qyq11/opto-chess-robot-2027/01_docs/02_design/05_底盘串口接线与测试.md

---
slug: /design/motor-uart
sidebar_position: 5
---

# 底盘串口接线与首轮测试

更新：2026-11-05。适用方案：泰山派3M RK3576通过40针排针的硬件串口，直接控制亚博四路编码器电机驱动，不加STM32。网页已接前后左右四向试转；历史“只查询”阶段及电脑USB台架流程保留，分别登记验证范围。

本文是本车直连驱动的接线、厂家命令用法与验收边界的统一入口。驱动线上使用厂家原协议，项目不另外增加帧头、序号或校验字段。任务勾选只在[开发计划](../01_plans/01_开发计划.md)维护，实际结果统一见[底盘串口记录](../03_records/04_20261030_底盘串口调试.md)。2026-11-05已在无电脑USB供电下取得真实查询和网页架空慢速前后、停车的阶段结果；用户随后确认四向实际移动均可以，按用户现场报告登记基础移动已打通。地面距离与跑偏、准确轮速、带载供电及异常停车仍未验收。

## 相机网页前后与左右平移 {#web-motion}

电脑连接固定热点 `opto-robot-b`，打开[小车工作台](http://192.168.137.16:8080/)。页面左侧看相机画面，右侧选择速度、时间和运动方向；窄屏先显示画面，再显示控制区。更新后按Ctrl+F5刷新，点“读取驱动”，取得类型2、13线、减速比20、轮径65mm的完整真实配置，再架空并勾选现场确认。

目标轮速使用滑杆或数字框，范围2～30厘米/秒、每档1厘米/秒，默认6；运行时间1～10秒、每档1秒，默认3。按钮旁显示本次选值，前进、后退、左移、右移共用这组参数。左右以车头方向为准，表示保持车头朝向的横向平移。较高档位会提示先架空核对，可选择不代表各档都已实车验收。时间包含起步，短时间、高目标时可能尚未升到目标就结束。

### 四轮方向组合

采用[厂家麦轮原理说明](https://www.yahboom.net/study/RASPBOT-V2/12113/)中的X形安装：俯视四轮小滚子的轴线呈X形。本车通道顺序为左前M1、左后M2、右前M3、右后M4。下表正号表示该轮让车前进时的转向；发送时再乘该轮的接线方向校正值。

| 动作 | 左前M1 | 左后M2 | 右前M3 | 右后M4 |
| --- | --- | --- | --- | --- |
| 前进forward | + | + | + | + |
| 后退backward | − | − | − | − |
| 左移left | − | + | + | − |
| 右移right | + | − | − | + |

例如左移目标6厘米/秒，未反接时缓升到 `$spd:-60,60,60,-60#`；右移为 `$spd:60,-60,-60,60#`。方向校正应先用前进确认每个车轮，不能通过只改某一轮来把左右互换。架空时只能检查轮组、方向和停车；车身是否平移、是否跑偏必须在实际地面另测。轮序或麦轮左右旋安装不符时，先修正安装和通道对应。

### 起步、调速与停车

点击任一方向后，RK先以20毫米/秒起步，每约200毫秒向本次目标增减最多20毫米/秒，最后一步停在所选目标，不越过目标。四轮分别按上表取正负号；各轮接线方向可在停止后校对。网页显示本次方向、剩余时间、当前目标和驱动实际回报的轮速，按左前M1、右前M3、左后M2、右后M4排列。

运行时修改参数输入，默认作为下一次设置。若要改变正在运行的速度，点“应用当前速度”；只改变目标并缓慢变速，保留原停止时刻。时间输入的变化只对下一次启动生效，本轮没有“给当前动作续时”的按钮。运行中拒绝再次启动和直接反向，先停稳再换方向。“停止输出”始终可点，运行时也可按Esc。

RK独立线程计时，到时依次发送零速度 `$spd:0,0,0,0#` 和零输出 `$pwm:0,0,0,0#`。停止后作废旧请求的状态序号，防止延迟点击重启动作；串口发送错误后拒绝继续启动。开始时临时发送 `$upload:1,0,1#` 开启编码器计数和轮速回报，本次原定停止时间结束约0.7秒后关闭。启动后250毫秒没有有效轮速反馈，会尝试归零、撤销可启动状态，提示排查供电与串口后重新读取驱动。

软件停车依赖RK及串口仍工作，不能保证整板死机、断线或动力异常时停车。驱动按编码器计算的轮速须与实物对照，不能直接当作准确车身速度、位移或外部测速结果。地面与独立失联保护仍按第6节验收。

### 网页与RK接口

由原服务参数 `--motor-port /dev/ttyS4` 启用。`GET /api/motion`只读状态，包含允许范围 `limits`、本次目标和时间、`remaining_ms`剩余毫秒、`active_speed_mm_s`当前发出的目标档位、`actual_mm_s`四轮实际回报及原始收发。无有效采样时实际速度为null，不补造零速。

`POST /api/motion`使用表单编码及 `X-Motion-Control: 1` 请求头；写入操作只允许来自本页。参数由RK独立检查，不能依靠滑杆限制；不接受任意串口文本或直接输出测试请求。

| action操作 | 使用参数 | 行为 |
| --- | --- | --- |
| query读取驱动 | 无需运动参数 | 归零后只查询当前配置，不写保存参数 |
| forward前进、backward后退、left左移、right右移 | generation状态序号，speed_mm_s目标轮速，duration_ms运行时间，可附m1～m4接线方向校正 | 只在就绪且已停止时启动，运行中拒绝再次启动或换方向 |
| speed应用当前速度 | 仅action、generation、speed_mm_s三项 | 仅正在运行时接受；不改变方向、原截止时间或反馈窗口 |
| stop停止输出 | 不需要状态序号 | 随时尝试归零；停止后旧序号作废 |

网页速度乘10传为毫米/秒，RK允许20～300、步长10；秒数乘1000传为毫秒，允许1000～10000、步长1000。四向请求省略速度或时间时，兼容使用默认60毫米/秒、3000毫秒；页面正常操作会明确提交。空值、负数、小数、超限或错误步长均拒绝。speed请求必须明确提交速度，并拒绝附带时间或方向。临近截止时到达的调速请求也不能重启动作。

正式程序：[C运动控制](../../02_programs/01_host/03_camera/motor_control.c)、[网页脚本](../../02_programs/01_host/03_camera/web/motion.js)、[控制区样式](../../02_programs/01_host/03_camera/web/motion.css)。方向设置不写驱动、不保存，刷新恢复初始值。运行期间页面隐藏或关闭会尽力补发停止，原截止时间仍由板端执行。

2026-11-05已完成板B原生编译、虚拟串口的范围/缓升/调速不续时/停车检查及部署。用户确认新版布局正常、变速后按原定时间停止，随后确认左右架空轮组相反、都能自动停止，进一步确认前后左右实际移动均可以。参数检查见[参数改版记录](../03_records/04_20261030_底盘串口调试.md#web-motion-controls-20261105)，左右实际收发见[同一底盘记录的左右试转](../03_records/04_20261030_底盘串口调试.md#web-motion-lateral-20261105)，新增报告见[四向移动用户确认](../03_records/04_20261030_底盘串口调试.md#ground-motion-confirmation-20261105)。其余档位、地面距离与跑偏仍按[开发计划](../01_plans/01_开发计划.md#motion-controls-plan)推进。

## 网页按距离前进 {#web-distance}

首版已完成源码准备，待板B上电后检查和部署。新版页面仍从原小车工作台打开。点击“读取驱动”，按第6节确认现场可停机，再在“按距离前进”勾选现场确认，输入5～50厘米的整数，默认20厘米，点击“前进指定距离”。可以随时点“停止输出”或按 Esc。

RK等到第一帧四轮累计计数才发出起步速度，然后比较后续计数与起点的差值。按65毫米轮径、13线、减速比20，首版暂用双相四倍计数，即每轮转一圈约1040计数。四轮按各自方向校正后求平均，得到网页上的轮子估计距离。旧日志中轮速最小变化约19.63毫米/秒，与这一换算下每10毫秒增加1计数相符。轮子有效周长、计数与车身位移仍以架空和地面实测为准。[厂家串口示例](https://www.yahboom.net/study/Quad-MD-Module/13998/)

板端从2厘米/秒起步，最高目标轮速为6厘米/秒，估计剩余4厘米内逐步降到2厘米/秒。达到目标时依次发 `$spd:0,0,0,0#` 和 `$pwm:0,0,0,0#`，短时继续采集计数以记录停车后的少量转动。未收到计数基准、反馈中断、计数突变、明显反向、持续无进展或运行满15秒时尝试停车，并在页面显示原因。估算和软件停车依赖驱动反馈、RK及串口。现场停机与失联保护仍按[第6节](#6-异常测试与落地条件)核对。

沿用 `POST /api/motion`。定距离使用 `action=distance`、`generation` 和 `distance_mm`，可附各轮方向 `m1`～`m4`。距离使用50～500毫米、每档10毫米，页面换算成厘米。定距离运行期间由RK管理轮速。状态接口提供四轮累计计数 `encoder_counts`、估计距离 `estimated_mm`、剩余距离 `remaining_mm` 和停车原因 `stop_reason`。

### 上板和尺测

在项目根目录打开 PowerShell。板B接入热点后，下面命令核对板B专用SSH指纹和序列号，上传源码、在板端编译并通过虚拟串口检查两种控制方式。无线地址变更时用热点显示的实际地址。

```powershell
& .\02_programs\01_host\03_camera\prepare_distance.ps1 -BoardHost 192.168.137.16
```

通过后，用下面命令复跑检查、备份现有工作台并部署。部署后检查网页按钮、运动接口和相机新画面。整个脚本通过读取接口核验服务，真实电机动作由现场用户点击启动。[部署脚本](../../02_programs/01_host/03_camera/prepare_distance.ps1)

```powershell
& .\02_programs\01_host\03_camera\prepare_distance.ps1 -BoardHost 192.168.137.16 -Install
```

首轮先架空检查计数变化、各轮方向和停车。落地条件就绪后，在平整地面贴起点，用车身同一位置作参考点。点击“前进指定距离”走20厘米，停稳后记下网页估计值和停车原因，用尺子量沿预期方向的实际位移，同时记侧向偏移和车头朝向。将目标、估计、尺测、轮速及串口收发记到同一份底盘调试记录。[原底盘调试记录](../03_records/04_20261030_底盘串口调试.md)

## 本轮只查询（2026-11-04）

本轮只完成“RK发送一条不改变配置的查询 → 驱动真实回复 → RK接收并显示”。用户确认UART4三根线按下述关系接好。外部供电时两次查询均无回复，用户报告3V3仅约2V；电脑USB接驱动Type-C后恢复约3.3V，16:49的RK配置查询收到150字节有效回复，阶段链路已打通。当前供电排查见[同一记录](../03_records/04_20261030_底盘串口调试.md#usb辅助供电后配置查询通过)，不将USB条件下的结果套用为电池独立供电。相机换过接口，本次未操作相机服务。下文转轮、参数写入、零PWM和反馈开关流程保留供以后选用，本轮均不执行。

先看[整机接线总图](../../05_data/03_results/01_design/04_稳压板接线示意.png)：电源、串口和输入输出已放在同一张图，虚线为拟接且尚未验证。图示不能替代实物针位、电平与极性核对。

2026-11-05补充：更换Wi-Fi后，已改经电脑USB网口的本地IPv6连接板B，再次完成一次配置查询和150字节真实回复，见[有线复测](../03_records/04_20261030_底盘串口调试.md#uart-recheck-20261105)。电脑网口编号从此前7变为6；使用前按实际网卡状态重新核对。本次未重新核供电接法、电压或电机动作。

已协调同板窗口后，对序列号 `8314b1e8ffd0321f` 的板B完成只读检查：`/dev/ttyS4` 指向设备树 `serial@2ad70000`，GPIO2_D0/D1当前复用为UART4；未见程序打开该口，系统登录使用 `ttyFIQ0`。因此**优先UART4**，对应规格书物理8脚TX、10脚RX、6脚GND。节点与复用已实查，实物硬件版本、排针方向和双方电平仍待确认，不能直接把“节点存在”当成可以接通。证据见[同一底盘记录](../03_records/04_20261030_底盘串口调试.md#rk串口选择与接线准备2026-11-04)。

三根信号线的功能关系仍为RK TX→驱动RX2、RK RX←驱动TX2、GND互连；驱动插头5V不连接RK。必须先对应实际丝印，电平兼容后在双方断电时接拆；同板现有程序需保留，涉及断电先与移植窗口协调，不直接拔电。

接好后使用[C/GCC查询程序](../../02_programs/01_host/04_motor_uart/motor_query.c)，显式指定已核实节点，115200波特、8数据位、无校验、1停止位、无流控；一次只发送 `$read_flash#`，或按实际排查选择 `$read_vol#`，不加额外换行、不自动重发。**配置查询的真实回复是以 `read_flash:OK!` 开头的多行文本，不含 `#` 结束符；电压回复才是 `$Battery:…V#` 帧。** 程序分别识别，保存原始字节后再解析；配置必须包含完整字段和末行换行，截断或仅回显命令不能通过。程序已完成ARM64 GCC交叉编译、静态检查及板B原生GCC编译运行，USB辅助供电后的150字节配置已正确解析；连接、操作命令和原始结果见[同一调试记录](../03_records/04_20261030_底盘串口调试.md#usb辅助供电后配置查询通过)。

## 电脑先调试

2026-10-30用户首次查询显示固件1.7.3及520默认配置；12:17:34的后续日志已确认本车310类型2、13线、减速比20、65mm轮径读回正确，详见[同一份记录](../03_records/04_20261030_底盘串口调试.md#参数修改后的读回确认)。随后用户确认电机接线正确，但12:20仍只接USB、没有动力电池，尝试转轮无动作且没有新回包；重新拔插USB后，12:23:06配置查询恢复，四项参数仍正确。最新用户报告驱动板、稳压板已接通电源，串口已连接；尚未提供本次电压、配置回包或电机动作结果。当前先保持零输出，查询电压和配置；转轮、停车和先前无回包的根因仍待验证。以下配置命令保留供复现，读回正确时不重复写入。电脑上的串口助手只负责发送厂家命令，不需要另加STM32或重烧驱动固件。

**最终电池为用户已有普瑞莱11.1V／2200mAh电池，充电截止12.6V、最大持续4A。现用旧小车电源模块的型号与输出能力待核。本轮供电优先采用[11.1V电池经旧模块输出5V的轻载接法](./03_系统规划.md#现有111v电池的5v轻载试验接法2026-10-30)。** 下文2S电池直接供动力的内容保留作该方案说明，不用于当前11.1V电池。当前驱动输入应为稳压后的约5V，用万用表实测驱动动力端子，并与查询值比较；仍回复先前的3.9V、无有效回复或读数明显不符时先排查，不发送非零速度。不能把11.1V电池直接接入当前310动力支路。本轮只安排单轮架空短测，四轮及RK同时带载供电尚未验收。

### 软件与串口设置

当前实际测试电机按此前确认接驱动板M3（第3路），最新用户已报告驱动板与稳压板通电。先前仅USB供电时电压回复3.9V，不作为本次动力供电结果。下列电脑单轮流程已按M3调整；后面的RK四轮流程仍按M1–M4逐路验收。

厂家[UartAssist 5.0.3原件](../../03_hardware/01_机械/01_厂家资料/03_四路电机驱动/13_UartAssist_5.0.3.exe)及[电脑调试教程](../../03_hardware/01_机械/01_厂家资料/03_四路电机驱动/14_PC串口调试.pdf)已提取到正式资料目录。为把运行设置留在临时目录，调试时使用项目`temp/motor-uart/`里的软件副本。电脑通过USB数据线直接接驱动板Type-C口，不需要另外接USB转TTL小板；此阶段不接RK的TX/RX。

先在Windows设备管理器查看“端口（COM和LPT）”，比较插入/拔出这块板时新增/消失的串口。蓝牙串口不能作为电机驱动串口；若没有新增设备，先换确认能传数据的线、直连电脑USB口。若新增的是未知设备，按其硬件标识确认芯片和匹配驱动，不凭猜测安装。

串口助手左上角选择已确认的COM口，设置115200波特、数据位8、校验位NONE、停止位1、流控NONE。接收和发送均选ASCII（文本），不要选HEX（十六进制）；取消“自动发送附加位”“循环周期”，保留命令中的英文符号。点击“打开”后按钮应变成“关闭”，这只证明端口已打开，还要核对真实回包。不要用软件窗口关闭来代替电机停车。

### 断电后连接单台电机，当前用M3

先拔掉USB，保持电池未接。电机固定牢、轮子悬空，驱动板垫绝缘材料；碳纤维板导电，不能让焊点直接贴底板。先接一台310，其余三路空着。

若使用厂家原配PH2.0六针双头线，按厂家说明黑色端接310电机，白色端接驱动板编码器电机接口，并核实际插壳、锁扣和丝印；不强插反向插头。若电机端是六针插头、驱动端是六个分散杜邦头，按下表接驱动第3组IO插座，不凭线颜色或照片左右猜针序。

| 电机丝印 | 驱动板第3组信号 | 用途 |
| --- | --- | --- |
| M1 | 第3路动力M+ | 电机动力正端 |
| M2 | 第3路动力M− | 电机动力负端 |
| V | 3V3 | 编码器供电 |
| G | GND | 编码器地 |
| A | H3A | 编码器A信号 |
| B | H3B | 编码器B信号 |

电机本体的M1/M2是两根动力线，驱动板的M1–M4是四个电机通道，含义不同。M+/M−必须属于同一第3组，H3A/H3B也属于这一组。若实物丝印、线束或接口与资料不同，先拍清板上接口和六根线再核对，不能按此表猜物理位置。依据[厂家电脑教程](https://www.yahboom.net/study/MD310/14019/)及[310接法](https://www.yahboom.net/study/MD310/14018/)；厂家表中以第1组为例，此处按同样功能对应到第3组。

动力电源用本车7.4V/2S电池，满充8.4V。电池正极经已核实的保险/开关接驱动动力输入正极，负极接动力输入负极；按板上实际电源丝印核极性，不能接到辅助5V/3V3口。USB不作为电机动力电源。接电池前检查无裸铜相碰、轮子已架空、随手能切断动力。电源和线束未核实时先停在USB识别步骤。

### 动力是否需要经过稳压板

本车2S电池接电机驱动的动力支路，不经过5V稳压板；稳压板只在计算支路把电池电压降成5V给RK，接法见[系统规划第6.1节](./03_系统规划.md#61-电池降压板驱动到底怎么接)。当前只测电脑与电机，先核清动力支路，RK和稳压板暂不接入本次单轮测试。

| 部位标识 | 输入或输出 | 本车用途 |
| --- | --- | --- |
| 电池XT60主放电口 | 电池输出 | 经匹配取电线、保险/开关和分电接动力支路；不按插壳公母简称猜配对 |
| 驱动DC5V～12V的+／−端 | 驱动动力输入 | 接电池动力支路正负端，不接到电机M+/M−或辅助低压接口 |
| 稳压板IN+／IN−、DC6～24V-IN | 稳压板输入 | 接电池计算支路正负端 |
| 稳压板DC5V-OUT、Type-C输出 | 稳压板输出 | 给RK的Power Type-C供电 |

采购登记的电池是XT60，驱动附带线是T插到红黑裸线，两者不能直接对插。现有正式方案使用XT60取电及绝缘分电，不默认新增XT60转T插。实际是否缺线要按现物核对，不把裸线临时塞进电池插头，也不用小平衡插头承载电机电流。接电前先把软件发送框中的非零速度改成零PWM并发送，再关串口、拔USB；没有电源端子和线束实物依据时，先核照片而不按商品图位置猜正负。

2026-10-30已按用户指定京东链接核对[对应规格电池图](../../05_data/01_raw/04_hardware/20261030_battery_reference_01.jpg)：黄色XT60插孔端是主放电口，应使用配对的金属插针端成品取电线；白色小插头用于平衡检测和充电辅助，不接驱动动力。图和SKU核对过程见[同一调试记录](../03_records/04_20261030_底盘串口调试.md#按用户指定商品页核对电池插头)。在电池和USB断开时，动力支路红线经保险/开关接驱动DC5V～12V输入“+”，黑线接输入“−”，按实际丝印核极性。压好端头后插入夹线孔、拧紧并轻拉检查，最后才对插电池；现有取电线、保护件未确认配齐时不安排上电。

原配T插电源线并非不能使用：剥开的红黑线可接驱动动力端子，只是红色T插不能直接插黄色XT60。电脑单轮台架若保留原配线，可配XT60金属插针端至T插金属插孔端成品转接头，常见名称“XT60公转T插母”；按两端触点和极性核对，不能买反向版本。[厂家同方向产品](https://genstattu.com/xt60-male-to-deans-t-female-adapter/)仅作类型参考，未在本车实测。保险/开关仍需落实；正式整车分电主线保持原定义，不因临时台架配接增加一套重复采购。

### 先查询，再配置，最后短时转轮

以下每个代码块是要填入串口助手“数据发送”框的一条文本，只点击一次“发送”，不加引号。先按上述方式确认端口、接线和供电，保持零输出：

```text
$pwm:0,0,0,0#
```

查询配置，应收到包含电机类型、线数、减速比、轮径等字段的实际返回；只看到发送栏回显不算通信通过。

```text
$read_flash#
```

查询电压，应收到`$Battery:实际电压V#`形式的帧，并与电源测量核对。只接USB时查询是否回复取决于实际板卡供电设计；没有回复时不能立即判断为软件故障，也不要发送转动命令。

```text
$read_vol#
```

收到有效回包后，逐条配置，每条等待实际确认再继续。按本车310编码器A→A、B→B、13线、1:20、65mm轮设置；不能照抄厂家48mm轮径，也不改PID或恢复出厂。

```text
$mtype:2#
```

```text
$mline:13#
```

```text
$mphase:20#
```

```text
$wdiameter:65#
```

```text
$read_flash#
```

确认返回类型2、13线、减速比20、轮径65。保持零PWM，开启编码器总计数及轮速反馈，再手动慢转轮子，核对只有第3通道变化。

```text
$upload:1,0,1#
```

回包应含`$MAll:…#`和`$MSPD:…#`。手动转轮后放开，确定动力停机手段可用，再用下列命令测试第3路低速。提前把下面的停止命令加入软件“快捷指令”，确认如何单击发送；低速运行约0.5秒后立即发送零速度。若不能可靠完成短时动作和停止，先不要发送启动命令。这里的持续时间由操作者控制，速度命令本身没有持续时间字段。

速度单位为mm/s（毫米每秒），依据[厂家串口示例](https://www.yahboom.net/study/MD310/14033/)及归档STM32示例`USER/main.c`第3～4行。第三项50表示M3目标轮缘线速度50mm/s，即5cm/s；按65mm轮径计算约14.7转/分钟、4.08秒一圈，所以本轮目标本身很低。`$MSPD`第三项是驱动计算的M3实际轮速，应结合编码器配置与实物转动核对；计算值不作为实测结果，也不能直接当作麦轮整车行驶速度。

```text
$spd:0,0,50,0#
```

```text
$spd:0,0,0,0#
```

核实际转轮、原始反馈和停车；速度指令不返回OK，不能因没OK重复加速。反转同样短时执行，随后再次发送上面的零速度。

```text
$spd:0,0,-50,0#
```

结束前使用零PWM关闭主动输出，再按实际板卡供电说明关电；接拆电机线必须使USB与电池都断开。

```text
$pwm:0,0,0,0#
```

零速度仍有主动调速，不能在此模式用手强拧。断USB或关闭软件可能保留最后速度，失联停车需要另测。电脑测试只确认所测电机、驱动和USB通信，不代表RK40针串口、四轮整车或异常停车已通过。实测开始后，真实收发、接线照片和动作证据统一追加到底盘串口记录；没有真实结果前不创建完成记录。

## 1. 首轮要证明什么

先不接摄像头：RK能查询驱动配置和电压、收到四轮编码器/轮速；逐轮短时低速正转、反转并停车，驱动口、实物轮子和反馈通道一一对应。首轮先用下面的Bash手动联调，正式运动服务后续用C实现。轮速闭环由驱动板负责，RK负责整车速度换算、限速、动作有效期和反馈管理。

正常停车与失联停车分开验收。RK程序仍能发出停止命令，不证明RK卡死、串口断线或驱动失电时也能停车。

## 2. 上电前的接线核对

### 2.1 先确认RK针脚，再接信号线

归档[泰山派规格书](../../04_references/04_datasheets/01_泰山派3M_RK3576_规格书.pdf)第8页给出以下**资料候选**。第1页图示板丝印V1.3，但尚未确认与本车实物相同。2026-10-30访问[官方40针说明](https://wiki.lckfb.com/zh-hans/tspi-3-rk3576/hardware-gpio/taishanpi-3m/v1-0.html)时，正文没有可读针表，不能用该网页补齐实物确认。

| 信号 | 规格书候选物理针号 | 规格书功能名 | 本车状态 |
| --- | --- | --- | --- |
| RK发送TX | 8 | UART4_TX_M0 / GPIO2_D0 | 候选，待实物版本、原理图与镜像核对 |
| RK接收RX | 10 | UART4_RX_M0 / GPIO2_D1 | 候选，须与TX属于同一路硬件UART |
| 信号地 | 6 | GND | 待按实物针1方向核对；其他GND脚也须有明确依据 |

**此表不能直接当作已批准上电的针位。** 物理针号是排针位置，GPIO名称是芯片信号，两者不能混用；UART4也不自动等于Linux的某个固定设备名。按本车版本原理图、排针方向和镜像配置填齐以下信息，再接TX/RX：

| 必须确认的事项 | 需保存的依据 | 当前状态 |
| --- | --- | --- |
| RK板版本、针1位置、TX/RX/GND物理位置 | 实物正反面照片、对应原理图版本 | 待核 |
| RK与驱动串口的逻辑电压及允许输入范围 | 双方规格；必要时测空闲电平/波形，测量不能替代耐压规格 | 待核；不假定40针全部为3.3V |
| UART复用、驱动和实际设备节点 | 镜像/内核版本、已启用配置、实际节点与引脚映射 | 2026-11-04板B已实查UART4为`/dev/ttyS4`、GPIO2_D0/D1复用；实际排针仍待核 |
| 该口不用于系统登录/启动日志 | 内核命令行、登录服务和串口占用检查 | 同次快照登录为`ttyFIQ0`，未见程序打开`ttyS4`；真正收发前再核占用 |
| 一侧掉电时不会经TX/RX反向供电 | 器件断电容忍规格或支持断电隔离的转换器件及验证 | 待核；仅拔掉5V线不能证明无反灌 |

两端电平不兼容时，增加匹配UART方向及速率的电平转换；不向未知RK信号脚送5V。驱动失电条件未落实前，先用确认支持断电隔离的接口；没有该条件时，在双方都断电时接拆信号，并采用双方一起上下电的台架步骤，暂不进行带信号的独立动力掉电试验。

### 2.2 信号与电源怎么接

| 连接 | 接法 | 核对重点 |
| --- | --- | --- |
| RK40针硬件UART → 驱动 | RK TX→驱动RX2，RK RX←驱动TX2，GND↔GND | 三芯短线，按功能交叉；针位/电平核实后才接 |
| 驱动串口插头5V线 | 悬空、单独绝缘 | RK与驱动各自供电，不把两板5V相连 |
| 动力 | 已购2S电池经保险/开关、分电、F1/S1接驱动输入正负端 | 满充8.4V；核实际极性、端子及保护，电机电流不经过RK排针 |
| RK | 计算支路稳压5V，经合适Type-C线接Power口 | 不用驱动辅助5V给RK供电；Type-C与排针不同时供电 |
| 共地 | 两支路在分电处共享负参考，UART再接短信号GND | 电机大电流负线直接回分电，不沿细串口GND回流 |
| 固定 | RK和驱动用绝缘支柱，线束固定 | 碳纤维导电；四轮架空固定，不手持运行 |

完整供电与线束见[系统规划第6节](./03_系统规划.md#6-整车供电图与电源安排)。先确认随手可切断动力；测试中的“发送停止”不能替代实际观察轮子停止。

### 2.3 电机、编码器与轮序

以确定的车头为前，从车自身看左右。四路驱动M1=左前、M2=左后、M3=右前、M4=右后；先贴标签，再按实物逐轮确认。电机本体的M1/M2是两根动力线，与驱动组号M1–M4含义不同。

| 310电机端 | 驱动第n组端 | 说明 |
| --- | --- | --- |
| M1 / M2 | Mn+ / Mn− | 该轮动力线 |
| V / G | 3V3 / GND | 编码器电源与地，按实际丝印及厂家配线核对 |
| A / B | HnA / HnB | 本方案采用310的A→A、B→B接法 |

每台使用原配六芯线；不能凭颜色或照片左右顺序判断插壳。四组编码器只接驱动板。接法依据[厂家310说明](https://www.yahboom.net/study/MD310/14018/)，实际正方向通过下面的单轮测试登记，不假定四路正数都让整车前进。

## 3. 在RK上准备硬件串口

以下是可复用的RK只读检查方法。2026-11-04已协调后执行本轮需要的身份、命令行、设备节点、插件状态与占用检查，结果见本轮记录，不需要从头重复；尚未打开串口、收发或更改配置。不在Windows本机模拟电机验证。核查时记录系统型号、镜像发行版本与内核。

```bash
tr '\0' '\n' < /proc/device-tree/model
```

```bash
cat /etc/os-release
```

```bash
uname -a
```

```bash
cat /proc/cmdline
```

如果当前镜像提供立创`ovtree`，先只读查看可用及已启用配置；没有该工具时，按当前镜像说明核对设备树，不盲目安装或套用其他板卡配置。

```bash
sudo ovtree list
```

```bash
sudo ovtree status
```

确认具体UART插件及复用冲突后，才按[官方工具说明](https://wiki.lckfb.com/zh-hans/tspi-3-rk3576/sys-tool/ovtree.html)启用所选配置并按镜像要求重新加载或重启。保存实际改动和原配置，以便恢复；本文不指定尚未核实的插件文件名。

```bash
ls -l /dev/ttyS*
```

节点存在只证明系统创建了设备，不能证明它对应所选排针。还要检查对应登录服务和占用；确认端口后的占用核对命令见下一节。专用调试口不用于本轮驱动控制。

## 4. 建立可核对的发送与接收窗口

以下适用于具备Bash、GNU串口工具与串口访问权限的RK Linux。权限不足时按镜像说明配置串口用户组或在获授权的管理员终端执行，不把设备权限改成所有人可写。Buildroot若缺少工具，应先核工具选项或改用后续C测试程序，不能把下面命令成功退出视为通信通过。

在RK项目目录打开两个终端A、B；两个终端都先设置同一个已核对端口。**必须先将占位内容替换为实际节点**，不以规格书的UART编号猜节点。

```bash
export MOTOR_PORT='/dev/已核对的实际串口节点'
```

```bash
test -c "$MOTOR_PORT"
```

```bash
fuser -v "$MOTOR_PORT"
```

```bash
systemctl status "serial-getty@${MOTOR_PORT##*/}.service" --no-pager
```

没有systemd的镜像用对应登录管理方式核对；发现该口用于登录/其他程序时，先处理占用并保存改动，不与其同时打开。接收端只保留一个读者，防止两个程序分走回包。

两个终端都设置本轮日志目录；不同轮测试改目录名，不覆盖旧日志。

```bash
export MOTOR_LOG_DIR='temp/motor_uart/first_run'
```

```bash
mkdir -p "$MOTOR_LOG_DIR"
```

在终端A配置串口。`115200/8N1`表示115200波特、8数据位、无校验、1停止位；同时关闭硬件/软件流控及本地回显。

```bash
stty -F "$MOTOR_PORT" 115200 raw -echo -ixon -ixoff -crtscts cs8 -parenb -cstopb min 1 time 0
```

在终端A持续显示并保存驱动→RK的原始字节。电压、轮速与编码器等回包可能连续排列，以`#`分帧；配置查询则返回多行普通文本，见本轮说明。日志保留原样，不补写成看起来成功的回复。Ctrl+C只停止接收窗口，不代表电机停止。

```bash
stdbuf -o0 cat "$MOTOR_PORT" | tee -a "$MOTOR_LOG_DIR/rx_raw.log"
```

在终端B整体复制以下**Bash函数定义**，用于显示本地时间、串口、方向、编号和实际发送字符串。编号只写在日志，不发送给驱动；函数内部命令共同完成一次发送。

```bash
motor_send() {
  test -c "$MOTOR_PORT" || { printf '串口节点未核实或不存在\n' >&2; return 1; }
  MOTOR_SEQ=$(( ${MOTOR_SEQ:-0} + 1 ))
  printf '[%s] RK(%s) -> 驱动 [%s-%s] %s\n' "$(date '+%Y-%m-%dT%H:%M:%S%z')" "$MOTOR_PORT" "$BASHPID" "$MOTOR_SEQ" "$1" | tee -a "$MOTOR_LOG_DIR/tx.log"
  printf '%s' "$1" > "$MOTOR_PORT"
}
```

命令字符串必须用单引号包住，避免Bash把`$`开头内容当变量。只发送厂家帧本身，不附加本地序号；函数打印的TX是发送尝试，配置回包、编码器变化和实物动作才是执行依据。

## 5. 按顺序做首轮测试

### 5.1 保持零输出，先查参数

双方正确上电、车轮架空、停止操作已准备好后，先发送零PWM输出。

```bash
motor_send '$pwm:0,0,0,0#'
```

```bash
motor_send '$read_flash#'
```

```bash
motor_send '$read_vol#'
```

应看到驱动的实际配置查询回复和电压帧；手册电压格式示例为`$Battery:7.40V#`，这里的7.40只是格式示例，不是本车实测值。用万用表核对实际电源电压；没有有效回包时停留在供电/串口排查，不进入转轮测试。

### 5.2 设置310与65mm轮参数，再读回

每条单独发送，等待实际回复或驱动重启后稳定再执行下一条；不循环写入持久参数。

```bash
motor_send '$mtype:2#'
```

```bash
motor_send '$mline:13#'
```

```bash
motor_send '$mphase:20#'
```

```bash
motor_send '$wdiameter:65#'
```

```bash
motor_send '$read_flash#'
```

保存每条实际回复与最终配置全文，核对类型2、13线、1:20、轮径65mm。初轮沿用厂家PID，不发送PID修改、恢复出厂或固件烧写命令；改PID会引起重启，不能在运动时试改。

### 5.3 手动转轮核编码器

```bash
motor_send '$pwm:0,0,0,0#'
```

```bash
motor_send '$upload:1,0,1#'
```

应收到`$MAll:…#`总计数和`$MSPD:…#`轮速原始帧。逐个慢慢转动一个轮子，核对只有对应通道随之变化；记录正反方向。对轮胎作记号，转一整圈，比较起止总计数差；13×20×4=1040是四倍频口径下的名义计数/输出轴转，须核对当前固件实际口径。若幅值、符号或通道不符，先排查六芯线、编码器相位与配置。

只有零输出状态才做手动转轮；零速度模式仍在主动控制，不用手强拧运行中的轮子。上传开关通常不掉电保存，重上电后重新核对。

### 5.4 单轮短时正转、反转、停车

在终端B整体复制以下函数定义。一次调用发送速度、等待约0.5秒并尝试归零；Ctrl+C/TERM退出也尝试发送零速度。该机制依赖RK和串口仍工作，断电、SIGKILL、进程冻结或串口故障不能由它保证停车。

```bash
motor_pulse() (
  MOTOR_STOP_FRAME='$spd:0,0,0,0#'
  trap 'motor_send "$MOTOR_STOP_FRAME"' EXIT
  trap 'exit 130' INT
  trap 'exit 143' TERM
  motor_send "$1" || exit 1
  sleep 0.5
)
```

先测左前M1。50是低速起点，厂家Linux例程将速度解释为轮周线速度mm/s；具体固件单位应与回传及一圈计数核对。低速不转或抖动时先检查原因，不直接大幅提高命令。

```bash
motor_pulse '$spd:50,0,0,0#'
```

```bash
motor_pulse '$spd:-50,0,0,0#'
```

随后逐轮执行，每次确认前一轮已停；四个值按M1、M2、M3、M4排列。

```bash
motor_pulse '$spd:0,50,0,0#'
```

```bash
motor_pulse '$spd:0,-50,0,0#'
```

```bash
motor_pulse '$spd:0,0,50,0#'
```

```bash
motor_pulse '$spd:0,0,-50,0#'
```

```bash
motor_pulse '$spd:0,0,0,50#'
```

```bash
motor_pulse '$spd:0,0,0,-50#'
```

每次保存发送与归零帧、对应原始反馈及轮子视频，登记实际位置、方向和停止表现；其他三轮应保持停止。速度命令按手册**不返回确认帧**，不能因没有OK而重复加大发送；也不能只凭写串口成功判定运动成功。

### 5.5 区分三种停止状态

零速度：驱动仍执行PID，主动维持零转速。

```bash
motor_send '$spd:0,0,0,0#'
```

零PWM：关闭主动输出；实际滑行/制动与阻力按板卡实测，不能把它称为机械刹车或保证立即停止。

```bash
motor_send '$pwm:0,0,0,0#'
```

第三种是通过已核实的动力停机开关切断驱动电源，验证前必须满足第2节的掉电接口条件。记录各状态停止耗时、反馈与实物现象；结束前先零输出，按已核实顺序关电。

## 6. 异常测试与落地条件

正常动作通过后，仍先架空。分别核对“应用不再产生新目标”“发送进程退出/冻结”“串口通信中断”“RK重新启动”“驱动重新上电”；记录最后有效命令、故障时刻、反馈是否中断、轮子多久停、是否重连后自行恢复。串口断线优先用可控的断线接口模拟，不在未知电平/掉电条件下带电拔接杜邦线。

手册没有明确承诺失联自动停车，不能假设重复发送速度就具备心跳。若驱动保持最后速度，应记录为未通过失联停车；在落地连续运行前落实经验证的驱动侧超时、硬件使能/停机回路或独立切断动力措施。人工S1可作为架空实验的停机手段，不能替代自主失联保护。同一RK上的独立进程、退出回调和看门狗也不能保证RK整机卡死时停车。

| 阶段 | 可以报告的完成范围 | 仍不能据此声称 |
| --- | --- | --- |
| 资料/流程整理 | 针位候选、供电关系、厂家命令与测试顺序已整理 | 本车针脚已确认、硬件已接通 |
| 查询与回包 | 保存真实配置/电压/编码器帧，方向和通道可核对 | 电机闭环或整车移动通过 |
| 四轮架空 | 四路低速正反转、零速度/零PWM有真实反馈与视频 | 地面距离准确、带载可靠或失联停车通过 |
| 异常保护 | 各故障下的实测停车与重连禁用有证据 | 尚未覆盖的故障也安全 |
| 落地与视觉 | 保护、供电和固定就绪后，再测前后/横移/旋转及视觉并行 | 仅轮速稳定就能准确定位或自主推棋 |

实测开始后再在记录目录维护同一份底盘串口记录，追加准备、排查、复测和验收；原始接线照片、未改写的收发日志和视频分别保留，按项目目录归档。反馈目前是接收时刻，不等同驱动的实际采样时刻；没有厂家时间戳时，不把它当精确同步数据。

## 7. 资料依据

- [厂家控制协议](https://www.yahboom.net/study/MD310/14039/)及[本地控制指令原件](../../03_hardware/01_机械/01_厂家资料/03_四路电机驱动/04_控制指令.pdf)：查询、参数、速度、PWM、反馈帧；本次已逐项核对，驱动实物固件待确认。
- [310电机接法](https://www.yahboom.net/study/MD310/14018/)：MD310Z20_7.4V、13线、1:20与六芯线定义。
- [厂家Linux主板串口示例](https://www.yahboom.net/study/MD310/14033/)：支持Linux主机直接控制、速度按mm/s解释；其USB连接仅作能力依据，本轮实际使用40针UART，不照抄示例48mm轮径。
- [泰山派开源硬件](https://wiki.lckfb.com/zh-hans/tspi-3-rk3576/open-source-hardware/)与[设备树管理工具](https://wiki.lckfb.com/zh-hans/tspi-3-rk3576/sys-tool/ovtree.html)：核对本车版本和镜像；命令示例不是已完成的配置。

所有速度、持续时间和测试顺序为本项目初轮建议；具体针位、电平、允许速率、停车能力和性能结论须由本车实测闭合。
