qyq11/opto-chess-robot-2027/01_docs/03_records/05_20261103_相机采集与电脑预览.md

# 相机采集与电脑预览

更新日期：2026-11-05。

**最新状态：2026-11-05无线调试基础链路已打通。** 固定电脑热点与板B自动连接已配置；相机换到第三组通道后补充地址插件，重启和再次上电自动回连均通过。仅无线下网页HTTP200，并收到连续三帧完整JPEG，当前720p／预览目标10帧/秒。浏览器自动目视核对受工具限制，移动范围与长时间图传另验，详见[本次无线与换口记录](#wireless-camera-20261105)。

**历史停止状态：2026-11-04按用户“先停掉相机工作台”的要求停止 `opto-camera.service`。** 核对板B序列号后执行停止，原进程PID 2787627结束；查询为 `MainPID=0`、`inactive/dead`，8080端口无监听。此次为人工停止，不计作停帧自动重启。图像处理服务当时仍为运行状态，原主控PID 5008仍存在；只停止工作台当前运行，保留开机启动设置。已把当时停止状态同步给移植总控。

**阶段安排：用户2026-11-04确认按“先逐项打通，再逐项深入”推进。** 相机此前已做到拍照并在电脑看到照片。2026-11-05本次仅为无线移动调试恢复原网页、处理相机换接口；本文保留的长时间运行、参数扩展、识别、透视和测量仍为后续深化内容，不作为本轮前置。

停止动作的[原工具回执导出](../../05_data/01_raw/04_hardware/20261104_camera_stop_receipt_01.json)包含用户原指令、完整命令、未截断输出和真实返回码0。动作所在聊天轮次为北京时间11-04 11:25:12～11:26:21，命令执行约1.233秒；回执没有给出这条命令的独立精确时刻，不把轮次起点当作停止时刻。该文件是事后从现有聊天记录导出的证据，不是重新运行命令或当时单独保存的SSH日志。整理时另在电脑读取现存SSH主机指纹，来源在回执中分开注明，未再次连接板卡。

**当前已完成：地址修正、C采集与网页服务部署、实时看图和拍照、自动/手动曝光与增益、白平衡控制，以及指定照片的亮度和相对清晰度检查。** 按用户要求降为720p（1280×720）、预览目标10帧/秒、JPEG压缩质量85，并保存此配置；4K暂不提供，1080p保留可选但尚未通过持续稳定性验证。浏览器拍照、检查画面及应用手动曝光已实测；720p通过5分钟连续状态监测。目标帧率不是已测显示帧率。棋子识别、透视校正、位置测量和更长时间联调仍待完成，任务勾选统一见[开发计划](../01_plans/01_开发计划.md#1-摄像头出图与原始画面)。

2026-11-04新增问题：常驻服务因“10秒没有发布有效新图像”自动重启，来源为移植总控的板端日志核查；不能再把短时出图作为长时稳定的依据。当前仅完成本地源码复核，深层原因未定，详见[停帧与自动恢复](#camera-stall-20261104)。

## 实际环境

| 项目 | 本次环境 |
| --- | --- |
| 主板 | 立创泰山派3M RK3576，板B，序列号 `8314b1e8ffd0321f` |
| 系统 | Ubuntu 24.04.5 LTS，ARM64，内核 `6.1.99-rt36-tspi` |
| 相机 | 用户已到货的IMX415模组，通过原厂排线连接 |
| 有线连接 | RK `192.168.100.123/24`，电脑 `192.168.100.200` |
| Wi-Fi连接 | RK `192.168.3.59/24`，电脑 `192.168.3.37`；双方远程登录已通过 |
| 驱动与工具 | `CONFIG_VIDEO_IMX415=y`，即驱动已编入内核；已有GStreamer 1.24.2、V4L2工具及 `rkaiq_3A_server` 图像处理服务 |

电脑用 `rk3576-board-b` 身份别名及专用指纹文件核对板B，SSH指纹为 `SHA256:S4ihaw0V/Z8w7v3VlJOQEFLEH3Hp6nr3KjiUTxanwPg`。电脑原有通用SSH记录中，同一有线IP曾对应另一块板，不能只按IP确认板卡身份。

## 地址问题与修正

原配置让驱动在 `0x37` 查找相机，启动时未读到有效识别值。16:15在供电、复位和输入时钟有效的条件下，实际查到相机位于I²C4总线的7位地址 `0x1a`，读取检查寄存器 `0x311a` 得到 `0xe0`，符合当前驱动判据。诊断结束后已恢复相关资源并卸载临时模块。

用户授权后，采用官方支持的[启动配置插件方式](https://wiki.lckfb.com/zh-hans/tspi-3-rk3576/sys-tool/ovtree.html)修正地址：

- 新增 `lckfb-imx415-i2c4-1a.dtbo`，把I²C4下IMX415的 `reg` 地址从 `0x37` 改为 `0x1a`，并禁用同一接口上备用的GC05A2节点。
- 原IMX415节点名 `imx415@37` 保留，以保持原有连接关系；实际通信地址由 `reg` 属性决定。
- 原已启用的CAN、串口插件保留。未替换内核或系统镜像；重启后配置生效。

16:27重启后的正式驱动日志：

```text
imx415 4-001a: Detected imx415 id 0000e0
```

同时确认 `/sys/bus/i2c/drivers/imx415/4-001a` 已绑定，采集入口为 `/dev/video-camera0`，指向 `/dev/video33`。其余未接相机的接口仍有探测失败日志，与本次已连接相机的识别结果分别判断。

原始终端返回分别保留：[14:53修正前的失败结果](../../05_data/01_raw/04_hardware/20261103_camera_before_fix_01.txt)、[插件部署结果](../../05_data/01_raw/04_hardware/20261103_camera_overlay_deploy_01.txt)、[16:27重启后正式驱动识别结果](../../05_data/01_raw/04_hardware/20261103_camera_driver_check_01.txt)。三份文件均按原字节归档；修正前失败结果不记作修正后复测，也不把这些日志作为两轮采图的证明。

配置源码：[相机地址插件](../../02_programs/01_host/03_camera/config/lckfb-imx415-i2c4-1a.dts)。修改前后的启动配置、部署文件及SHA-256指纹见[配置备份清单](../../07_backups/01_相机地址/sources.json)。需要回退时，将清单中两份 `before` 文件恢复到各自的板端路径，再重启，恢复原插件列表。

诊断源码与原始返回分别保留在[地址检测程序](../../02_programs/01_host/03_camera/diagnostics/camera_addr_probe.c)和[地址检测输出](../../05_data/01_raw/04_hardware/20261103_camera_address_probe_01.txt)。

## 拍照与电脑取图结果

| 核对项 | 实际结果 |
| --- | --- |
| 采集方式 | 板端已有GStreamer工具，从 `/dev/video-camera0` 取帧并编码为JPEG |
| 图像参数 | NV12，1280×720，协商帧率30帧/秒，JPEG质量95 |
| 第一轮，16:28 | 连续取得60帧，约2.25秒结束；电脑打开后画面明显模糊 |
| 第二轮，16:30 | 用户重新朝向远处物体后，再次取得60帧，约2.27秒结束；电脑可见桌面、显示器和线材等现场内容，画面与第一轮不同 |
| 停止再开 | 第一轮结束后可再次启动采集，两次均正常结束 |
| 传回电脑 | 经有线SSH执行采集，SCP取回照片；文件指纹一致，电脑实际打开检查 |

本次使用的第一轮采集命令如下；其中输出目录是已清理的临时测试目录：

```bash
timeout --signal=INT --kill-after=5s 20s gst-launch-1.0 -e v4l2src device=/dev/video-camera0 io-mode=mmap num-buffers=60 ! video/x-raw,format=NV12,width=1280,height=720,framerate=30/1 ! jpegenc quality=95 ! multifilesink location=/tmp/codex-camera-capture-20261103/frame-%03d.jpg max-files=3
```

**本次测试照片和采集临时文件按用户要求不保留，已从电脑和板端清理。** 保留当前进度、采集参数、地址修正源码和回退配置；用户提供的接线照片、商家截图及手册原件保留。本次没有新增正式识别样本集。

## 上电配置核对

已对照[IMX415芯片手册](../../04_references/04_datasheets/03_IMX415-AAQR-C_Datasheet.pdf)第14、84～86页核查：配置供电为2.8V、1.8V、1.2V，处于手册规定范围；输入时钟为37.125MHz，复位为低电平有效，供电常开且共用使能脚。配置值核对不等于芯片端电压和时序波形实测，本次未进行示波器测量。

商家发来的图是第86页的**下电时序**，规定三路电源和控制信号关断的先后关系；上电时序在第84～85页。用户原始资料及来源见[接线照片](../../05_data/01_raw/04_hardware/20261103_camera_connection_01.jpg)、[商家时序截图](../../05_data/01_raw/04_hardware/20261103_camera_poweroff_sequence_01.png)和[来源清单](../../05_data/01_raw/04_hardware/sources.json)。

## 正式网页服务与参数验证

2026-11-03在板B原生GCC编译正式C服务，使用GStreamer 1.24.2与libmicrohttpd 1.0开发库，无编译警告。程序和网页部署在 `/opt/opto-camera`，系统服务 `opto-camera.service` 已启用开机启动，使用8080端口。本次部署未改内核或相机地址插件，也未停止使用5000端口的SN450业务。

随后修正停止采集时晚到帧的处理，并延长参数请求的服务端连接超时；在板B再次编译成功，只重启本轮 `opto-camera.service`，保存的4K／10帧/秒／JPEG质量90配置自动恢复。此次没有重启板卡或图像自动调节服务，不能代替RK重启后的恢复验收。

正式文件：[C采集与HTTP服务](../../02_programs/01_host/03_camera/camera_web.c)、[Makefile编译配置](../../02_programs/01_host/03_camera/Makefile)、[系统服务配置](../../02_programs/01_host/03_camera/config/opto-camera.service)、[网页](../../02_programs/01_host/03_camera/web/index.html)、[样式](../../02_programs/01_host/03_camera/web/app.css)、[网页操作脚本](../../02_programs/01_host/03_camera/web/app.js)。

电脑浏览器入口：有线访问[192.168.100.123:8080](http://192.168.100.123:8080)；连接同一局域网时可用Wi-Fi地址[192.168.3.59:8080](http://192.168.3.59:8080)。有线和Wi-Fi均已取得短时连续新帧、完成拍照下载及删除核对；长时间Wi-Fi图传待验，地址随实际网络核对。

| 验证范围 | 实际结果 |
| --- | --- |
| 1280×720图流与拍照接口 | 连续图流帧号417→418；第一次拍照返回419，请求时为418；第二次返回420，请求时为419，均为接单后收到的新帧 |
| 照片下载与删除接口 | 图像字节数、SHA-256文件指纹一致，下载响应包含附件标记；删除后再次读取返回404 |
| 浏览器实际操作 | 已看到现场画面，点击拍照得到 `50034731-000003`，打开大图成功，图像宽1280像素；该照片随后随服务重启清除，未长期保存到电脑 |
| 更高分辨率工具测试 | 1920×1080和3840×2160各采集30帧通过；不是长期稳定性验收 |
| 正式参数接口 | 依次应用1080p／预览目标15帧/秒／JPEG质量90，4K／10帧/秒／92，4K／10帧/秒／90，均成功；读取JPEG内部图像尺寸，分别为1920×1080和3840×2160 |
| 切换与错误处理 | 参数切换期间原有照片仍可读取；非法分辨率返回400。接口测试照片已删除 |
| 前次部署的配置与网页范围 | 当时为4K／预览目标10帧/秒／JPEG压缩质量90，浏览器读取到3840×2160图像并应用过5帧/秒；该结果仅为当时短时测试。后续按用户要求降为720p，并完成下文的曝光、白平衡和画面质量检查 |

当前分辨率可选720p、1080p，默认720p；预览目标帧率可选5、10、15、30帧/秒，JPEG压缩质量范围50～98。前次提供的4K选项已撤下。选项由板端参数接口返回，不把JPEG压缩质量当成镜头对焦或光学清晰度。网页显示的采集帧号来自状态查询，不代表浏览器当前正在显示的那一帧。

照片只暂存在RK内存，最多12张、合计32MiB，30分钟到期或服务重启后清空；图像参数切换仅重建采集链，保留本服务会话内已有照片。新旧照片分别使用各自记录的尺寸与参数版本。用户主动下载才长期保存到电脑，本轮未新增正式识别样本集；到期清理边界和长时内存表现仍需验证。

以下命令在板B终端执行。启动：

```bash
sudo systemctl start opto-camera.service
```

停止：

```bash
sudo systemctl stop opto-camera.service
```

查询服务状态：

```bash
systemctl status opto-camera.service --no-pager
```

查询最近日志：

```bash
journalctl -u opto-camera.service -n 50 --no-pager
```

需要重启服务时执行下列命令，注意会清空当前临时照片：

```bash
sudo systemctl restart opto-camera.service
```

## 验证范围与下一步

### 网页参数接口核查（只读）

2026-11-03前期为确定曝光等参数的控制入口，按板B序列号核对身份后，只读取下列控制项，未在这次只读查询中修改参数或启停图像处理服务。该查询与上面的分辨率参数接口实测分别记录。

| 实际读取对象 | 返回结果及含义 |
| --- | --- |
| `/dev/video-camera0` | 仅列出只读的 `pixel_rate`，即像素处理速率；不是曝光或清晰度调节入口 |
| `/dev/v4l-subdev5`，名称 `m00_b_imx415 4-001a` | 列出 `exposure` 范围4～2242、`analogue_gain` 范围0～240，以及水平和垂直翻转；范围随当前传感器模式记录，曝光原始单位未核实，未换算成毫秒 |
| 对焦 | 本次传感器控制列表没有对焦控制项；镜头机构尚未核实，不能据此承诺网页自动对焦 |
| 图像处理组件 | 已有 `rkaiq_3A_server`、`librkaiq.so` 和 `/usr/include/rkaiq` 头文件；白平衡、锐化、降噪和自动/手动曝光的实际控制通道仍待适配 |

本次使用的控制项查询命令：

```bash
v4l2-ctl -d /dev/video-camera0 --list-ctrls-menus
```

```bash
v4l2-ctl -d /dev/v4l-subdev5 --list-ctrls-menus
```

这些结果只证明当前驱动暴露了相关控制项，未验证写入后的实际画面效果。自动曝光运行时可能覆盖手动设置，需通过同一图像调节引擎协调模式及参数，不能直接并行启动第二套引擎。网页方案与接口统一见[系统规划](../02_design/03_系统规划.md#camera-capture)。

前次核查发现，图像自动调节服务的本地通信入口不存在，旧进程PID 456虽仍保有监听，客户端无法通过原路径连接。当时拟重启该服务的操作被自动审批以 `blocked by policy` 拒绝，该次操作未执行。用户随后恢复本任务后，已重新启动既有图像处理服务并恢复通信入口；下节记录继续适配及实际验证结果，前次拒绝不是当前阻塞状态。

### 恢复开发：降低分辨率、接通调参和画面检查

2026-11-03用户要求继续，并明确不需要过高分辨率。恢复既有图像处理服务后，4K未持续出帧；1080p虽能拍照和执行画面检查，随后出现超过10秒没有新帧、相机网页服务自动重启的情况，因此不能延用前次短测结果声称高分辨率稳定。当前降为**720p／预览目标10帧/秒／JPEG质量85**，已写入 `/var/lib/opto-camera/camera.ini`；程序在保存配置无效时也默认使用这一组参数。

本次仅操作相机网页与既有图像处理服务，没有重启RK整板，没有停止SN100界面或TCP 5000端口的原控制程序。图像处理服务恢复后的进程为PID 139148，正式网页服务本次启动为PID 171958；进程号只用于对应本轮证据，下次按实际状态查询。

#### 调参通信方式与超时修正

使用已有 `rkaiq_3A_server` 的本地通信入口 `/tmp/UNIX.domain0`，不创建第二个图像处理引擎。板端软件包为 `camera-engine-rkaiq 6.9.0`，实际读取线性曝光、增益和白平衡的JSON字段后适配；曝光时间从该接口的秒换算为毫秒，不把前面传感器原始控制值直接当成毫秒。

最初查询期限为1～2秒、每次查询重新连接，连续操作曾超时。核对与板端实际回复一致的[C通信接收实现](https://github.com/JeffyCN/mirrors/blob/rkaiq-2025_08_11/rkaiq/ipc/message_receiver.c)及[C连接处理实现](https://github.com/JeffyCN/mirrors/blob/rkaiq-2025_08_11/rkaiq/ipc/socket_client.c)后，确认该实现写入也返回确认包，接收新连接前可能盲等3秒；旧C++实现的“写入不回复”推断不适用于本板。独立进程5秒期限的两次真实只读查询分别约1.26秒和3.00秒成功，支持这一排查方向。

正式C客户端改为串行复用同一连接，读取完整确认包；默认每次通信期限5秒，错误后关闭连接，不自动重发写入。成功提交后再读回配置与实际曝光，核对通过才返回成功。同进程连续读取四组参数，首轮约930毫秒、第二轮约3.95毫秒；把自动模式下的手动曝光预设10毫秒改为11毫秒后读回一致，再恢复10毫秒，也已实测通过。

源码：[本地通信客户端](../../02_programs/01_host/03_camera/rkaiq_client.c)、[曝光与白平衡适配](../../02_programs/01_host/03_camera/image_controls.c)、[只读诊断程序](../../02_programs/01_host/03_camera/diagnostics/image_controls_probe.c)。网页服务需访问同一 `/tmp` 通信入口，系统服务配置改为 `PrivateTmp=false`，并按顺序在既有图像处理服务之后启动。修改前后服务配置、当前720p设置及文件指纹见[参数与服务备份](../../07_backups/02_相机参数/sources.json)。未修改图像处理服务本身的启动脚本。

#### 真实板端与浏览器结果

| 验证项 | 实际结果 |
| --- | --- |
| 手动曝光与增益第一组 | 设置5毫秒、16倍，实际读回5.00741毫秒、15.8489倍；对应720p照片平均亮度7.7242 |
| 手动曝光与增益第二组 | 设置20毫秒、64倍，实际读回20毫秒、63.0957倍；对应720p照片平均亮度26.5198。两张照片亮度随设置改变，不能据此推断全部光照条件均已标定 |
| 白平衡 | 设置手动红/绿1/绿2/蓝增益1.5/1/1/2，模式与四路增益读回一致；随后恢复自动白平衡 |
| 网页调参 | 浏览器实际选择手动曝光、点击“应用曝光”，显示20毫秒和63.0957倍及读回成功提示；也实际选择手动白平衡并点击“应用白平衡”，收到读回成功提示。期间预览仍运行，测试结束恢复自动曝光与自动白平衡；色彩观感按现场照明继续调整 |
| 输入校验 | 非数字曝光、超范围曝光、非法白平衡增益、未知字段共4类请求均返回400，不当作成功 |
| 网页拍照与画面检查 | 浏览器取得 `dbfd5d76-000004`（帧1894），点击“检查画面”后显示该照片的平均亮度62.83、标准差50.66、过暗7.53%、过亮2.91%、相对清晰度395.35，耗时约34毫秒；预览帧继续增加 |
| 720p连续状态监测 | 约300.697秒、每5秒检查一次，共61次均有新帧；帧号1545→4551，服务运行时间155→456秒，无回落，期间穿插网页拍照、画面检查、手动曝光及恢复。这是5分钟有线状态监测，不是显示帧率、端到端延迟或10/30分钟图传验收 |
| 编译及依赖 | 正式C程序在板B用GCC及 `-Wall -Wextra -Wpedantic` 编译，无编译警告；新增 `libjson-glib-dev 1.8.0` 及配套包，未升级系统包。系统服务核对时提示原系统其他服务的权限/生命周期设置，未改那些服务 |

曝光与白平衡暂不保存为开机预设，仅在既有图像处理服务本次运行期间有效；网页已说明设备重启后重新设置。分辨率、预览目标帧率和JPEG压缩质量会保存。实际值可能因传感器步进与请求值略有差异；页面同时展示请求预设和实际读数。自动模式刚恢复时读数可能仍在收敛，不能把一次即时读数当成已经稳定。

#### 照片画面检查的范围

[C画面统计程序](../../02_programs/01_host/03_camera/image_quality.c)对指定照片独立解码为灰度，统计平均亮度、亮度标准差、256档亮度直方图、灰度≤16和≥245的像素比例，以拉普拉斯方差给出相对清晰度。结果带同一照片号、帧号和尺寸；换照片或删除后清除旧结果，不覆盖原图。一次仅执行一个检查，最多等待5秒，计算与通信均不占用采集图像锁。

实际板端已对1080p和720p照片运行，逐像素直方图总数与尺寸一致；720p两组曝光的检查约31.37和45.21毫秒。另用C在内存生成全黑、全白、灰色和棋盘格JPEG进行18项已知输入核对，并验证拒绝非法JPEG；这些是算法检查，不是实际镜头、标定或棋子识别精度验收。相对清晰度仅用于同场景、同分辨率比较，不提供自动对焦；镜头是否需要手动调整仍按实物判断。

2026-11-06整理时，将此前暂存的[720p五分钟监测原始数据](../../05_data/01_raw/04_hardware/20261103_camera_720p_monitor_01.json)和[18项已知输入检查原始日志](../../05_data/01_raw/04_hardware/20261103_camera_quality_check_01.log)原样归档；来源清单保留文件指纹。此次只整理已有输出，没有重新采图或运行算法，也没有扩大上表的验证范围。

网页新增 `GET/POST /api/image-controls` 和 `POST /api/captures/<照片号>/quality`。只读参数接口会在控制通道不可用时明确返回原因；参数切换中不允许同时修改曝光。照片检查失败、参数写入失败或读回不符均返回错误，不显示为已生效。全部普通测试照片按用户要求清理，不建立正式样本集；原接线照片、商家图片和手册仍保留。

### 常驻停帧与自动恢复（2026-11-04） {#camera-stall-20261104}

**本节的板端事实来自既有“接管RK3576并推进SN100移植”总控窗口（聊天ID `01a1a05a-73c4-7380-b761-c35a7fdbf76e`）的只读采集，本相机窗口没有在该时段另发SSH、HTTP、参数设置或资源测试。** 已从总控提供的电脑既存文件归档[原始查询与日志](../../05_data/01_raw/04_hardware/20261104_camera_service_restart_01.log)，2173字节，与源文件的完整文件指纹一致；来源、原路径、指纹和适用边界见[来源清单](../../05_data/01_raw/04_hardware/sources.json)。该日志采集时间为11-04 10:34:03（北京时间），没有改写原文或将其当成本窗口重新采板的结果。

| 总控已核查的项目 | 回报结果 |
| --- | --- |
| 退出原因 | 11-04 10:30:52出现“相机超过10秒没有新帧，服务将重新启动”，随后以错误码退出 |
| 自动恢复 | 日志直接列出 `Restart=on-failure`；新进程PID 2510511的启动时间为10:30:56，`/proc`进程启动时刻标识为6498209。3秒重启等待值来自总控说明和此前部署的服务配置，此份查询未直接列出 `RestartSec` 或完整服务配置正文 |
| 文件与累计次数 | 日志中的执行文件完整指纹与11-03部署清单一致；当时 `NRestarts=31` 为服务累计重启计数，不能将31次全部归为本次同一原因 |
| 新进程启动配置 | 10:30:58启动公告为1280×720、采集配置30帧/秒、预览目标10帧/秒、JPEG质量85；这是启动配置，不是持续帧率测量 |
| 其他程序（总控交接说明） | 总控另行确认原控制程序、SN100界面、图像处理进程139148及其配置仍保持，换版在发送关闭请求前停止。此份相机日志没有独立列出那些进程，不能把交接说明混作该日志已直接证明的内容 |

10:30:45的连接关闭早于停帧退出，但没有证据确定二者因果。新进程启动时的VP8插件提示发生在旧进程退出之后，也不能拿来解释旧进程停帧。查询中的 `Result=success`、`active/running` 是新进程状态，不能覆盖旧进程在10:30:53明确记录的 `exit-code` 结果。

本地对照 [C采集程序](../../02_programs/01_host/03_camera/camera_web.c)确认，10秒检查使用单调时钟，比较的是**最后成功发布的自有JPEG图像时间**。它不能区分“相机没有交付原始图像”“帧率调整或编码没有输出”“已经取到样本但映射/校验/内存分配失败”“发布时等待共享锁”。因此退出机制已经确认，传感器、驱动、图像处理及程序内部等待的具体原因均未确定；不能只凭这条日志断定相机断连。

源码复核还确认：采集线程取得JPEG后复制到自有内存并释放原始样本，慢网页保留的是该副本，网络发送不持有采集共享锁，不能用“网页慢读直接扣住相机缓冲”解释此次事件。正常参数切换在主线程同步执行，这段期间不运行10秒检查，成功重建又必须收到新一代图像；正常重建空档本身也不能直接解释这条退出日志。

程序存在一处具体等待风险：拍照函数在持有采集共享锁时计算文件指纹、生成回复并写出日志。如果日志输出阻塞，图像发布可能一起等待；但目前没有当时拍照请求、日志背压或锁等待时长证据，**这是一条待核查路径，不是已确定的根因**。另有样本映射失败后静默跳过的路径，当前日志不足以统计其发生频率。

已准备独立候选，将拍照日志移到共享锁外，并把超时文字改为“超过10秒未发布有效图像，服务将重新启动”；这两项分别减少一个明确的锁内等待点、准确说明检查含义，不能单独宣称解决本次停帧。候选仅在电脑 `temp/camera-stall-20261104/` 中生成源码副本、`candidate.patch` 和文件指纹清单 `candidate.json`，正式源文件和板端不变。电脑执行 `git apply --check` 返回0，只说明补丁可以应用；没有进行C编译、部署或实际运行验收。

服务查询与日志原件已经归档。后续用户选择恢复相机深化并完成同板协调后，再补同一时间段内核日志，核对届时实际相机参数、进程启动标识和累计重启次数，再判断是否需要部署诊断版本。如果需要，诊断只保留各阶段的帧计数、最后到达时间、图像时间戳，以及拉取为空、映射失败、JPEG拒绝、内存失败和发布锁等待统计；异常时汇总，不逐帧打印，不保存测试照片。取帧阶段信息应独立于发布共享锁，以免诊断日志也被同一把锁挡住。

[GStreamer帧率处理说明](https://gstreamer.freedesktop.org/documentation/videorate/index.html)提供输入、输出及丢帧计数，可以辅助区分帧率处理前后是否仍在前进；[取样组件说明](https://gstreamer.freedesktop.org/documentation/app/appsink.html)用于核对样本交付及缓存行为。源码判断与这些文档只用于设计取证点，不替代真实板端阶段数据。

用户以后选择恢复相机深化时，可使用的续做提示词（当前暂不执行）：

> 继续板B相机常驻停帧排查。先读开发计划和本记录“常驻停帧与自动恢复”，确认移植总控已释放本轮板端窗口。用序列号和专用SSH指纹核对板B，取得实际进程、启动标识、执行文件与配置指纹，再读取当次相机服务和内核日志；保留其原字节与来源。先定位10秒没有发布有效JPEG发生在哪个阶段，再决定是否应用本地候选或补充诊断。保持现用720p方案，曝光等参数以现场读回为准；不为匹配旧进程号而重启，也不关闭原控制程序、SN100界面或另开图像处理引擎。需要更换相机版本时先与总控协调，只替换相机自身并记录新身份。验证范围按本地检查、板端编译、真实运行逐项说明，普通照片仍不保留。

### 当前验证结论

当前已证明正式驱动、C采集、HTTP图流和拍照接口可运行；720p浏览器预览、拍照、画面检查、曝光应用，以及板端白平衡接口均已通过上述实测。锐化、降噪、翻转、参数预设、棋子识别、透视校正和位置测量尚未完成，不能据此认定整套相机工作台已经验收。

两次启动采集时仍出现以下日志，后续连续采集时继续检查其是否影响图像和稳定性：

```text
MIPI_CSI2 ERR2:0xf0000
Warning: vblank need >= 1000us if isp work in online, cur 859 us
```

后续选择恢复相机深化时，再在720p设置下补10分钟及30分钟联调、Wi-Fi持续图传和断网恢复，再接入真实棋子的检测识别、透视校正和位置测量。端到端延迟和RK重启后的实际恢复也尚待验收；开机启动已配置不等于已完成重启恢复测试。支架打印、正式装车视野与振动另行验证。

## 前次收尾与交接（保留历史）

2026-11-03用户要求本窗口收尾并记录，下次继续。已把同板状态交给既有“接管RK3576并推进SN100移植”窗口（聊天ID `01a1a05a-73c4-7380-b761-c35a7fdbf76e`），程序移植及板端验证由该窗口按其用户最新要求统筹；本交接不覆盖其暂停或收尾指令。

当时本窗口停止继续变更板端环境，保留相机网页服务运行。地址为有线 `http://192.168.100.123:8080/`、同局域网Wi-Fi `http://192.168.3.59:8080/`。当时保存的是4K／预览目标10帧/秒／JPEG压缩质量90，服务重启后验证恢复，未重启整板。用户后来恢复本任务，当前已改720p，具体结果以上文“恢复开发”为准。

最后一轮4K核对：有线图流帧2412→2413，照片2414和2415均为接单后收到的新帧；Wi-Fi图流2417→2419，照片2424和2431均为新帧。原图、下载及元数据的文件指纹一致，删除后原图和下载均返回404，测试照片未保存在电脑或正式样本目录。浏览器已实际读取4K图像并应用过5帧/秒设置，结束前恢复10帧/秒。

前次告知移植窗口：相机网页是8080端口的普通优先级背景服务，需计入同板资源条件；该次未停止SN450业务、未改实时内核、未重启3A服务。当时图像自动调节服务的通信路径缺失，修复重启动作被自动审批拒绝。后续恢复任务已解决这一入口问题，不再以此作为待解决事项。

后续选择相机深化时的入口：先读取本记录和开发计划，核对720p网页、曝光与白平衡读回及照片画面检查；随后做更长时间联调和实际棋子分析。持续显示帧率、显示延迟、10／30分钟稳定性、断网恢复和装车验收仍保留未完成，不因本轮结束而勾选通过。

## 固定热点与相机换接口（2026-11-05） {#wireless-camera-20261105}

用户要求小车移动时不拖网线，电脑仍能打开原网站查看实时摄像头画面，并比较蓝牙连接。本次沿用板B，先严格核SSH指纹与序列号 `8314b1e8ffd0321f`，再配置无线连接、扫描相机所在接口并恢复既有服务。

### 电脑如何开启固定热点

本次已配置的名称为 `opto-robot-b`，密码沿用电脑原有热点密码，没有输出或归档密码；使用2.4GHz，关闭无客户端时自动关闭热点。以后在Windows中按以下顺序操作：

1. 打开“设置 → 网络和Internet → 移动热点”。
2. “共享我的Internet连接来源”选择电脑当前已联网的Wi-Fi；“共享方式”选择Wi-Fi。
3. 在“属性 → 编辑”里查看或修改网络名称、密码、频段，保存后打开移动热点。名称和密码会保留，不需要每次重建。修改密码后须同步更新板B的连接配置。
4. 调试期间保持电脑开机、唤醒；热点打开后，板B使用已保存的 `board_b_hotspot` 自动连接。在已连接设备列表里查看它本次取得的地址。

这是Windows自带的移动热点功能，设置入口与可保存字段见[微软说明](https://support.microsoft.com/en-us/windows/experience/connectivity-networking/use-your-windows-device-as-a-mobile-hotspot)。本次用Windows公开接口完成配置；原名称、频段和自动关闭状态见[原设置](../../07_backups/03_无线调试/01_电脑热点原设置.json)，本次配置、回退方式和地址限制见[配置与恢复](../../07_backups/03_无线调试/02_配置与恢复.json)。

板B新增连接 `board_b_hotspot`，自动连接开启、优先级20，原有无线配置保留。本次地址为 `192.168.137.16/24`；通过该地址的SSH再次核对身份成功，随后重启也自动回连。本次地址由热点分配，未设置固定IP，后续以已连接设备列表为准。

### 三个相机接口的实际扫描

用户确认排线接着，但换过主板接口，并要求把三个接口都扫描一次。复用[原C诊断源码](../../02_programs/01_host/03_camera/diagnostics/camera_addr_probe.c)，在板B用GCC和匹配的 `6.1.99-rt36-tspi` 头文件原生编译。逐一在I²C4、5、6加载诊断模块，使用当前设备树已有的复位和37.125MHz时钟，只读检查寄存器 `0x311a`；每组结束恢复原复位电平、关闭临时时钟并卸载模块。

| 相机通道 | 实际结果 |
| --- | --- |
| I²C4，原先出图的通道 | 0x10、0x1a、0x36、0x37均未响应，匹配数0 |
| I²C5 | 同四个候选地址均未响应，匹配数0 |
| I²C6，当前第三组通道 | 0x1a返回0xe0，符合既有驱动判据，匹配数1；其余候选未响应 |

诊断结束时三组均报告资源恢复成功，临时模块已卸载。完整[编译输出](../../05_data/01_raw/04_hardware/20261105_camera_port_scan_build_01.log)与[逐地址读取、恢复和卸载结果](../../05_data/01_raw/04_hardware/20261105_camera_port_scan_01.log)分别保存；编译通过和真实识别分开判断。

原相机地址修正只覆盖I²C4，本次新增[I²C6插件源码](../../02_programs/01_host/03_camera/config/lckfb-imx415-i2c6-1a.dts)。实际合并设备树仅改变两项：I²C6的IMX415地址0x37→0x1a，以及同口备用GC05A2状态okay→disabled；原I²C4、CAN和UART插件保留。板端现有dtc是x86-64程序，不能在ARM64运行；本次从已有源码用GCC生成临时ARM64工具，再编译、反编译核对并合并检查，见[构建输出](../../05_data/01_raw/04_hardware/20261105_camera_i2c6_overlay_build_01.log)和[合并差异、启用结果](../../05_data/01_raw/04_hardware/20261105_camera_i2c6_overlay_deploy_01.log)。

实际启用命令为：

```bash
ovtree enable lckfb-imx415-i2c6-1a.dtbo
```

仅备份受影响的 `overlays.ini`、`.ubootenv` 和新增插件；修改前后原件、文件指纹与恢复范围追加在[原相机配置备份](../../07_backups/01_相机地址/sources.json)的2026-11-05条目，没有备份整个系统。随后重启板B，启动号变为 `3390445d-ac19-46d6-b23e-be67535cfc4d`，自动连回热点；正式驱动显示 `imx415 6-001a: Detected imx415 id 0000e0`，`/dev/video-camera0`实际指向 `/dev/video51`。相机服务PID1835、active/running，见[重启后原始结果](../../05_data/01_raw/04_hardware/20261105_camera_i2c6_after_reboot_01.log)。

### 仅无线访问及后段掉线

在板B有线网口已经DOWN、没有有线地址的条件下，电脑通过热点地址取得：

- 网页 `http://192.168.137.16:8080/` 返回HTTP200，HTML为14434字节。
- 两次状态读取均为ready、fresh=true，1280×720，预览目标10帧/秒，JPEG质量85。
- 间隔约2秒，帧号962→982，图像年龄29→99毫秒；服务运行约97→99秒，NRestarts=0。

这证明当时仅靠Wi-Fi已能访问原网页，且相机采集在更新；预览目标帧率和状态帧号不等于浏览器已显示的画面。证据见[仅无线网络状态](../../05_data/01_raw/04_hardware/20261105_camera_wifi_only_network_01.log)、[第一次状态](../../05_data/01_raw/04_hardware/20261105_camera_wifi_status_01.json)、[第二次状态](../../05_data/01_raw/04_hardware/20261105_camera_wifi_status_02.json)。

浏览器自动核对被电脑操作工具停止，原因为工具无法可靠确认当前浏览器网址，未取得新的浏览器目视证据。随后直接采样图流时，虽然收到multipart图流响应头，但实际图像字节为0；后续SSH与ping超时，电脑热点仍On、客户端数为0。此[未完成的图流采样](../../05_data/01_raw/04_hardware/20261105_camera_wifi_stream_incomplete_01.json)保留真实零字节结果，不写成视频预览通过。经询问，用户确认“刚拔过电源或已经关机”，后段按断电离线记录，不新增无线故障结论；下次上电再核实际图流与浏览器画面。本次没有保存新的相机照片。

### Wi-Fi与蓝牙的取舍

本次选择Wi-Fi热点承载现有SSH、上传程序、网页和图流，主要因为可直接沿用这些现成接口。Windows也支持蓝牙个人局域网，但须双方支持并配置这一网络功能；仅蓝牙配对或建立蓝牙串口，并不会自动得到可打开原网页的网络。微软说明Wi-Fi通常比蓝牙共享更快，相关依据见[移动热点](https://support.microsoft.com/en-us/windows/experience/connectivity-networking/use-your-windows-device-as-a-mobile-hotspot)、[蓝牙个人局域网](https://support.microsoft.com/en-us/windows/hardware/bluetooth/connect-to-a-bluetooth-network-in-windows)和[Linux网络管理器蓝牙配置](https://networkmanager.pages.freedesktop.org/NetworkManager/NetworkManager/nmcli-examples.html)。

板B已能列出蓝牙控制器，但本次没有配对、配置蓝牙组网或测吞吐，不能声称蓝牙图传通过。当前先恢复并复测Wi-Fi实时画面，运动前另落实通信超时停车和现场停机方式；更长时间图传与移动范围验证仍保留未完成。

### 再次上电后的完整图流核对

用户随后报告“现在已经上电了”。电脑热点客户端恢复为1，板B再次自动取得 `192.168.137.16`；严格核身份后，启动号为 `67474b47-3dc4-44dd-aa75-87f4d327b570`，有线网口DOWN、只有Wi-Fi在线，相机服务PID1936、active/running、NRestarts=0，采集入口仍为 `/dev/video51`，见[重新上电结果](../../05_data/01_raw/04_hardware/20261105_camera_wifi_power_on_01.log)。

最初电脑图流接收较慢：板内4秒取得1914960字节，电脑5秒取得179518字节；当时板B报告热点信号-86dBm。用户确认同一桌面、天线已接好，后续读取信号变为-44dBm；不推定期间调整了哪一项硬件，也不凭一次读数判断天线损坏。

北京时间19:08直接读取原 `/stream.mjpg`，收到160430字节，包含三帧完整JPEG的起止标记，HTTP分段头内帧号依次为2589、2590、2591。图像只在内存核对，没有另存照片；这是实际图流到达电脑的证据，见[连续三帧核对结果](../../05_data/01_raw/04_hardware/20261105_camera_wifi_stream_success_01.json)。结束后状态为ready、fresh=true，帧号2595，图像年龄72毫秒，服务运行260秒，1280×720、预览目标10帧/秒、JPEG质量85，见[最终状态](../../05_data/01_raw/04_hardware/20261105_camera_wifi_status_final_01.json)。

当前无线网页入口为 [相机工作台](http://192.168.137.16:8080/)。本次已核对只有Wi-Fi连接时的自动回连、原网页响应与实际连续图流；浏览器内的现场画面仍由用户打开链接目视确认，长时间稳定性、显示延迟和移动范围按后续任务验证。中途断电时的零字节结果继续保留，和本次成功分开登记。
