qyq11/opto-chess-robot-2027/01_docs/02_design/01_整机方案.md

---
slug: /design/system
sidebar_position: 1
---

# 整机方案

更新日期：2026-10-30。本文是当前整机方案的唯一入口；任务状态见[开发计划](../01_plans/01_开发计划.md)，本轮买什么见[购买清单](../../03_hardware/01_硬件清单.md)。用户已确定本车采用**立创泰山派3M RK3576，4GB RAM＋64GB eMMC**，准确型号为 **LCKFB-TSPI3M-RK3576-4G-64G（C54110287）**。主控及原配散热套件已购买、已付款，到货待确认。已完成电脑算法示例与静态机械设计；2026-10-30用户报告四轮与电机已装好、驱动尚未接线。该报告不代表供电、运动或整车验收通过。

后续搭建见[整套系统规划](./03_系统规划.md)，包含信号/供电图、RK直连驱动、传感器分工和接口核对；首次操作见[底盘串口接线与首轮测试](./05_底盘串口接线与测试.md)。主控工作负载、4GB资源预算和验证条件见[RK3576主控方案](./02_RK主控评估.md)。

## 1. 已确定的主线

**碳纤维底板 + 四轮麦克纳姆底盘 + 泰山派3M RK3576 4+64 + 相机直连RK + RK经40针硬件串口直连亚博四路驱动。** 2026-10-30按用户决定，本轮不加STM32。 本轮只实施这一套系统；完整购买清单统一维护，选型确定与已下单、实测通过分别登记。

| 层次 | 当前确定内容 | 仍需核对的参数 |
| --- | --- | --- |
| 底盘 | 已购T5X四驱碳板先以1片作主底板试装，单车4个65mm尼龙麦轮、2左＋2右、四轮独立驱动 | 主选亚博3mm六角联轴器＋MD310Z20_7.4V＋原配支架；T5X实物孔位及承力待核，允许必要补孔/转接；当前65mm模型已重建，实物安装、净重和2S电源待验收 |
| 计算 | 泰山派3M RK3576，4GB RAM/64GB eMMC完整成品板；官方外形85×57mm | 到货硬件版本、5V/4A起的供电及外设余量、散热、排针焊接；安装孔、厚度与净重未知 |
| 视觉 | 已购IMX415 800万像素、30针MIPI、100度M12镜头，计划直接接RK | 已付款、待发货；固定孔、支架、排线、接口针脚、供电与镜像驱动适配待核，尚未板端出图 |
| 控制 | RK经40针硬件串口直接发四轮速度；驱动板采编码器并执行轮速PID | RK负责四轮速度换算、限速和反馈管理；针号、电平、Linux节点、失联停车待实测 |
| 车体运动感知 | 用户已定新增1个JY901S九轴IMU，优先I²C接RK，串口备用 | 未购未接；电平、已有上拉、固定、时间对应和磁干扰待核 |
| 安装 | 板卡固定后通过配套线束连接；前端带可拆卸推板 | 绝缘支柱、转接安装片、长槽手动调高、接头和走线 |
| 渠道 | 零部件只选淘宝或京东，优先淘宝；主控使用立创官方入口 | 商品具体分类、报价、交期与售后；未知选项不编造 |

当前清单按一辆车列4个轮子，备件另列，不把早期约16个轮子的设想自动加入本次订单。

## 2. 系统如何连接

当前整机框架

[可编辑框架图](../../05_data/03_results/01_design/02_系统信号连接.drawio) · [整车供电图](../../05_data/03_results/01_design/03_系统供电.png) · [逐线接线表](./03_系统规划.md#61-电池降压板驱动到底怎么接)

2026-10-30更新连接图：相机→RK↔四路驱动↔四台310，编码器直接接驱动。撤下额外STM32及其专用控制稳压支路；动力与计算支路并联，动力直接供驱动，RK经独立5V稳压和5A短C-C线供电。电源板选基础款，不加T插线；线材、正负极及含件见接线表。

相机不影响首轮底盘测试。2026-10-30已购IMX415 30针MIPI模组，选项原文「30P-IMX415配无畸变100度镜头M12」，[订单与图纸差异](../../03_hardware/01_硬件清单.md#已购相机与商家图纸)集中维护。MIPI是相机排线接口，针数相同不代表兼容；逐针核对模组和泰山派3M的信号、供电、排线触点方向，以及当前镜像中的驱动支持后，再连接通电。2026-11-03已完成[相机打印支架](./08_相机支架与打印.md)电脑设计：上层四原孔固定、双侧俯仰与沉头锁紧，当前20°为示例。真实孔位、线缆、清晰度、视场、振动和机位仍待核。此前USB UVC方案与官方USB采集教程只保留为开发参考，不作为已购模组的接法或适配结果；商家文件名标120度的图纸也不能直接当100度版本规格。

若后续评估双目，选择有同步、Linux支持和标定资料的成套模组。两只普通相机不自动具备同步双目能力；双目也不等于必须采用SLAM。相机能力以板卡实际接口、所用Linux镜像和实拍结果为准。

RK使用40针排针上的硬件串口，按厂家115200、8N1、无硬件流控直接控制驱动；接线为TX→RX2、RX←TX2、GND相连。具体物理针位、电平与Linux设备节点确认后再接信号线。线上沿用厂家协议，不再设计RK与STM32之间的协议；序号、目标有效期和反馈接收时间由RK本地管理，不能假定驱动支持自定义校验或心跳超时。正式接线、命令及验收边界以[底盘串口接线与首轮测试](./05_底盘串口接线与测试.md)为准。

电池经配电分别供给电机驱动与计算/相机稳压支路；泰山派3M[规格书](../../04_references/04_datasheets/01_泰山派3M_RK3576_规格书.pdf)第3页标注Power Type-C为5V-4A输入，[快速指南](https://wiki.lckfb.com/zh-hans/tspi-3-rk3576/system-usage/)另写适配器峰值≥3A。采购按5V/4A起，并结合相机与5V风扇另核余量，不能将3A当作满载额定；车载稳压方案需覆盖电池满充至截止范围。RK与驱动板使用绝缘支柱固定，不能让板底焊点接触导电碳纤维。优先购买已焊排针的完整开发板、驱动模块和配套线束，以实现固定后接线的装配方式。

2026-11-02按用户要求把车头改为**可3D打印的V形推铲＋左右调高支架**，靠整车运动推棋子，不接电控信号。V角90°、入口净宽56mm，斜面导中，短挡边限制横移，前方敞开供退车释放；前铲130×44×30mm、名义离地2mm，支架有加强筋和双长孔。官方棋子规格尚未公布，30/40/50mm圆片只用于电脑几何检查，当前为PETG试制设计。完整尺寸、三个STL、紧固与打印方法见[前推铲与打印](./07_前推铲与打印.md)。当前整车模型247×195.8×161.6mm，未打印、未验受力和真实推送；未来需要电动夹持时再评估执行器。

## 3. 算法与任务分工

本赛题是小车自主识别、争夺并推送棋子入门，当前没有象棋走棋引擎的需求。RK负责图像、定位、目标选择、任务状态机、整车到四轮的速度换算、限速和反馈管理；四轮编码器计数与轮速PID由驱动板完成。运动通信与视觉独立运行，避免识别阻塞停车；RK卡死或串口断线后的独立停车能力须另行验证，不能由同机软件看门狗代替。

建议先形成“观察 → 确认识别 → 接近/对准 → 推送 → 越线复核 → 失败退出”的闭环。目标选择可结合分值、成功概率和完整任务耗时；视觉不确定时允许重新观察或换目标。路径需考虑整车、被推棋子、围挡与对手的占据区域，最终计分以裁判判定为准。

2026-10-30用户确定后续做二维场地地图：持续估计车的位置和方向，发现棋子后编号标记，规划接近/推送路线，观察确认进入目标区后再处理下一枚。先评估相机、编码器与新增IMU的组合，实施排在底盘与相机基础验证之后；三维重建和额外测距设备暂不实施。已知尺寸场地可以先建立静态平面地图并做定位，是否引入边走边建图的SLAM由实测收益决定；照片数量增加不能代替标定、固定参照和误差验证。详细缺口、传感器取舍与验收见[二维定位与场地地图评估](./03_系统规划.md#二维定位与场地地图评估)，任务统一见[总计划](../01_plans/01_开发计划.md#二维定位场地地图与连续推棋)。

透视变换只适用于选定平面。地面和棋子顶面有高度差，不能直接共用同一地面映射；相机需标定、去畸变，并用独立检查点验证实际误差。低机位看不清或遮挡时，可调整机位或主动改变观察姿态，不能指望单应矩阵补全不可见内容。

已有 [Python 透视变换](../03_records/01_20261023_透视变换.md)和[象棋识别](../03_records/02_20261023_象棋识别.md)保留为电脑研究基线。正式板端按 C/C++ 与 GCC 推进；神经网络转换为 RKNN 后逐项验证，几何处理、跟踪和决策仍需独立测量 CPU 开销。当前模型的 7/12 人工 ROI 正确结果不足以作为比赛部署依据。

推送几何概念示意

## 4. 培训材料如何使用，后续如何发散

[三份培训材料](../05_resources/01_资料清单.md#外部培训参考)由他人制作，保留原件供参考。可借鉴任务拆分、接口核对、分阶段演示和失败分析；其中的硬件候选、教学周期、算法顺序与指标不自动成为本项目决定，也不能当作官方规则或本车实测。

**固定系统主线，开放局部设计。** 棋子检测可比较传统几何与轻量检测网络，身份识别可比较专用分类器与 OCR；机位可比较单目、多视角和同步双目；推送导向结构、接近轨迹、观察动作和目标排序也可以提出新想法。每次围绕一个明确问题做小实验，用识别表现、完整推送成功率、耗时、质量及功耗评价，再决定是否合入。

这些是同一架构内可研究的问题，不同时建立多套整机计划。新增九轴IMU及二维定位/地图已纳入后续安排，当前不为接触力控制、滚轮成组推送或完整SLAM提前扩展采购；按前述评估先验证相机方案，再依据实际缺口更新本方案和计划。

## 5. 比赛边界与变更规则

依据[已归档赛题原件](../../04_references/01_official/01_第十五届赛题要求.pdf)：场地标示 3m×2m，每队 1 车，发车尺寸不超过 250×200×180mm、质量不超过 1.5kg，车载电池，全自主运行。整车外廓必须包含轮子、推板、相机、接头和线缆；不能只按底板尺寸选购。

原件还涉及 32 枚棋子、差异化分值及功率不超过 1mW 的 II 类激光系统。门宽、棋具规格与分值、正式时长、激光用途及后续修订须向官方核实，采购与机构设计保留相应空间，不把培训材料或设计推断补成官方结论。

后续更改时按“提出原因 → 核对受影响的采购/接口/算法 → 小实验或规格复核 → 更新方案与采购清单 → 同步计划”的顺序处理。2026-10-30用户确认RK经40针串口直连驱动，构成当前控制基线；历史会议仍保留原始决定，并标明后续变更。
