qyq11/opto-chess-robot-2027/01_docs/02_design/06_透视变换动画脚本.md

---
slug: /design/perspective-animation
sidebar_position: 6
---

# 透视变换动画脚本

> 2026-10-30归属更新：用户已将本内容确定为个人知识分享，后续制作需求、逐秒分镜、网页主版和检查记录统一维护在“自身发展”的 `05_自媒体与抖音/02_脚本与素材/05_计算机视觉知识分享/`。本页与本工程的26秒网页保留为初版研究预演，不再作为分享主计划维护。新目录的 `01_透视变换_制作需求.md` 是制作入口，`04_web/index.html` 是分享主版；机器人算法、原始输入和研究记录仍保留在本工程。

日期：2026-10-30。先核对项目源码与官方资料，再按本脚本制作画面。任务状态统一保留在[开发计划](../01_plans/01_开发计划.md)，验证结果追加到[原透视变换记录](../03_records/01_20261023_透视变换.md)。

## 要讲清什么

项目做的是“斜视平面校正为俯视平面”，用户提到的“仰视”与现有代码不符。用途是把被透视压扁的棋面拉正，方便后续识别或坐标计算；相机不需要真的移到上方。

核心算法在 `02_programs/01_host/01_perspective/perspective_demo.py` 的 `rectify` 中；棋面识别程序 `02_programs/01_host/02_xiangqi/perspective_recognition.py` 使用同一原理。`getPerspectiveTransform` 用四组对应点求一个3×3的单应矩阵H，即一张坐标换算表；`warpPerspective` 按这张表重采样原图。

四个点必须属于同一目标平面，顺序一致，不能共线或组成退化图形。一般将左上、右上、右下、左下映射到目标矩形的同名四角。H去掉整体倍数后有8个独立参数，每组对应点提供两条方程，因此四组有效对应点可确定它。

若H的最后一项归一为1，原图坐标(x,y)映射到输出坐标(u,v)的规则是：

$$
u=\frac{h_{11}x+h_{12}y+h_{13}}{h_{31}x+h_{32}y+1},\qquad
v=\frac{h_{21}x+h_{22}y+h_{23}}{h_{31}x+h_{32}y+1}.
$$

分母随位置变化，解释了为何不能用统一拉伸代替透视校正。实际生成图片时，通常对每个输出像素用H的逆变换回原图找位置，再混合周围四个像素的颜色；这叫双线性插值，可减少直接向前撒像素造成的空洞。

## 文件放在哪里

| 内容 | 位置 | 原因 |
| --- | --- | --- |
| 本脚本、原理、来源 | 当前设计文档 | 先确定讲述顺序，便于后续修改 |
| 动画的可编辑网页片段 | `02_programs/01_host/01_perspective/web/perspective-transform.html` | 与所解释的算法源码放在一起 |
| 可双击打开的独立网页 | 同目录 `index.html` | 无需安装依赖即可观看 |
| 生成独立网页的工具 | 同目录 `build_preview.py` | 从同一份片段生成，避免维护两套动画逻辑 |
| 浏览器核对截图 | `05_data/03_results/02_perspective/` | 沿用已有成果目录，不另建平行图片库 |
| 一次性检查与中间输出 | 原位于`temp/perspective-animation/` | 已在2026-11-02提交前清理，正式源码和原始输入保留 |

聊天内展示使用同一份动画片段。动画是教学示意，不新增相机实测结果；已有官方照片可作为末段对照，保留其原始来源与许可，不覆盖原图。

观看时直接双击[独立网页](../../02_programs/01_host/01_perspective/web/index.html)，点击“播放”或拖动进度条。修改[动画片段](../../02_programs/01_host/01_perspective/web/perspective-transform.html)后，在项目根目录运行下列命令重新生成独立网页；片段中的`__PROJECT_SAMPLE__`由工具填入已有照片和四点坐标，不直接打开模板观看：

```powershell
python -X utf8 -B 02_programs/01_host/01_perspective/web/build_preview.py
```

工具只用Python标准库，独立网页不依赖Python、网络或文档网站服务。`--fragment 绝对路径`可另存填好数据的聊天展示片段；当前聊天的展示副本位于本聊天专属的可视化目录。

## 分镜与操作

采用一个主要画面，提供“播放／暂停”和时间进度条。用户可以拖动到任一阶段反复查看；默认静止，点击后播放一轮，不自动循环。系统偏好减少动画时仍可用进度条逐帧查看。

| 时间 | 画面与动作 | 用户需要看懂的事 |
| --- | --- | --- |
| 0—4秒 | 斜视网格与被压扁的棋字、圆形 | 同一平面在照片中有近大远小、远处间距变小的现象 |
| 4—8秒 | 四个编号点和目标矩形的同名四角依次对应 | 四组对应点给算法提供坐标约束；四点范围是所选平面区域 |
| 8—15秒 | 四边形连续校正为矩形，内部格线与字形一起变化 | 所有位置遵循同一个H；中间形变用于教学，算法本身直接算最终结果 |
| 15—21秒 | 输出格点沿扫描顺序点亮，连线回到原图取色位置 | 实际做图按输出像素反查输入，再插值取色 |
| 21—26秒 | 显示项目现有OpenCV样图及校正图，标出四点 | 动画对应真实代码；样图四点是内角点范围，不是整张棋盘外缘 |

只在画面内显示必要的阶段、点号、原图／输出图标签和扫描位置。较长解释、公式、来源与局限保留在当前文档和聊天正文，避免遮住画面。

## 必须说清的边界

- 同一矩阵只校正指定平面。地面与高出的棋子顶面不能直接共用地面映射。
- 被遮挡或照片中没有的内容无法凭此恢复。极低机位看不清时，需要调整观察位置。
- 输出矩形的长宽比需要已知几何支持，四个任意像点本身不提供真实比例或毫米尺度。
- 本项目已有样图未去镜头畸变，校正后残余弯曲不能由本算法自动消除。
- 动画不是三维重建，也不是移动相机的物理过程。相机姿态变化后，原映射通常需要更新。

## 如何核对

1. 用独立的矩阵计算检查四点映射和中间检查点，并与项目已存H比较。
2. 确认实际执行逆向取样，至少检查目标四角和内部点的来源坐标。
3. 在浏览器点击播放／暂停、拖动时间条，检查画面随操作变化，播放一轮后停止。
4. 检查窄屏和深浅主题下的文字、点号、控件与画面，无遮挡、横向溢出或脚本错误。
5. 核对已有照片和程序未被修改。这里只验收电脑中的教学动画，不新增RK板端、项目相机或整车通过结论。

## 已查阅的资料与skill

- [OpenCV单应矩阵官方教程](https://docs.opencv.org/4.13.0/d9/dab/tutorial_homography.html)：平面映射、8个独立参数与透视校正。
- [OpenCV几何变换官方文档](https://docs.opencv.org/4.13.0/da/d54/group__imgproc__transform.html)：四点求解、逆向映射和插值取色。
- `file-search`：定位实际算法和既有研究记录。
- `visualize`：制作聊天内的动态示意、主题适配和交互控件。
- `work-habits`：沿用项目目录、同一事项一份主记录，并说明验证范围。
- 查阅了`sites`：本项目已有本地文档网站，本次动画随项目保存与展示；未要求线上发布，不另建托管网站。
