qyq11/opto-chess-robot-2027/05_data/01_raw/04_hardware/20261104_motor_query_ssh_identity_01.txt

@@@@@@@@@@@@@@@@@@@@@@@@@@@@@@@@@@@@@@@@@@@@@@@@@@@@@@@@@@@
@    WARNING: REMOTE HOST IDENTIFICATION HAS CHANGED!     @
@@@@@@@@@@@@@@@@@@@@@@@@@@@@@@@@@@@@@@@@@@@@@@@@@@@@@@@@@@@
IT IS POSSIBLE THAT SOMEONE IS DOING SOMETHING NASTY!
Someone could be eavesdropping on you right now (man-in-the-middle attack)!
It is also possible that a host key has just been changed.
The fingerprint for the ED25519 key sent by the remote host is
SHA256:xLQv5sqzTRvKbfD2fNQQLYjCbPN6WOXgkXEoUqV8Yy4.
Please contact your system administrator.
Add correct host key in C:/Users/52400/.ssh/known_hosts_rk3576_board_b to get rid of this message.
Offending ED25519 key in C:/Users/52400/.ssh/known_hosts_rk3576_board_b:1
Host key for rk3576-board-b has changed and you have requested strict checking.
Host key verification failed.
