qyq11/opto-chess-robot-2027/01_docs/01_plans/01_开发计划.md

---
slug: /
sidebar_position: 1
---

# 开发计划

更新日期：2026-11-12。

下一步工作（2026-11-06用户确定）：**先调整整车布局，把较多板卡移到下层；再制定并落实固定的接线要求；随后实现单个棋子的自主决策与推送。** 布局调整时一并考虑线束出口和固定位置，接线要求随新布局落实。具体任务见[板卡下移](#lower-board-layout)、[固定接线要求](#fixed-wiring-plan)和[单棋子自主推送](#single-piece-autonomy)。

已有基础：无线相机、网页四向控制和正常计时停车已打通，四向实际移动已由用户确认。“按距离前进”首版已准备，默认20厘米，上次检查时板B未上电，板端检查、部署和地面尺测仍待完成。该任务作为自主推送的运动基础继续保留，见[定距离任务](#distance-first-run)。

推进方式（2026-11-04用户确认）：**每一项先打通基本链路，再转下一项；各项打通后逐步深入。** 相机与串口查询阶段已分别收尾，11-05按用户要求打通网页架空慢速前后与正常计时停车。此前约5V供电时3V3约2V的问题、四轮高输出时抖动和回包异常保留原始证据，不由后来的慢速成功推定根因已查清。新的可调参数已按用户后续要求实现，分档性能验收继续保留。整机连接见[当前方案](../02_design/01_整机方案.md)。

电脑负责编辑，RK的Linux负责运行。已有的编辑、上传和板端运行流程直接复用；后续围绕上述三项推进，运动检查继续比较设定距离、轮子反馈估计距离与地面实测位移。

## 已完成

- [x] **采购：** 主要部件已付款，相机已到货；其余到货情况继续核对。见[购买清单](../../03_hardware/01_硬件清单.md)。
- [x] **代码：** 已有[透视校正示例和原理动画](../03_records/01_20261023_透视变换.md)、[局部棋子识别示例](../03_records/02_20261023_象棋识别.md)，已在电脑离线验证；尚未用车载相机验证，也未完成全图自动找棋子。
- [x] **编辑与板端运行流程：** 2026-11-03用户确认，已在已有的RK3576 Linux练习项目中完成电脑编辑、上传与RK运行，后续复用这一流程。本项不代表本车相机、运动程序或整车已经验收。
- [x] **机械设计：** 已完成整车布局和V形推铲的电脑模型与几何检查，尚未打印或实物验收。见[机械记录](../03_records/03_20261024_机械装配验证.md)。
- [x] **装配与基础调试：** 四轮、电机已装好，电脑USB查询参数和接收反馈已有结果；2026-11-03用户补充，电机基础对应关系已基本完成，后续随运动实测复核。此前M3（第3路电机）转动等证据见[底盘调试记录](../03_records/04_20261030_底盘串口调试.md)；本次补充为用户报告，不新增四轮定距离、停车保护或RK控制程序通过的结论。
- [x] **相机基础链路已打通：** 板B已能拍照，电脑能看到照片；浏览器预览和已有参数功能的实测范围见[相机记录](../03_records/05_20261103_相机采集与电脑预览.md)。用户确认本轮到此收尾，工作台已停止。停帧排查、长时稳定性和照片分析扩展保留为后续深入，未把它们记作已验收。
- [x] **RK与驱动的一次查询链路已打通（驱动接电脑USB辅助供电）：** 2026-11-04 16:49，板B经UART4发送 `$read_flash#` 12字节，收到150字节真实配置，解析固件1.7.3、类型2、13线、减速比20、轮径65mm，退出0。原始收发和解析已归档，见[同一底盘记录](../03_records/04_20261030_底盘串口调试.md#usb辅助供电后配置查询通过)。不代表电池独立供电或运动已通过。
- [x] **更换Wi-Fi后的有线串口复测：** 2026-11-05 18:37，USB网口恢复连接后，经本地IPv6严格核板B身份，再发送一次配置查询，收到150字节完整回复，原参数未变；见[复测记录](../03_records/04_20261030_底盘串口调试.md#uart-recheck-20261105)。本次未重新确认驱动供电接法和电压，不据此关闭电池供电排查。
- [x] **无线调试基础链路：** 电脑固定热点、板B自动回连、相机第三组通道恢复及仅无线下原网页与连续JPEG图流通过；19:08收到三帧完整图像，见[无线相机记录](../03_records/05_20261103_相机采集与电脑预览.md#wireless-camera-20261105)。浏览器自动目视核对、移动范围和长期稳定性另验。
- [x] **网页慢速前后控制：** 板B部署后，用户确认架空前进能缓慢转动并停车、后退四轮均反转并停车；对应真实发送、轮速回包和零速已归档。目标轮速缓升到60毫米/秒，默认2秒、可选1/2/3秒；未验收地面距离或长期带载，见[同一底盘记录](../03_records/04_20261030_底盘串口调试.md#web-motion-20261105)。
- [x] **四向实际移动：** 2026-11-05用户在讨论落地验证时确认前进、后退、左移、右移均可以，按用户现场报告登记基础移动已打通。本次没有新增动作参数、测量数据或原始收发，不据此认定距离精度、长期带载或独立失联停车通过，见[同一底盘记录的用户确认](../03_records/04_20261030_底盘串口调试.md#ground-motion-confirmation-20261105)。

### 相机网页控制前进与后退（2026-11-05）

目标：用户在已有相机网页点击按钮，RK经UART4给四路驱动发送低速前进、后退和停止命令。用户本轮确认四个电机都已接好；首次动作由用户在现场点击，并观察方向和停车。

- [x] 增加网页运动面板，显示真实收发、四轮轮速与峰值；按用户最新要求改为20→40→60毫米/秒缓升，默认2秒，可选1/2/3秒，随时可以停止。较快的直接输出测试按钮已移除，旧请求也拒绝。
- [x] 板端独立计时，到时发送零速度和零PWM；重复点击不能延长当前动作，反向前必须先停，串口错误后拒绝继续启动；停止后拒绝延迟的旧请求。
- [x] 在板B完成GCC编译，用板端虚拟串口核对前后具体字节、限时停车、重复点击、反馈解析和停止；没有在电脑运行板端程序。本项不代表实物转轮通过。
- [x] 部署到相机服务，核对真实UART4配置回复、网页HTTP200和相机新帧。用户在网页点击已产生前后与归零发送日志；助手未自动启动真实电机。
- [x] 查询得到 `$Battery:7.1V#`，用户确认无电脑USB、稳压后静止约7V，后来补充已改8.2V。高输出四轮仍只抖动，日志有乱码、计数重置和反馈中断；供电掉压或干扰是排查推断，尚无启动瞬间测量。
- [x] 第3路PWM 300没有起转；改为1800档、0.3秒后，用户确认转动并停下，驱动记录非零轮速。只证明该单轮动作与正常计时停车。
- [x] 用户确认新版慢速前进能持续转动并停止；后退四轮都反转，随后停止。真实日志有各级目标、非零反馈和停车后零速；仅验收架空基本动作，不代替地面运动。
- [x] 板端检查缓升指令、所选时间、运行中拒绝反向、延迟旧请求拒绝、反馈中断归零与正常退出；代码已原生编译并部署，相机仍正常出图。

本轮不改驱动保存参数。短时停车依赖RK及串口仍正常，不能替代驱动侧失联保护；后续定距离与落地连续运行按原计划另验。设计与结果继续更新原底盘文档和原底盘调试记录。

## 当前需要做

### 调整整车布局，把板卡移到下层 {#lower-board-layout}

目标：把较多板卡从上层移到车体下层，降低重心、整理安装空间，并让后续线束能够固定。具体哪些板卡下移，以现有实物尺寸、接口朝向和安装空间核对后确定。

- [ ] 盘点RK主控、驱动板、电源模块和电池的实际尺寸、固定孔、接头与散热空间，确定下移清单和上下层分工。
- [ ] 调整CAD布局与固定结构，给板底做绝缘，保留离地间隙；避开车轮、电机和前推铲活动范围，留出插拔、散热、线束固定及电池拆装空间。相机位置同时核对视野和排线长度。
- [ ] 按新布局试装并固定板卡，核对整车外形、重量与重心变化；同步更新正式CAD和安装说明。
- [ ] 重新核对相机出图、驱动通信和四向基础移动，观察板卡、插头和线束是否松动、摩擦或碰撞，结果追加到对应的现有记录。

完成标准：新布局有对应CAD和实物安装照片，板卡固定、绝缘和接口空间已核对；相机、通信及基础移动在调整后复测通过。仅改完CAD时登记“布局设计完成”，实物安装和复测分别登记。

### 按距离前进首轮验证 {#distance-first-run}

目标是在网页选“前进20厘米”，让RK根据四个轮子的累计计数估算距离，接近目标时降速，到达目标时发送停止，最后用尺子量车身实际移动了多少。首版输入范围为5～50厘米，默认20厘米，巡航目标轮速为6厘米/秒。

- [x] 准备网页入口、距离控制和板端检查程序。控制与检查程序的源文件已交叉编译为 ARM64 目标文件。板端完整编译、虚拟串口检查和工作台部署均待板B上电。
- [ ] 板B上线后核对身份，原生编译并运行定时、定距离两组虚拟串口检查。通过后备份当前工作台，再部署新版，核对网页、运动接口和相机新画面。[板端命令和预期结果](../02_design/05_底盘串口接线与测试.md#web-distance)
- [ ] 首轮现场按设计说明核供电、固定和停机条件。架空低速检查四轮计数方向与换算，条件就绪后由用户点击“前进指定距离”，量一次20厘米试走。记录目标、轮子估计、尺测位移、跑偏、停车原因及实际收发。结果追加到[底盘调试记录](../03_records/04_20261030_底盘串口调试.md)。

完成标准为板B收到真实计数，小车在定距离模式下减速和停车，并有一组能对照的目标、估计与尺测值。后退、横移、重复性和距离精度继续在[定距离运动](#2-电脑单轮调试泰山派40针串口直连驱动与首轮测试)登记。

### 网页四向移动与参数控制（基础已打通） {#motion-controls-plan}

用户追加“把左右加上”：本轮在同一页面接入左移、右移，以车头方向为准，共用现有速度、时间、缓慢起步及停止机制。

- [x] **左右接入：** 按已记录的M1左前/M2左后/M3右前/M4右后实现四轮组合；RK原生编译、左右具体帧、调速保持方向与原截止时间、旧请求及运行中换方向拒绝均通过，原网页已部署。
- [x] **左右架空核对：** 用户确认“两次轮组相反，都能自动停止”；真实UART4记录左右各6厘米/秒、约3秒的不同轮组、有效反馈及最终零速。检查建议中的2秒没有另算一次实测。见[左右试转记录](../03_records/04_20261030_底盘串口调试.md#web-motion-lateral-20261105)。
- [x] **四向实际移动核对：** 用户进一步确认前后左右均可以，按用户报告登记基础移动通过；具体位移、车头朝向误差和跑偏仍随定距离测试测量，不重复安排“能否移动”的基础检查。

用户同意按规划实施并要求改善布局，随后要求扩大速度范围。本轮使用已安装在个人技能目录的 `frontend-design` 技能，完成深蓝/浅青控制台、参数滑杆加数字框、剩余时间及按车轮位置排列的真实轮速。默认6厘米/秒、3秒；速度2～30厘米/秒，时间1～10秒。较高档位继续逐档验证，目标数值不直接当作车身实际速度。

- [x] **启动前选择参数：** 速度与时间分别由滑杆和数字框联动，前进、后退、左移、右移共用本次参数，默认值和范围由RK返回；30厘米/秒上限按用户追加要求实现。
- [x] **看懂当前动作：** 页面区分本次/下一次参数、当前运行目标和实际四轮回报；显示倒计时，停止按钮始终可用，诊断内容折叠。窄屏样式已实现；自动浏览器检查因工具无法可靠确认网址而停止，用户已确认布局正常。
- [x] **运行中应用速度：** 另点“应用当前速度”才改变本次目标，平缓调速且原截止时刻不变；时间草稿只用于下一次。本轮不提供给当前动作续时的按钮。
- [x] **RK独立校验：** 检查速度/时间完整整数、上下限与步长，拒绝空值、超范围、延迟旧请求和运行中直接反向；反馈中断尝试归零。板B无警告原生编译及虚拟串口具体字节检查通过，没有电脑运行板端程序测试。
- [x] **本轮现场与日志：** 用户回复“布局正常，变速后按原定时间停止”。归档日志可独立核对的是25厘米/秒目标、前后各约5秒、四轮非零回报与最终零速；不把提问中的6→8厘米/秒、8秒示例另记为独立实测。运行中不续时的精确比较由板端虚拟串口检查证明，现场报告保留原范围。
- [ ] **后续按需分档核对：** 其余速度、最长10秒及窄屏现场效果留作深入验证，不作为基础链路收尾的条件。若再出现乱码、计数重置或回包中断，先排查供电/干扰，不靠加时或加速掩盖。
- [ ] **地面测量与性能：** 量车身速度与位移，核目标轮速与麦轮车身速度的差别，以及长期带载和独立失联保护；用户确认能四向移动不替代这些测量。

本轮软件接入、参数操作与用户确认的四向实际移动已完成；距离测量、其余性能和异常停车验收继续保留。唯一正式控制定义见[设计说明](../02_design/05_底盘串口接线与测试.md#web-motion)，本轮原始证据、回退与后续用户确认见[同一调试记录](../03_records/04_20261030_底盘串口调试.md#web-motion-controls-20261105)。

### 无线移动调试与原相机网页恢复

目标：调试时小车不拖网线，电脑能无线登录板B、查询驱动并打开原网页看实时画面；本轮不扩展识别或运动控制功能。

- [x] 电脑固定热点命名为 `opto-robot-b`，沿用原热点密码，使用2.4GHz，关闭无设备时自动停热点；原设置已备份，密码不进入项目归档。
- [x] 板B新增 `board_b_hotspot`，启用自动连接；无线地址本次为 `192.168.137.16`，严格核SSH指纹与序列号后登录成功，重启后自动回连也通过。
- [x] 按用户要求扫描三个相机通道；I²C4、5未响应，I²C6在0x1a读取到识别值0xe0；临时诊断模块已恢复复位/时钟并卸载。
- [x] 备份受影响的启动配置，新增I²C6地址插件；设备树合并仅改变该接口的IMX415地址和备用传感器状态。重启后正式驱动识别 `6-001a`，采集入口指向 `/dev/video51`。
- [x] 板B有线网口断开时，无线网页返回HTTP200；720p／预览目标10帧/秒，帧号962→982，服务当时未重启。
- [x] 用户确认后段已拔过电源或关机；当时热点仍开、客户端数为0及SSH超时按断电离线记录，不新增未经验证的无线故障结论。
- [x] 用户重新上电后，板B再次自动回连，只有Wi-Fi、有线网口DOWN；相机服务自动运行，收到160430字节、三帧完整JPEG，帧号2589、2590、2591。初次断电时的零字节结果保留，不覆盖为成功。
- [ ] 用户打开无线网页目视核对现场画面；浏览器自动核对因工具不能确认网址停止。较长时间图传与移动范围留作后续验证。
- [ ] 无线恢复后按需要再做驱动只读查询及短时移动图传；通信超时停车与现场停机方式在运动调试前落实，不把网络连接成功当作运动验收。

设置方法、原始输出、回退入口及验证范围集中在[同一相机记录](../03_records/05_20261103_相机采集与电脑预览.md#wireless-camera-20261105)。蓝牙仅作方案比较，未配对或配置组网。

### 驱动板电池供电排查

目标：查清为何外部输入端约5V时，板上标3V3的输出只有约2V；先区分外接线负载与驱动板自身供电路径。查询基础链路已按本轮完成标准通过，运动、参数写入和完整控制仍由用户后续安排。

本轮沿用[底盘接线与测试](../02_design/05_底盘串口接线与测试.md#本轮只查询2026-11-04)。RK8脚TX→驱动RX2、RK10脚RX←驱动TX2、RK6脚GND→GND，驱动串口5V脚不接RK。已与同板窗口协调，SN100转板A，板B用于小车；本次未操作相机服务。

此前外部供电时两次查询接收均为0字节；用户随后报告输入端4.98V、3V3对GND约2V，且只有红灯亮。接电脑USB数据线到驱动Type-C后，用户报告3V3恢复约3.3V；随后RK真实查询通过。**这是USB辅助供电下的阶段成果，电池独立供电仍待排查。** 本次通过板B Wi-Fi `192.168.3.59` 严格核指纹及序列号 `8314b1e8ffd0321f`；旧USB网口IPv6入口本次未连上，没有改网络配置。

- [x] 盘点已有程序和验证记录：电脑USB配置查询已有真实回复；盘点时尚无RK电机串口C程序，本次已补齐。原生GCC、SSH和SCP流程可复用，厂家会改参数及转轮的示例不直接运行。
- [x] 只读核对板B身份和串口：序列号 `8314b1e8ffd0321f`；`/dev/ttyS4` 实际映射UART4与GPIO2_D0/D1，当前未见进程占用，系统登录使用 `ttyFIQ0`。本项没有打开串口或发送字节。
- [x] 按用户要求更新一张[整机接线总图](../../05_data/03_results/01_design/04_稳压板接线示意.png)，把电源输入输出、串口与共地、相机和四路电机的功能连接画在一起；未核实的针位方向、电平与相机接口保留待核，不作为实物通过。
- [x] 用户确认三根信号线按RK8脚TX→驱动RX2、RK10脚RX←驱动TX2、RK6脚GND→GND连接，驱动5V脚不接RK；本项为用户确认，未取得接线实拍或电平测量。
- [x] 用户按要求测驱动蓝色电源输入端，报告4.98V；目前为口述静态读数，没有测量照片或启动波形，不据此判定欠压或控制芯片已正常启动。
- [x] 用户按要求测3V3对GND，报告外部供电时约2V；确认USB数据线直接接驱动Type-C后恢复约3.3V。为用户口述读数，未独立核测点或波形，也不是仅USB供电的完整对照。
- [ ] 断电后断开驱动的电脑USB、RK信号线和四路电机线，仅保留原有约5V外部电源；重新上电测输入端及3V3对GND，区分外接线负载与板自身供电问题。
- [ ] 按独立驱动板测量结果继续查供电路径，确认不接电脑USB也能正常启动；保留两端电平、启动压降与正式装车供电验证，不凭当前读数认定某个稳压芯片损坏。
- [x] 准备[C查询程序](../../02_programs/01_host/04_motor_uart/motor_query.c)和[SSH/SCP上传脚本](../../02_programs/01_host/04_motor_uart/deploy_query.ps1)：显式传入串口，115200/8N1、无流控，一次仅配置或电压查询，不附加换行；原始TX/RX分别保存，配置按多行文本解析。ARM64 GCC交叉编译与静态检查通过，没有在电脑运行板端程序。
- [x] 通过USB网口本地IPv6严格核对板B序列号与SSH指纹，完成上传、GCC 13.3原生编译、AArch64程序检查及帮助/缺参拒绝检查。上传脚本已兼容带网口编号的IPv6地址。
- [x] 同板协调后，在板B分别执行一次配置查询和一次电压查询，原始TX/RX和日志均已下载；UART4累计发送22字节、接收0字节，两次均退出3（超时且无完整回复）。
- [x] 驱动Type-C接电脑后，RK发送一次配置查询，收到150字节完整回复并正确解析；源码和可执行文件与此前一致，没有修改程序或驱动参数来获取本次结果。
- [x] 将接线、编译运行、两次无回复、用户电压读数及USB辅助供电后真实回包更新到[同一底盘记录](../03_records/04_20261030_底盘串口调试.md#usb辅助供电后配置查询通过)，明确验证条件。

查询阶段完成标准已在USB辅助供电条件下满足：目标板身份与节点有依据，RK发出一条不改配置的查询，收到驱动原始回复，解析与原文一致且电脑可查看。当前供电排查的完成标准另核：独立驱动板及实际接线下3V3与启动正常，纯电池路径可复现；不能把USB下的成功套用为纯电池通过。

### 采购与到货

- [ ] 核对其余已购件的到货、型号和配件。
- [ ] 配齐供电线束、保护开关和安装件；核对JY901S姿态传感器的接线配件后购买。
- [ ] 补相机发票，提交已有报销材料，并跟进实际报销结果。

型号、数量、价格和订单状态统一见[购买清单](../../03_hardware/01_硬件清单.md)，报销进度见其中的[报销材料](../../03_hardware/01_硬件清单.md#报销材料)。

### 机械安装

- [x] 2026-11-12已导出当前整车CAD的上下两片碳纤维板。STEP与整车板件一致，两个STL的尺寸和网格封闭性通过电脑检查。[碳纤维板导出包](../../03_hardware/01_机械/06_碳纤维板导出包.zip)
- [x] 2026-11-06已整理可转发的[前推铲打印包](../../03_hardware/01_机械/03_打印件/10_前推铲打印包.zip)：三个STL各1件，附STEP、打印说明和图；电脑模型与文件检查通过。
- [ ] 向官方核对棋具、场地和比赛细则，调整结构与测试要求。
- [ ] 试打印已完成电脑设计的可调相机支架，核对实物固定、排线、最终机位视野与振动；桌面相机出图和电脑预览先行推进。
- [ ] 试打印V形推铲及左右支架，按正式棋子规格检查安装、推送和释放效果。
- [ ] 配合[板卡下移](#lower-board-layout)完成底板、板卡、电池和线束的实物安装，核对牢固程度、整车尺寸和重量。

支架与布局要求见[底盘设计](../02_design/04_四驱底盘方案.md)，推铲见[打印方案](../02_design/07_前推铲与打印.md)；制作和实测结果更新[机械记录](../03_records/03_20261024_机械装配验证.md)。

## 未完成即将执行

### 制定并落实固定的接线要求 {#fixed-wiring-plan}

目标：每根线接哪里、用什么接头、怎样固定都有统一依据，装车后能按图核对，拆装后能正确恢复。随新布局编制逐线表和走线路径，接线的正式定义继续统一维护在[系统规划的线束部分](../02_design/03_系统规划.md#7-模块装配与线束)及[底盘接线说明](../02_design/05_底盘串口接线与测试.md)。

- [ ] 按实际接线逐根登记两端设备、接口名称、脚号、用途、电压或信号电平、线色、线径、长度和插头方向；未知项先核实再定稿，保留现有已验证的接口对应关系。
- [ ] 统一线束两端编号、正负极标识与接头选择；采用适合装车的可靠连接方式，明确插头锁紧、端子紧固、绝缘和防拉扯要求。
- [ ] 明确动力线与相机、串口、编码器等信号线的走向和固定点；预留适量拆装余量，避免线束碰轮、夹线、磨损或拉扯相机排线，导电部分与碳板隔离。
- [ ] 固定断电接线、上电前核对通断和极性、上电后测电压及检查带载表现的顺序；按最终实物更新接线图、逐线表和照片，拆装恢复后复测相机与电机通信。

完成标准：接线图、逐线表、两端标签和实物一致；按同一份说明可以拆装恢复，关键电压、通信和实际动作有核对结果。文档制定完成与实车接线通过分别登记。

### 实现单个棋子的自主决策与推送 {#single-piece-autonomy}

目标：操作者放置一枚棋子、设定目标区并启动后，小车自行观察棋子与目标位置，决定如何接近、对准和推送，到位后退出并再次确认结果。正常执行过程中无需人工遥控，调试时保留人工紧急停止入口。

前置：新布局和接线满足运行要求，前推铲完成试打印与安装核对，相机在最终机位完成标定，底盘具备本轮需要的距离控制和停车能力。直接复用现有相机、运动程序及电脑查看日志的入口。

- [ ] 在最终装车机位核对相机标定和位置换算，自动找出单枚棋子及目标区，得到可供运动使用的相对位置；用真实摆位核对识别、位置误差和处理耗时。原始输入与人工答案分开保存。
- [ ] 用固定摆位先核对前推铲能接触、推动和释放真实棋子，记录打滑、卡住、偏移及退出后的棋子位置，再接入自主控制。
- [ ] 依据棋子、小车与目标区的位置生成接近和推送路线，明确何时前进、横移、调整方向、停车和重新观察；显示当前阶段及作出该动作的原因。
- [ ] 串起“观察 → 接近 → 对准 → 推送 → 到位停车 → 后退释放 → 再次观察确认”；根据新画面和轮子反馈修正偏差，目标丢失或反馈异常时停车，记录是否重新观察、重试或结束及原因。
- [ ] 在约定场地改变单枚棋子的起点和偏差，测试前约定目标区判定、允许误差和重复次数；保存成功与失败的完整视频、识别位置、决策理由、实际指令及反馈，记录到位结果、耗时和人工介入情况。

完成标准：实车从真实观察结果出发自主决定动作，把一枚棋子推入设定目标区，后退释放并确认到位；异常场景能停止并说明原因。电脑离线识别、RK板端程序运行、实车自主推送分别登记，固定动作演示和人工辅助测试保留各自验证范围。

校正、识别、机构和运动结果分别更新[透视变换记录](../03_records/01_20261023_透视变换.md)、[象棋识别记录](../03_records/02_20261023_象棋识别.md)、[机械记录](../03_records/03_20261024_机械装配验证.md)与[底盘调试记录](../03_records/04_20261030_底盘串口调试.md)，本节统一维护任务状态。

### 配套的定距离运动

- [ ] 前进定距离完成首轮板端检查和尺测后，再补后退和左右平移的定距离控制。[四向定距离任务](#2-电脑单轮调试泰山派40针串口直连驱动与首轮测试)

## 将来需要做

以下是已经登记的深化内容，保留真实完成项和未完成项；以后按需要逐项选择，不在本轮自动展开。

### 1. 摄像头出图与原始画面

**基础链路已打通，当前暂不继续。** 以下保留既有完成项和后续深化清单，未勾选项不作为进入底盘基本控制的前置。

后续深化目标：在RK运行相机服务，电脑浏览器打开同一网页，完成**实时看画面 → 调整相机参数 → 拍照 → 分析这张照片**。分析包含画面质量检查、棋子检测识别、透视校正和位置测量，分阶段接入并分别验收。

硬件前置：按[已有接口核对](../03_records/03_20261024_机械装配验证.md#摄像头到货建模与支架尺寸2026-11-02)断电接好IMX415和排线，保证供电、散热与固定，电脑和RK网络可达；支架打印、装车按机械任务并行推进。

此前已在板B部署正式C/GCC相机服务，浏览器看图、拍照、大图、“检查画面”和手动曝光应用已用真实场景验证；四路白平衡的板端接口与浏览器应用读回已通过，目前曝光、白平衡均恢复自动模式。用户已明确不需要高分辨率，当前使用720p／预览目标10帧/秒／JPEG质量85，可选720p和1080p，4K暂停提供；1080p恢复图像调节服务后出现超过10秒无新帧并重启，不算稳定。5分钟有线状态监测已通过，长时图传、异常恢复及后续棋子识别、透视校正和位置测量继续验证，结果见[实机记录](../03_records/05_20261103_相机采集与电脑预览.md)，分工与接口见[相机网页方案](../02_design/03_系统规划.md#camera-capture)。

#### 配通相机驱动和图像输出

- [x] 核查本次实际板卡的系统和驱动：板B为Ubuntu 24.04.5、内核 `6.1.99-rt36-tspi`，IMX415驱动已内置，图像处理服务和GStreamer采集、编码组件已存在。
- [x] 对照手册核查上电相关配置：配置为2.8V/1.8V/1.2V、37.125MHz、低电平有效复位，供电常开且共用使能脚；电压配置值在手册范围内，芯片端实际电压和波形未测量，见[上电配置核对](../03_records/05_20261103_相机采集与电脑预览.md#上电配置核对)。
- [x] 在板上实际检测通信地址：I²C4的 `0x1a` 返回符合当前驱动判据的 `0xe0`；临时诊断模块已卸载并恢复资源，见[地址问题与修正](../03_records/05_20261103_相机采集与电脑预览.md#地址问题与修正)。
- [x] 通过启动配置插件将I²C4的IMX415地址改为 `0x1a`，重启后正式驱动绑定成功；保留原CAN和串口配置、修改前后文件及回退备份，未替换内核或系统镜像。
- [x] 确认 `/dev/video-camera0` 采集入口，用现有GStreamer工具完成两轮各60帧的NV12、1280×720采集，协商帧率30帧/秒；JPEG照片已传回电脑打开，见[拍照与电脑取图结果](../03_records/05_20261103_相机采集与电脑预览.md#拍照与电脑取图结果)。此项为前期短时工具验证，正式程序验证见下。

#### 先实现网页实时画面和拍照

- [x] 用C和GCC实现常驻采集、JPEG编码与网页服务，已在板B原生无警告编译，部署到 `/opt/opto-camera`，由 `opto-camera.service` 开机启动；[源码及操作入口](../03_records/05_20261103_相机采集与电脑预览.md#正式网页服务与参数验证)已整理。
- [x] 用HTTP/MJPEG持续发送相机画面，限制帧缓存和预览连接数；1280×720阶段已核对连续图流返回，电脑浏览器已实际看到现场。
- [x] 网页已实现拍照、缩略图、大图、原图下载和删除；浏览器实际点击拍照并打开大图，HTTP测试核对新帧编号、文件一致性及删除后不可再取。时间标为板端接收时间，不承诺点击瞬间曝光。
- [x] 实现照片仅暂存在RK内存，最多12张、合计32MiB、保留30分钟，到期或服务重启清空；切换图像参数保留已有照片。用户主动下载才保存到电脑，测试照片已清理；到期边界和长时资源表现随稳定性测试核对。
- [ ] 核验采集异常、过期遮罩、拍照超时、浏览器刷新和断网重连，确认旧画面不显示为正常直播，恢复后使用新帧。

#### 接入网页相机参数

- [x] 分辨率、预览目标帧率和JPEG压缩质量的接口及浏览器基础应用已验证，切换保留已有照片。此前1080p／4K各30帧工具测试和短时网页结果不代替稳定性验收；当前收敛为720p／1080p选项，4K暂停提供。
- [x] 已恢复既有图像自动调节服务的正确控制通道，使用同一个调节引擎；自动／手动曝光、增益和四路白平衡的板端接口已验证设置与读回，照片亮度随曝光设置变化。目前曝光、白平衡已恢复自动模式。
- [x] 浏览器实际切到手动并点击“应用曝光”，收到设置读回成功提示，显示20毫秒／63.0957倍且预览继续；随后经接口恢复自动曝光。
- [x] 浏览器实际选择手动白平衡并点击“应用白平衡”，收到设置读回成功提示且预览继续；随后恢复自动模式。板端另已核对四路1.5/1/1/2增益，现场色彩观感随照明继续调整。
- [ ] 按实际能力接入翻转、锐化、降噪等图像参数，分别核验设置、读回与画面效果；不把已有曝光／白平衡接口通过记作整组完成。
- [x] 已提供照片大图供观察细节，基础画面检查结果见下节；当前未查到电动对焦控制项，不承诺网页自动对焦。
- [x] 基础分辨率、预览目标帧率和JPEG质量已保存到配置，随服务启动恢复。
- [ ] 补恢复会话初始设置和曝光／白平衡参数预设；当前曝光和白平衡只在本次图像调节服务运行中有效。调整分辨率、裁剪、翻转或机位后重新核对标定，避免沿用不匹配的位置换算。

#### 接入照片分析

- [x] 对指定照片独立解码JPEG并计算亮度平均值、标准差、256档直方图、过暗／过亮像素比例和相对清晰度；浏览器实际拍照并点击“检查画面”成功。结果绑定照片编号，切图或删除时清理，不中断预览；清晰度分数不代表对焦或识别准确率。
- [ ] 后续识别、校正和测量也使用同一照片编号，并记录算法参数及标定版本，原图与结果图分开；分析执行有界且不阻塞预览。
- [ ] 接入四点透视校正，网页可选参考点并对照原图、校正图；补相机去畸变和已知尺寸的平面标定，才显示对应平面的毫米坐标或距离，未标定时显示像素位置。棋子顶面高度、镜头畸变和机位变化带来的误差需实测。
- [ ] 实现自动找出棋子，再判断身份和字色，显示检测范围、位置、识别结果或“未知”；现有人工选区识别示例只作算法对照，尚缺全图检测和板端推理。板端沿用C或提供C接口的库，不把旧Python示例直接当作部署程序。
- [ ] 用真实棋子和独立测量位置核对识别与位置结果，分别记录误识、漏检、拒识、位置误差和耗时；人工选点、自动检测、像素位置和实际平面位置分别验收。

#### 板端与网页联调验收

- [x] 完成720p的300.697秒有线状态监测，61次查询均为新鲜状态，帧号1545→4551，服务运行时间155→456秒且未回落；期间进行了网页拍照、检查和手动曝光／恢复。此项只验收5分钟状态，不代替持续图流或延迟测试。
- [ ] 后续重新选择相机深化时排查常驻服务停帧：2026-11-04移植总控从板端日志确认10:30:52触发“10秒无新帧”并自动重启，执行文件指纹未变化。该检查实际表示10秒没有成功发布有效JPEG，不能直接认定传感器停了。服务日志原件已归档；用户选择恢复本项并完成同板协调后再补内核日志，再区分上游不交付、帧率处理/编码停住、取帧后被拒绝及发布锁等待；必要时制作独立诊断版本。累计重启计数不当作同一原因的发生次数，见[同一相机记录](../03_records/05_20261103_相机采集与电脑预览.md#camera-stall-20261104)。
- [ ] 在电脑浏览器同时预览、拍照和手动分析，改变真实场景，确认新照片及分析结果一一对应；调整参数后读取实际值并检查画面变化。正式装车后另核最终机位、遮挡和振动。
- [ ] 首轮分别经有线和Wi-Fi连续预览10分钟，检查卡顿、内存和处理器负载；跟进已有MIPI接收与时序提示。再累计联调至少30分钟，穿插调参、拍照与后续分析，记录持续帧率和资源表现。
- [ ] 实测从现场变化到电脑显示的端到端延迟；测试停止重开、浏览器刷新、断网重连和RK重启恢复，手动启动、开机启动配置与重启后实际恢复分别登记。
- [ ] 网页基础功能通过后，增加按需保存短视频及下载；停止保存后在电脑实际播放核对，普通测试文件按用户要求清理。

后续完整工作台的验收标准：RK上的正式采集和网页服务实机运行通过，电脑浏览器能实时看图、调节已适配的参数、拍照并下载对应新图；三类照片分析分别有真实输入和可核对结果。预览、拍照、参数控制、各类分析和装车验证逐项登记，不以网页外观、编译通过或现有离线示例代替验收。

2026-11-04用户确认本轮以拍照和电脑看图为阶段成果，先转下一项。连续运行、异常恢复、棋子识别、透视校正和位置测量在以后选择本项深入时再安排，不自动继续。已通过的5分钟有线状态监测不代替10／30分钟图流、Wi-Fi长时间传流、实际延迟、断网及板卡重启恢复或装车验收。过程见[同一相机记录](../03_records/05_20261103_相机采集与电脑预览.md)。相机服务使用8080端口，其他移植项目仍按各自授权推进，不重复改动已生效的相机地址配置。

### 2. 电脑持续查看画面、识别过程和运行日志

后续深化目标：调试时能回答“小车看到了什么、程序怎样判断、准备做什么、实际执行怎样”。优先通过Wi-Fi传画面与数据，复用已有远程终端查看日志、启动和停止程序；具体连接按当前RK系统核实。蓝牙按需要补充少量状态或文字数据，不作为首轮连续画面的主链路。

本节在第1步的原始画面与采集日志基础上扩展，随识别和运动功能逐项接入，不把全部调试界面作为相机出图的前置条件。

- [ ] 复用第1步已通过的预览和日志查看方法，整理成固定的启动、停止、重连和取回测试资料的操作入口。
- [ ] 逐项接入实际算法输出：检测框、身份或“未知”、位置估计、当前目标、运行阶段及阶段切换原因；尚未实现的能力不显示为真实结果。
- [ ] 接入运动调试数据：设定动作/距离、实际发送命令、轮速和编码器原始反馈、累计距离、停车原因及异常提示；不能只显示成功/失败或数量汇总。
- [ ] 画面、识别结果和运动日志带可对应的时间或帧号；每次测试记录程序版本、参数和模型，能找到当时的原图、指令和反馈。接收时间与实际采集时间分别说明，不假称精确同步。
- [ ] 显示连接中断和画面过期，限制预览与日志缓存；网络慢或电脑接收慢时，调试显示不阻塞RK运动控制，并在RK保留必要原始数据。

完成标准：电脑能同时持续查看原始画面和真实日志，并能保存、取回同一次测试的数据；后续每接入一项算法或运动功能，就增加对应显示。当前未接入算法时，先验收画面和日志；识别显示随算法单独验收。

后续预期成果：在电脑前能够看见相机画面、查看程序输出，并为下一步完整观察一次定距离运动测试做好准备；目前仍待实施和验收。

### 3. 前后与横向定距离运动 {#2-电脑单轮调试泰山派40针串口直连驱动与首轮测试}

网页四向控制已接入，用户已确认前后左右实际移动均可以，基础结果见[当前网页任务](#motion-controls-plan)。本节保留后续地面定距离、跑偏与重复性验收。

后续直接复用已打通的四向运动链路，先实现一个方向的距离累计、减速和停车；不重复安排单轮起转或四向能否移动的基础测试。若出现新的方向或反馈异常，再针对性排查。

目标：分别设置前进、后退、左横移、右横移的距离，用地面实测核对小车实际移动，找出换算、打滑、跑偏和停车造成的误差。电机基础对应关系随测试复核，不重复安排一轮已完成的入门调试。

启动条件：供电和安装满足本次动作要求，电脑能查看运动日志；落地前确认正常停车与通信中断等异常停车条件，独立失联保护仍按[接线与测试](../02_design/05_底盘串口接线与测试.md#6-异常测试与落地条件)核验。

- [ ] 盘点本车已有运动代码并复用，补齐四轮速度换算、距离累计、减速与停车；核实际RK串口接线、轮序/方向及原始反馈，发现不符时针对性排查。已有编辑运行流程不等于本车运动程序已通过。
- [ ] 将“走指定距离”落实到RK控制：驱动主要接收轮速，RK根据反馈累计运动并决定减速、停车；若先用“速度×时间”粗测，明确记录方法，不算反馈定距离控制已完成。
- [ ] 在可测量的场地上标起点，以车体同一参考点测停车后的位移；前进、后退、左横移、右横移分别测试，距离先短后长，记录速度、载荷、地面和供电条件。
- [ ] 每次同时保存设定距离、编码器估计距离、地面实测距离及误差，另记侧向偏移、朝向变化和停车后位置；保留实际指令、反馈及视频/测量照片。
- [ ] 同一方向与条件重复测试，再比较不同距离、速度下的结果；测试前明确重复次数，允许误差按真实场地、车体和推送余量确定，不凭一次成功认定稳定。
- [ ] 相机预览与运动同时运行，检查指令/反馈间隔和停车是否受影响，以及车载供电是否掉压、重启；基础动作稳定后再扩展旋转、组合动作和带载测试。

完成标准：四个方向均有可重复核对的“设定距离—编码器估计—实测位移”数据及跑偏、朝向和停车结果；完成本轮约定的误差与停车验收。轮子转了、反馈数值变化或程序正常退出，均不能代替车身位移验证。

具体操作和实际结果继续更新[同一底盘调试记录](../03_records/04_20261030_底盘串口调试.md)。

### 4. 车载识别与单枚推棋 {#4-车载识别与单枚推棋}

2026-11-06已按用户要求提前到[单棋子自主决策与推送](#single-piece-autonomy)，相关任务和完成标准统一在该节维护。后续棋子身份、字色识别与运动中识别的深入验证，继续结合网页照片分析和真实场景开展。

### 二维定位、场地地图与连续推棋

底盘、相机和基本识别通过后再开展；目前只完成方案评估。

- [ ] 接入姿态传感器，结合相机和轮子反馈，持续估计小车的位置与方向。
- [ ] 建立场地与棋子地图，规划路线，连续推送多枚棋子并确认结果。
- [ ] 先在无对手多枚场景中验证目标编号、位置和完成状态，再比较身份可信、可达性、完整推送耗时及分值等目标排序策略；记录选中/改选原因，用相同或成组对应布局比较成功率、耗时和实际得分。
- [ ] 测试定位丢失后的恢复，以及不同光照、电量和对手条件下的稳定性。

方法、传感器取舍和验证要求见[二维定位方案](../02_design/03_系统规划.md#二维定位与场地地图评估)。先验证现有相机方案，额外测距设备按实际需要再评估，三维重建暂不开展。

## 状态维护

本计划只维护进度、下一步和完成标准；具体参数、购买明细、操作过程和测试证据更新到对应文件。标记完成时说明是电脑检查、RK板端运行，还是实车验证。
