qyq11/opto-chess-robot-2027/01_docs/04_meetings/01_20261023_会议纪要.md

---
slug: /meetings/20261023
sidebar_position: 1
---

# 2026-10-23 会议纪要

会议主题：硬件采购与透视变换算法研究。根据本次讨论整理；负责人和完成日期尚未确定。

## 一、会议资料管理

1. 本次讨论结果保存为本文件。
2. 会议资料统一放在 `01_docs/04_meetings/`，后续会议纪要、会议汇报和相关整理资料沿用该目录，按日期与主题命名。
3. 执行任务统一维护在[开发计划](../01_plans/01_开发计划.md)中；本纪要保留会议决定，并在事项完成后补充结果与成果链接。

## 二、会议讨论结果

### 1. 硬件采购

- **底板：购买碳纤维底板。** 选用碳纤维材料，以改善支撑性；具体尺寸、厚度、安装孔位和承载要求需在采购前核对。
- **轮子：购买麦克纳姆轮。** 后续底盘按麦克纳姆轮方向推进；具体轮径、数量、轮组配置及与电机的安装兼容性需在采购前核对。

以上为 2026-10-23 当时的决定，采购、到货与实物验证均待执行。**2026-10-24 后续调整：** 用户确定 RK 主控直连相机（可双目）并连接 STM32 的主线，单车4个60mm麦轮（2左＋2右），备件另列；碳纤维底板需支持板卡安装与线束连接，仅从国内渠道采购；原并列整机方案停止执行。当前要求见[整机方案](../02_design/01_整机方案.md)与[采购清单](../../03_hardware/01_硬件清单.md)。

### 2. 算法研究

- 研究会议中提到的 **perspective 算法**，即透视变换（Perspective Transform），目标是将斜视图中的目标平面校正为俯视图。
- **使用 Python 程序完成研究与实现。** 后续需保留输入原图、标注对应点的图像和俯视结果，便于直观看到并核对变换效果。
- 2026-10-23 执行进展：已完成 [Python 单图示例](../../02_programs/01_host/01_perspective/perspective_demo.py)及[原图/俯视图对比](../../05_data/03_results/02_perspective/20261023_perspective_comparison_01.png)。使用 OpenCV 官方实拍样图，50 个非拟合角点 RMSE 为 6.9073 输出像素；项目相机复核待开展。详情见[研究记录](../03_records/01_20261023_透视变换.md)与[开发计划](../01_plans/01_开发计划.md)。

## 三、落实情况

任务与采购状态统一维护在[开发计划](../01_plans/01_开发计划.md)，本纪要不另建待办。透视变换单图示例已完成，采购、项目相机复核和实车验证尚未完成。2026-10-24经成本与资料核查，用户最终确定泰山派3M RK3576完整成品板、4GB RAM/64GB eMMC；当前选型以[整机方案](../02_design/01_整机方案.md)为准，不将会后决定改写为10月23日会议已确认的具体型号。

## 四、会后研究进展

2026-10-23 根据后续要求，对照赛题第1页开展象棋文字识别：已找到并归档两张可追溯真实照片，使用本地 Python OCR 完成棋字与字色分类示例。12 个人工棋面区域中7个正确、5个拒识，将/帅样本正确3/4；全图自动检测和实际比赛棋子验证待开展。唯一主记录保存于[象棋识别记录](../03_records/02_20261023_象棋识别.md)，来源、模型、全部预测及后续安排均可从该记录访问。

随后新增低机位生成图的“Perspective棋面校正→OCR”完整演示，详见[识别记录第7节](../03_records/02_20261023_象棋识别.md#7-低机位生成图透视校正与识别)。模拟图中帅由“中/未知”变为“帥/帅”；图像生成来源、人工参考点、矩阵与输出均已保存。真实相机标定、自动检测和比赛精度仍待验证。

## 五、2026-10-24 参考资料说明

用户说明现有三份培训材料由他人制作，有参考价值，但不要求按照其完整思路执行。原件见[资料清单](../05_resources/01_资料清单.md#外部培训参考)。当前固定系统架构，算法、机位、局部机构和策略保持开放，用实验结果决定后续调整。
