qyq11/opto-chess-robot-2027/01_docs/05_resources/02_官网下载链接.md

---
slug: /resources/sources
sidebar_position: 2
---

# 核心资料来源与下载

更新日期：2026-10-24。RK 与国内渠道本次已核对公开入口；比赛通知沿用既有归档，本次没有将旧核查结论当作最新细则。

## 比赛规则

- [第十五届赛题官方通知](https://gd.moocollege.com/home/newsDetails?newsId=131060) · [完整通知 PDF](https://oss.moocollege.com/competition-platform/news/file/0/7t82ln31_1784623047741.pdf)。本地保留[用户下载的 3 页赛题原件](../../04_references/01_official/01_第十五届赛题要求.pdf)，具体来源与哈希沿用[来源元数据](../../05_data/01_raw/02_xiangqi/sources.json)。
- 后续规则、答疑和赛程从[竞赛官网](https://gd.moocollege.com/home)确认；棋具规格/分值、门宽、时长和激光用途仍在计划中跟踪，不自行补全。

## RK主控与接口

| 用途 | 一手来源 | 与本项目的关系 |
| --- | --- | --- |
| 已确定开发板 | [泰山派3M官方商品](https://item.szlcsc.com/57330947.html) · [官方购买入口](https://lckfb.com/project/detail/lckfb-tspi3m-rk3576-4g-64g?param=baseInfo) | RK3576、4GB RAM/64GB eMMC，LCKFB-TSPI3M-RK3576-4G-64G（C54110287），完整成品板 |
| 外形与整板规格 | [官方商城所附规格书原件](../../04_references/04_datasheets/01_泰山派3M_RK3576_规格书.pdf) | 第1页85×57mm、图示V1.3；安装孔、板厚与净重待核，不用商品毛重作装车净重 |
| 系统与镜像 | [泰山派3M文档](https://wiki.lckfb.com/zh-hans/tspi-3-rk3576/) · [快速指南](https://wiki.lckfb.com/zh-hans/tspi-3-rk3576/system-usage/) | 官方烧录、系统和开发资料入口；本车未完成烧录验收 |
| 排针与硬件 | [40Pin V1.0说明](https://wiki.lckfb.com/zh-hans/tspi-3-rk3576/hardware-gpio/taishanpi-3m/v1-0.html) | 根据到货版本取得原理图及孔图；业务UART针号、电平、复用和设备节点待最终核对 |
| 供电与散热 | [规格书原件](../../04_references/04_datasheets/01_泰山派3M_RK3576_规格书.pdf) · [快速指南](https://wiki.lckfb.com/zh-hans/tspi-3-rk3576/system-usage/) · [散热套件说明](https://wiki.lckfb.com/zh-hans/tspi-3-rk3576/development-kit/cooling-fan-kit.html) | 规格书第3页5V-4A输入；wiki峰值≥3A，采购按5V/4A起并另核余量。FAN仅5V，官方散热套件需2026-07-06或之后镜像；Type-C与排针不同时供电 |
| USB相机 | [官方USB相机识别与验证](https://wiki.lckfb.com/zh-hans/tspi-3-rk3576/system-development-compilation/opencv/usb-camera-verification.html) | Linux UVC、格式/帧率和图像采集；当前相机与机位待实测 |
| 芯片能力 | [Rockchip RK3576简介PDF](https://www.rock-chips.com/uploads/pdf/2024.3.18/191/RK3576%20Brief%20Datasheet%20V1.2-20240311.pdf) | CPU/NPU能力依据，峰值不等于本车帧率 |
| 模型适配 | [RKNN Model Zoo](https://github.com/airockchip/rknn_model_zoo) · [泰山派YOLO11教程](https://wiki.lckfb.com/zh-hans/tspi-3-rk3576/ai/yolo-11/detection-model.html) | RK3576目标转换、C/C++板端部署和版本匹配；不证明现有PP-OCRv6已兼容 |

## 采购与配套来源

- [完整购买清单](../../03_hardware/01_硬件清单.md)：统一维护选型、待购报价及已购摘要；实际采购明细和订单金额由[采购台账](../../03_hardware/02_采购/01_采购台账.xlsx)维护，合同与后续发票集中归档，避免重复统计。
- [微雪OV4689 4MP USB Camera(A)](https://www.waveshare.net/shop/OV4689-4MP-USB-Camera-A.htm)：当前单目USB相机候选，型号与近场图像质量待实测。
- [嘉立创FA](https://www.jlcfa.com/)：标准件及加工服务入口；未核实其碳纤维加工供货能力。

零部件优先淘宝/京东，主控采用立创官方入口。价格、库存、交期及加工能力以下单时核对结果为准；孔位、电机轮毂、电源和整车重量需闭合后再形成整套订单。

## 算法与外部参考

- [MobileNetV3 原论文](https://arxiv.org/abs/1905.02244) · [本地 PDF](../../04_references/02_papers/01_MobileNetV3_2019.pdf)：轻量分类思路，尚未在本项目训练或板端测时。
- [OpenCV 单应教程](https://docs.opencv.org/4.x/d9/dab/tutorial_homography.html) · [几何变换 API](https://docs.opencv.org/4.x/da/d54/group__imgproc__transform.html)：平面校正与适用边界。
- 原始照片、OCR 权重与许可、AI 生成输入的具体来源沿用[象棋识别记录](../03_records/02_20261023_象棋识别.md)，不在此重复维护。
- [他人制作的三份培训原件](./01_资料清单.md#外部培训参考)保留供参考，不认定为官方文件或当前执行方案。

不再为已停止的整机路线保留下载副本或并行开发清单；后续确需研究新方法时，按实际问题选择一手来源。
