qyq11/opto-chess-robot-2027/03_hardware/01_机械/01_厂家资料/02_310电机/04_电机参数.docx

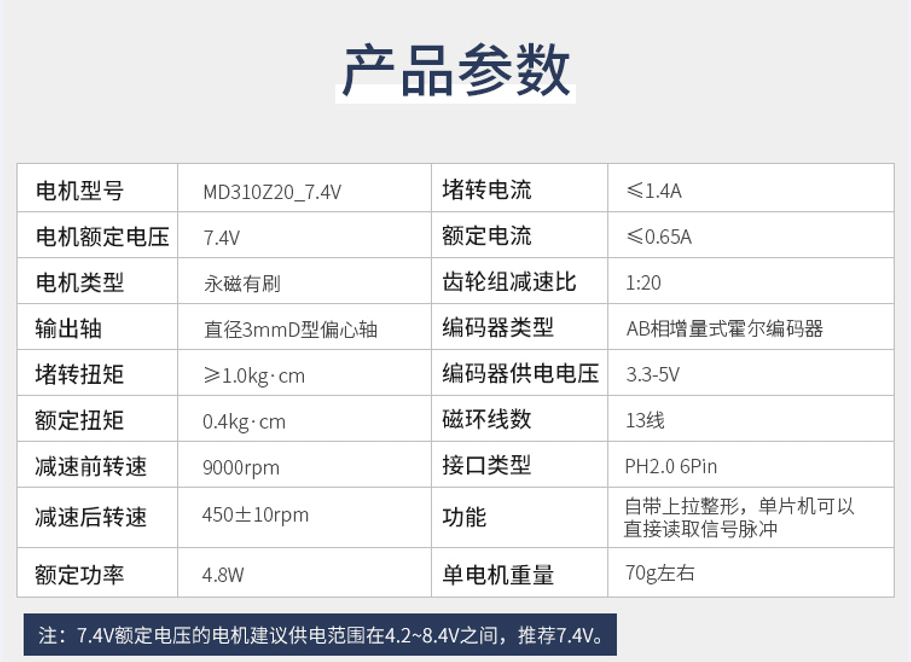
[picture p26: figure]
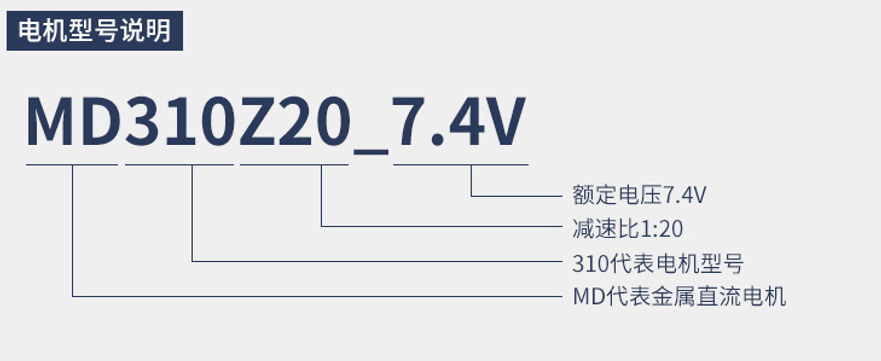
[picture p27: figure]
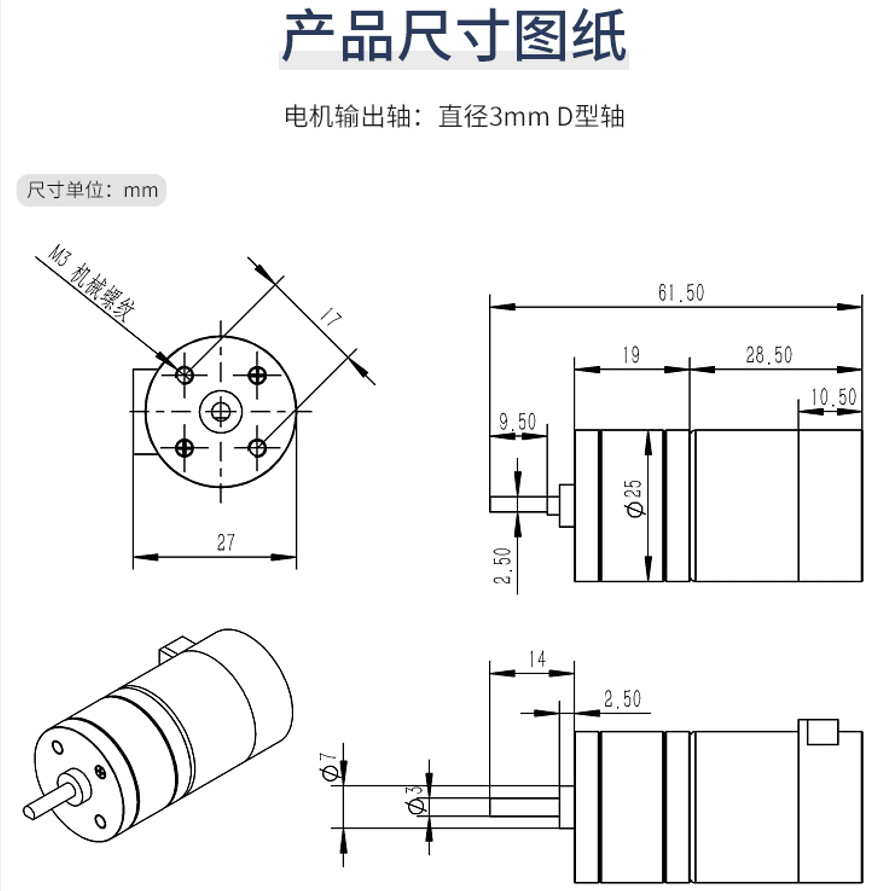
[picture p28: figure]
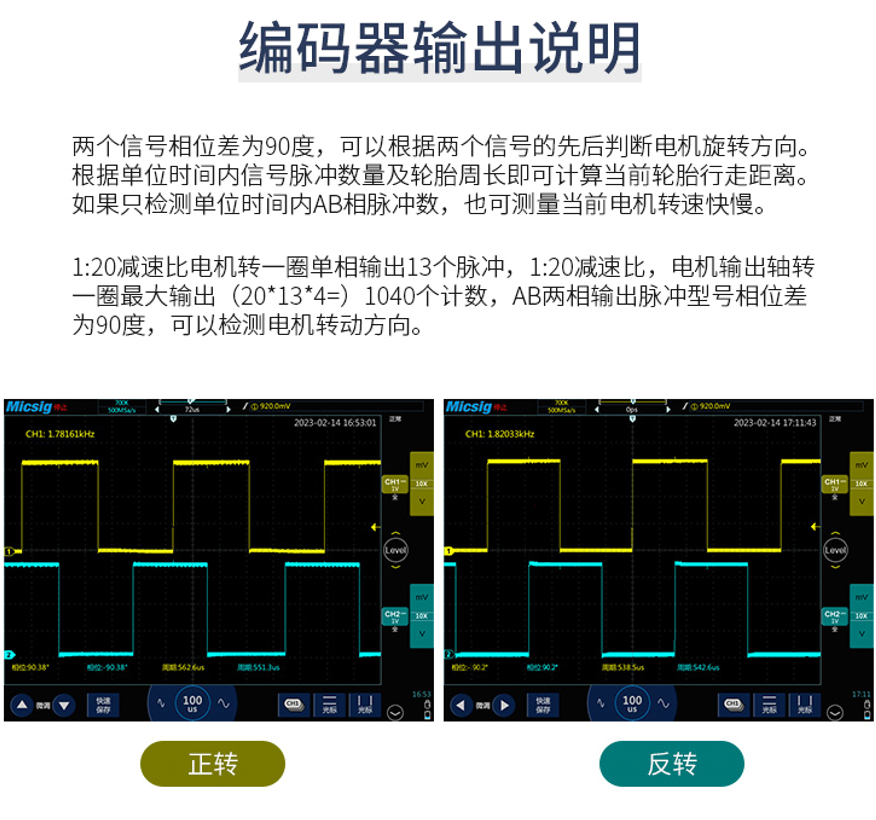
[picture p29: figure]
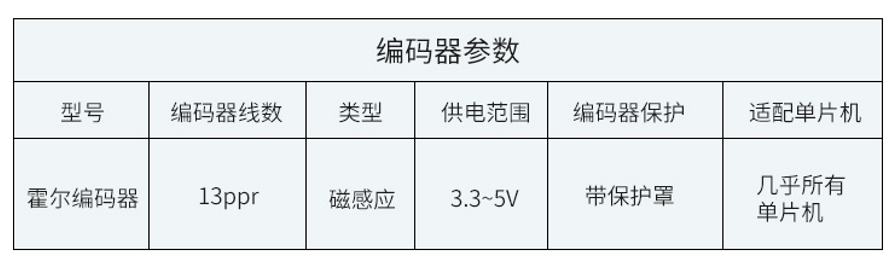
[picture p30: figure]
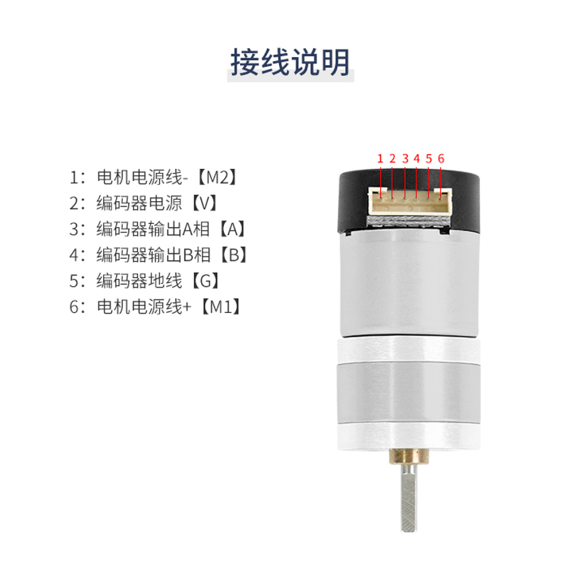
[picture p31: figure]
