qyq11/opto-chess-robot-2027/03_hardware/02_采购/09_20261030_轮趣_发票_5127831576100359305.pdf

# 电子发票（普通发票） 发票号码： 开票日期：

购
买
方
信
息

统一社会信用代码/纳税人识别号：

销
售
方
信
息

统一社会信用代码/纳税人识别号：

名称： | 名称：
项目名称 | 规格型号 | 单 位 | 数 量 | 单 价 | 金 额 | 税率/征收率 | 税 额
合 | 计
价税合计（大写） | 捌拾圆整 ¥80.00 （小写）
备 注 | 购方开户银行:中国建设银行上海第五支行; 银行账号:31050166360000002376; 5127831576100359305/wheeltec旗舰店

开票人：

26442000012481893826

2026年10月30日

上海工程技术大学

12310000425022547M

轮趣科技（东莞）有限公司

## 91441900MA518CH52Y

¥70.80 | ¥9.20

黄妙银

*电子元件*加高板 | T5X | 个 | 2 | 35.3982300885 | 70.80 | 13% | 9.20
