qyq11/opto-chess-robot-2027/03_hardware/02_采购/08_20261030_亚博_发票_5127385935119112530.pdf

购
买
方
信
息

统一社会信用代码/纳税人识别号：

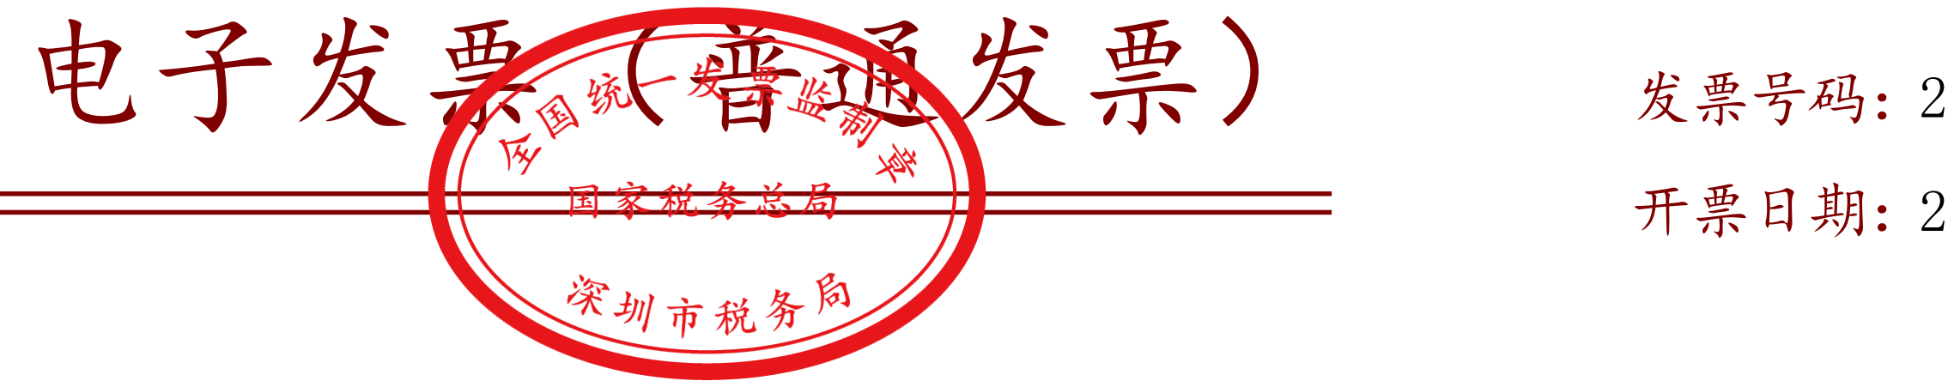
[picture p32: figure]
电子发票（普通发票）; 发票号码：; 开票日期：

销
售
方
信
息

统一社会信用代码/纳税人识别号：

名称： | 名称：
项目名称 | 规格型号 | 单 位 | 数 量 | 单 价 | 金 额 | 税率/征收率 | 税 额
合 | 计
价税合计（大写） | 陆拾叁圆柒角整 （小写） ¥63.70
备 注 | 订单：5127385935119112530 店铺：亚博智能科技

开票人：

下
载
次
数：1

26952000004616646061

2026年10月30日

上海工程技术大学

12310000425022547M

深圳市亚博智能科技有限公司

91440300359427991E

*微电子组件*电子模块 机器人稳压电源扩
展板
件 | 1 | 56.37 | 56.37 | 13% | 7.33
¥56.37 | ¥7.33

张钰
