qyq11/opto-chess-robot-2027/03_hardware/01_机械/01_厂家资料/03_四路电机驱动/10_固件更新说明.pdf

# 如何更新固件

打开附件中提供的烧录软件FlyMcu，将四路电机驱动板的typec口与电脑相连，然后点击软件中的搜索 串口。并选择你的驱动板所用的串口。

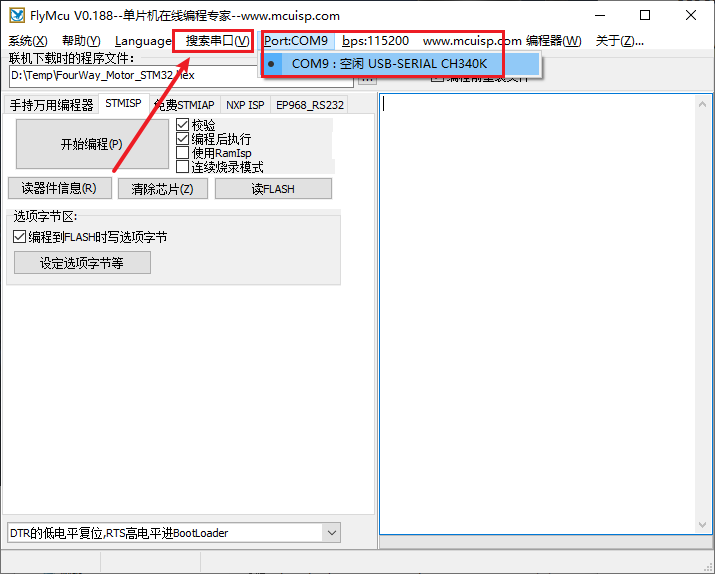
[picture p33: figure]

程序文件这里选中下载到的固件文件，然后注意其他的红框中的设置都要与图中的一样。

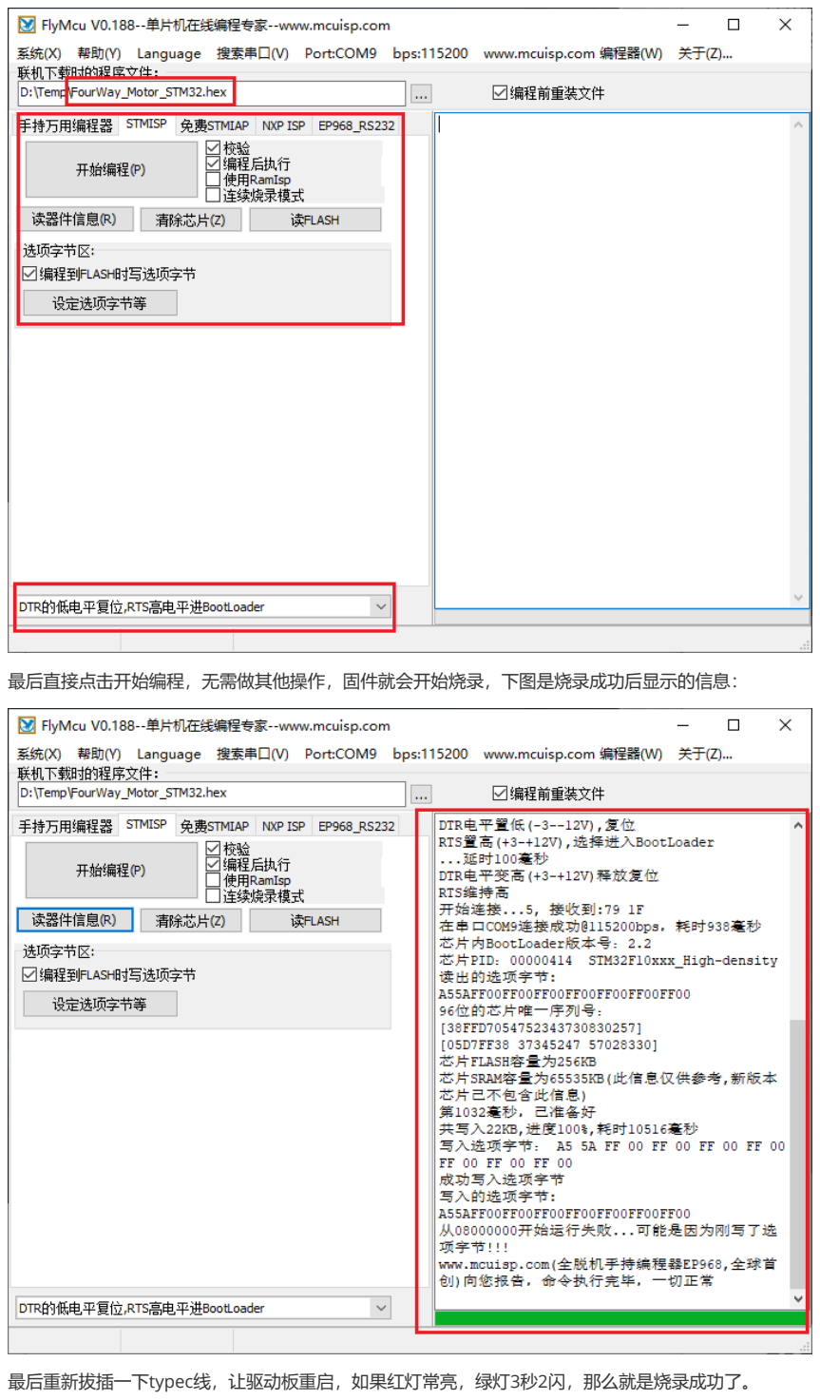
[picture p34: page 2]

最后直接点击开始编程，无需做其他操作，固件就会开始烧录，下图是烧录成功后显示的信息：

最后重新拔插一下typec线，让驱动板重启，如果红灯常亮，绿灯3秒2闪，那么就是烧录成功了。
