qyq11/opto-chess-robot-2027/03_hardware/01_机械/01_厂家资料/03_四路电机驱动/06_IIC寄存器.xlsx

IIC从机的地址为:0x26
寄存器地址 | R/W | 类型 | 值/长度 | 说明
0x01 | W | uint8_t | 1: 520电机 2：310电机 3: TT电机(带有编码器的) 4: TT电机(不带编码器) | 写入电机类型
0x02 | W | uint16_t | 0-3600 | 配置电机死区
0x03 | w | uint16_t | 0-65535 | 写入电机的脉冲线(磁环线数) 由参数表得出
0x04 | w | uint16_t | 0-65535 | 写入电机的减速比 由参数表得出
0x05 | w | float | 4个char字节 | 写入轮子的直径，单位为mm
0x06 | w | int16_t | -1000~1000 | 带编码器的速度控制 | 每个速度占2位 对于uint8_t来说 eg:m1电机速度200、m2电机速度为-200、M3电机速度为0、m4电机速度为500 即:[0x00 0xC8 0xFF 0x38 0x00 0x00 0x01 0xf4]
0x07 | w | int16_t | -3600~3600 | 控制pwm速度 | pwm的计算同上
0x10 | R | int16_t |  | 读取M1编码器实时脉冲数据-10ms | data = buf[0]<<8|buf[1]
0x11 | R | int16_t |  | 读取M2编码器实时脉冲数据-10ms | data = buf[0]<<8|buf[1]
0x12 | R | int16_t |  | 读取M3编码器实时脉冲数据-10ms | data = buf[0]<<8|buf[1]
0x13 | R | int16_t |  | 读取M4编码器实时脉冲数据-10ms | data = buf[0]<<8|buf[1]
0x20 | R | uint16_t | 2字节 | 读取M1电机编码器总的脉冲数据 | 高位 | 获取到的数据需要移位才能得到正确数据 高位代表:buf[0] buf[1] 低位代表:bf[0] bf[1] data = buf[0]<<24|buf[1]<<16|bf[0]<<8|bf[1]
0x21 | R | uint16_t | 2字节 | 读取M1电机编码器总的脉冲数据 | 低位
0x22 | R | uint16_t | 2字节 | 读取M2电机编码器总的脉冲数据 | 高位 | 获取到的数据需要移位才能得到正确数据 高位代表:buf[0] buf[1] 低位代表:bf[0] bf[1] data = buf[0]<<24|buf[1]<<16|bf[0]<<8|bf[1]
0x23 | R | uint16_t | 2字节 | 读取M2电机编码器总的脉冲数据 | 低位
0x24 | R | uint16_t | 2字节 | 读取M3电机编码器总的脉冲数据 | 高位 | 获取到的数据需要移位才能得到正确数据 高位代表:buf[0] buf[1] 低位代表:bf[0] bf[1] data = buf[0]<<24|buf[1]<<16|bf[0]<<8|bf[1]
0x25 | R | uint16_t | 2字节 | 读取M3电机编码器总的脉冲数据 | 低位
0x26 | R | uint16_t | 2字节 | 读取M4电机编码器总的脉冲数据 | 高位 | 获取到的数据需要移位才能得到正确数据 高位代表:buf[0] buf[1] 低位代表:bf[0] bf[1] data = buf[0]<<24|buf[1]<<16|bf[0]<<8|bf[1]
0x27 | R | uint16_t | 2字节 | 读取M4电机编码器总的脉冲数据 | 低位
