qyq11/opto-chess-robot-2027/03_hardware/01_机械/01_厂家资料/03_四路电机驱动/02_驱动尺寸.jpg

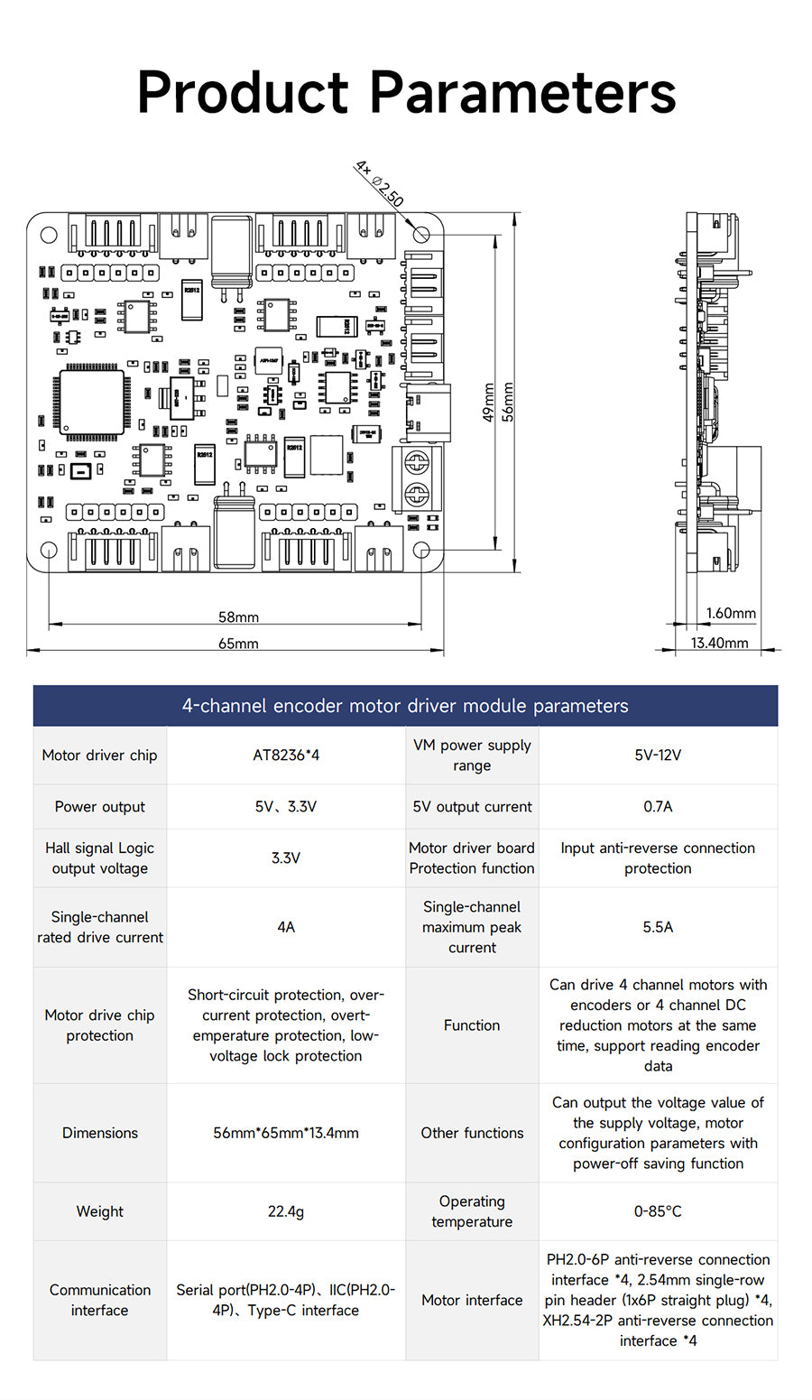
03_hardware/01_机械/01_厂家资料/03_四路电机驱动/02_驱动尺寸.jpg
