qyq11/opto-chess-robot-2027/03_hardware/01_机械/01_厂家资料/04_RK摄像头接口原理图.webp

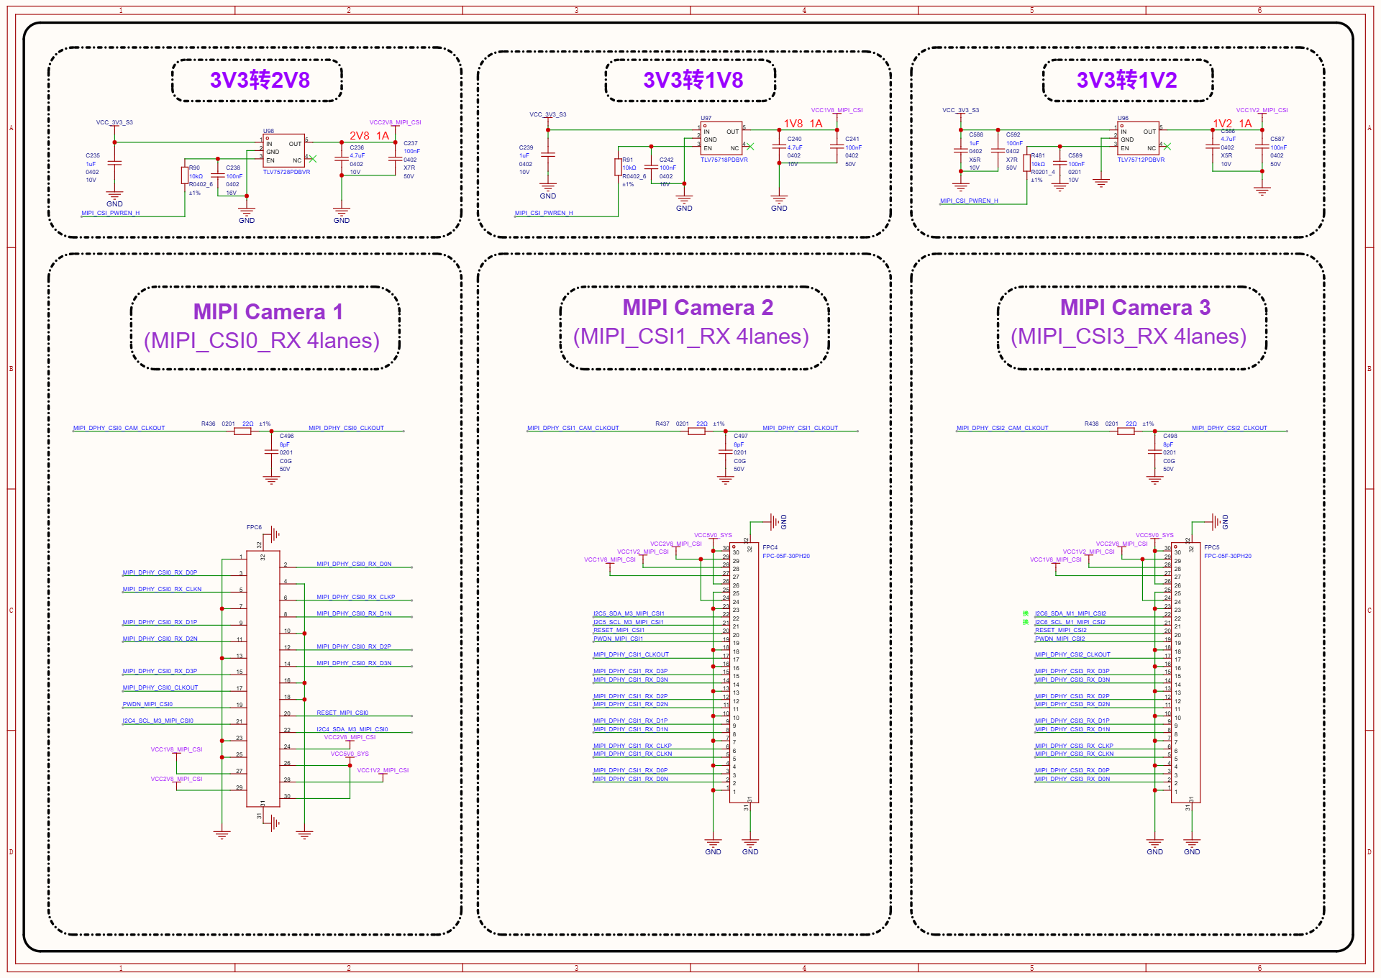
03_hardware/01_机械/01_厂家资料/04_RK摄像头接口原理图.webp
