qyq11/opto-chess-robot-2027/03_hardware/01_机械/01_厂家资料/05_亚博电源板尺寸.jpg

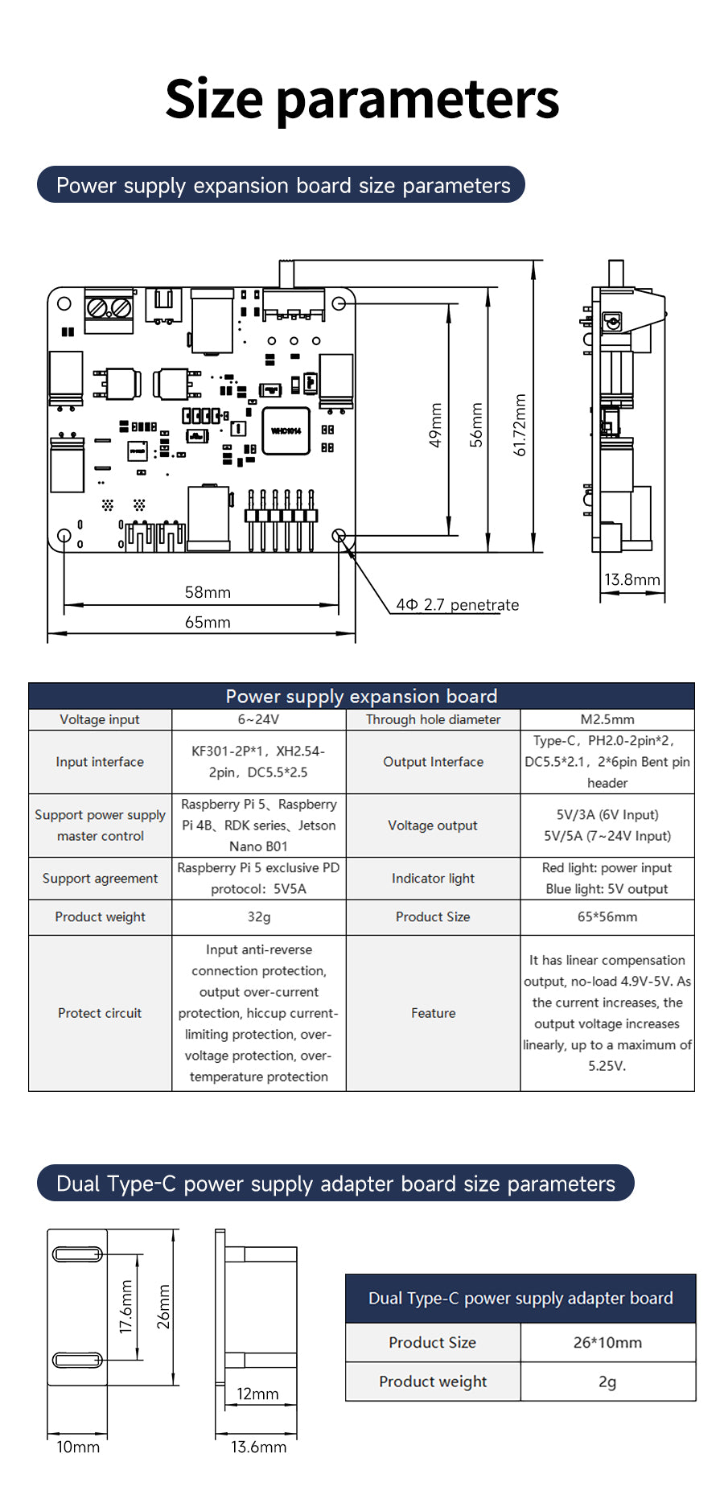
03_hardware/01_机械/01_厂家资料/05_亚博电源板尺寸.jpg
