qyq11/opto-chess-robot-2027/05_data/01_raw/02_xiangqi/20261023_xiangqi_input_02.jpg

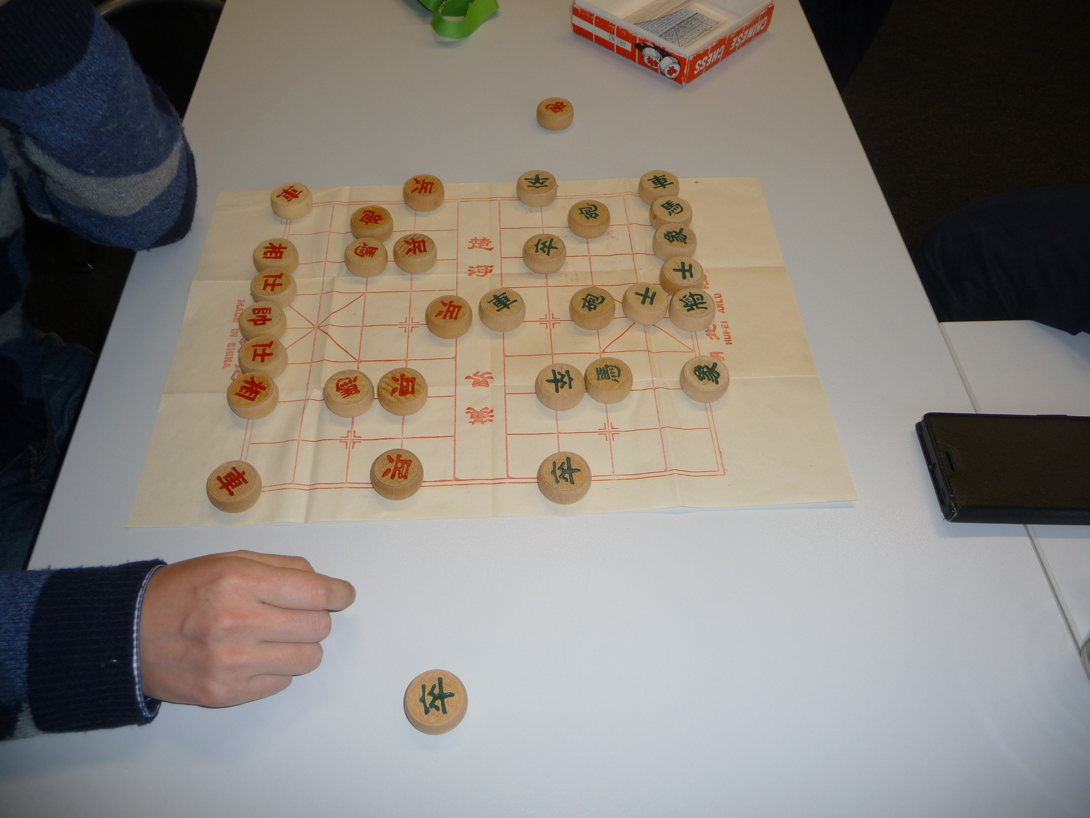
05_data/01_raw/02_xiangqi/20261023_xiangqi_input_02.jpg
