qyq11/opto-chess-robot-2027/05_data/01_raw/02_xiangqi/20261023_xiangqi_oblique_generated_01.png

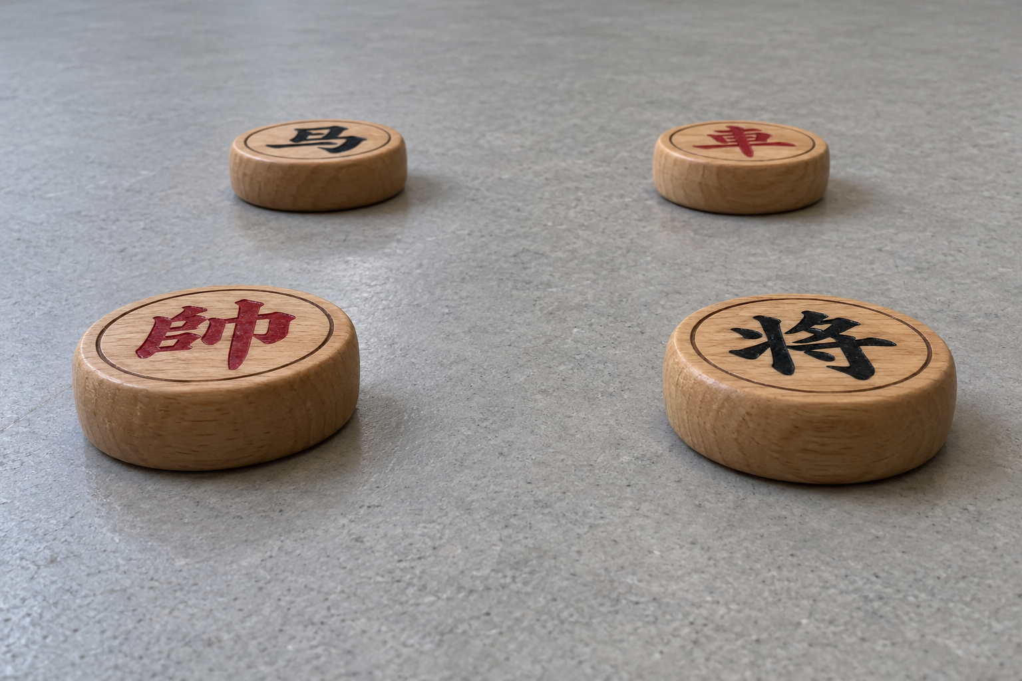
05_data/01_raw/02_xiangqi/20261023_xiangqi_oblique_generated_01.png
