qyq11/opto-chess-robot-2027/05_data/01_raw/03_procurement/20261024_wheeltec_wheel_specs_01.jpg

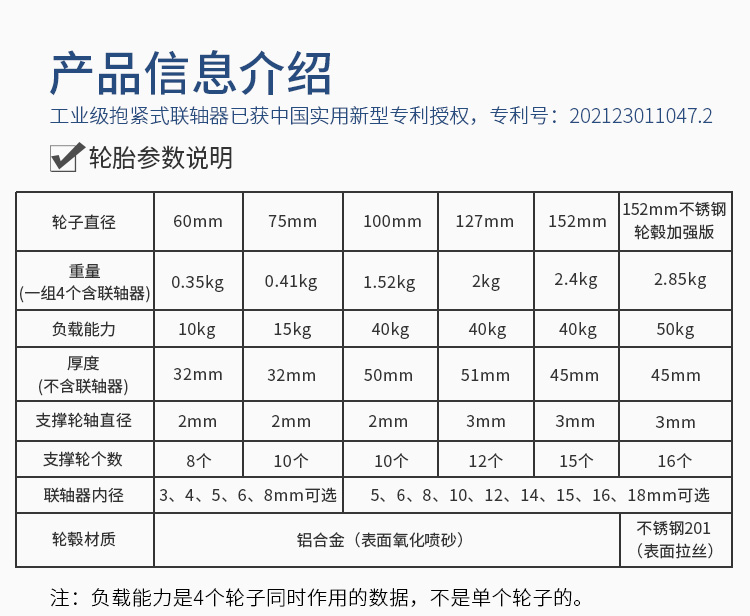
05_data/01_raw/03_procurement/20261024_wheeltec_wheel_specs_01.jpg
