qyq11/opto-chess-robot-2027/05_data/01_raw/03_procurement/20261025_yahboom_driver_power_kit_01.jpg

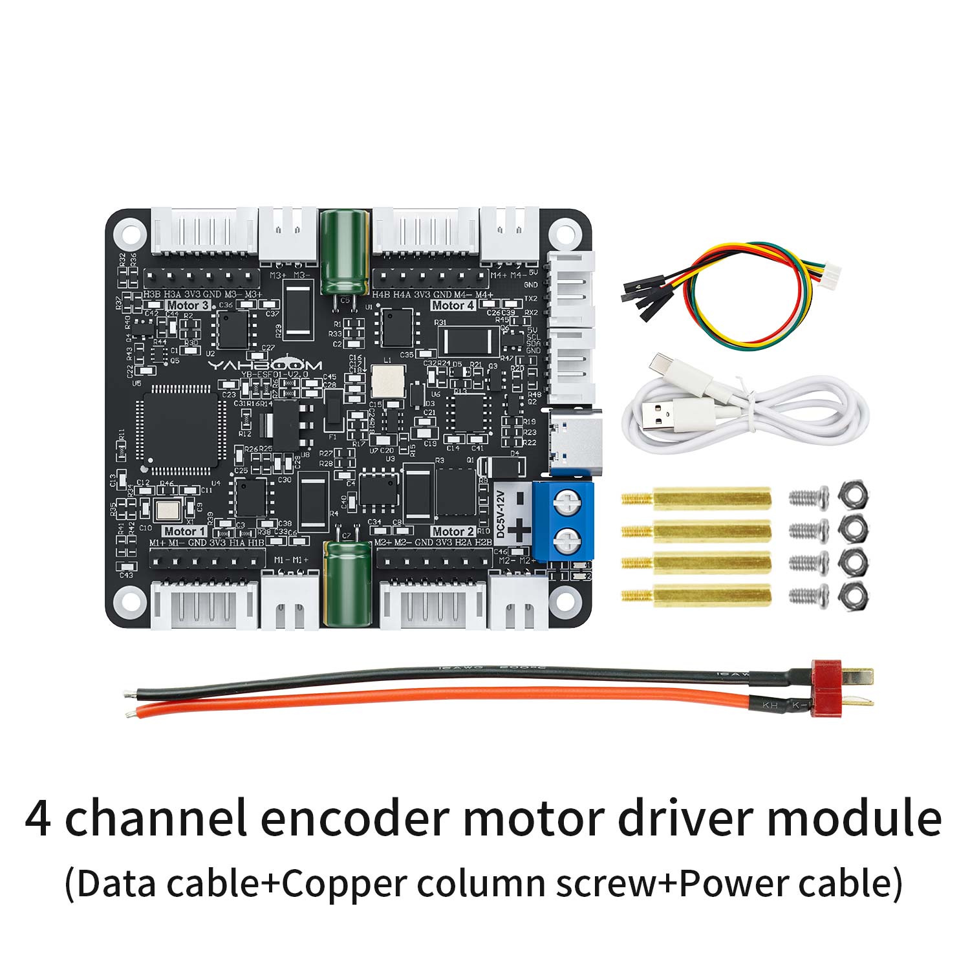
05_data/01_raw/03_procurement/20261025_yahboom_driver_power_kit_01.jpg
