qyq11/opto-chess-robot-2027/05_data/01_raw/03_procurement/20261025_yahboom_power_tplug_01.png

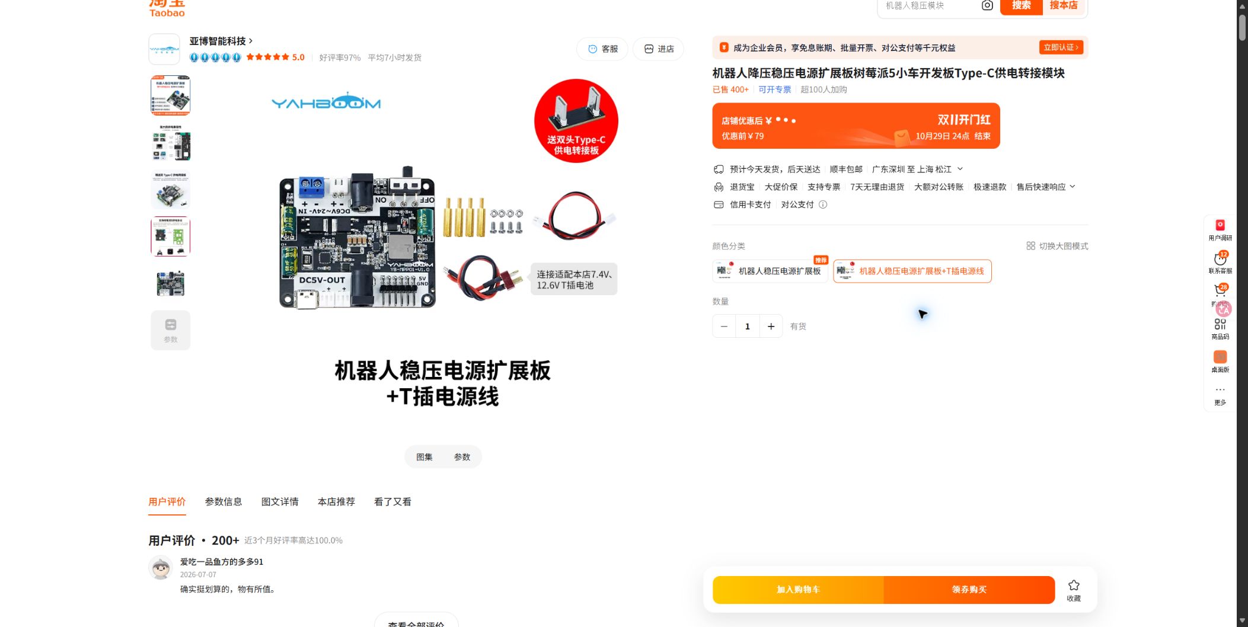
05_data/01_raw/03_procurement/20261025_yahboom_power_tplug_01.png
