qyq11/opto-chess-robot-2027/05_data/01_raw/04_hardware/20261030_power_connectors_marked_01.png

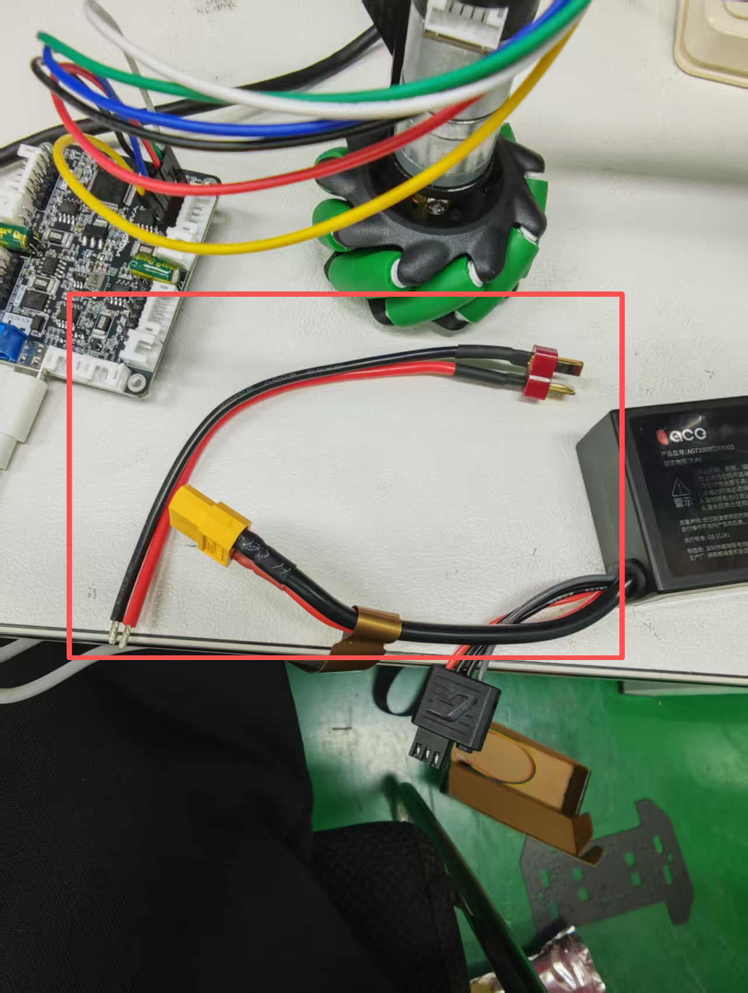
05_data/01_raw/04_hardware/20261030_power_connectors_marked_01.png
