qyq11/opto-chess-robot-2027/05_data/01_raw/04_hardware/20261030_yahboom_battery_2000_01.jpg

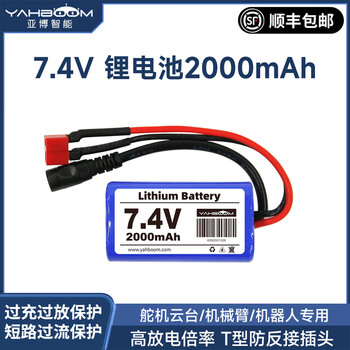
05_data/01_raw/04_hardware/20261030_yahboom_battery_2000_01.jpg
