qyq11/opto-chess-robot-2027/05_data/01_raw/04_hardware/20261103_camera_connection_01.jpg

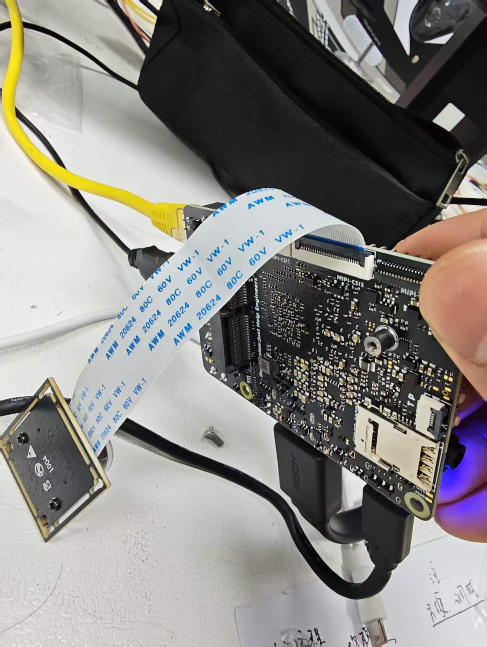
05_data/01_raw/04_hardware/20261103_camera_connection_01.jpg
