qyq11/opto-chess-robot-2027/05_data/01_raw/04_hardware/20261103_camera_poweroff_sequence_01.png

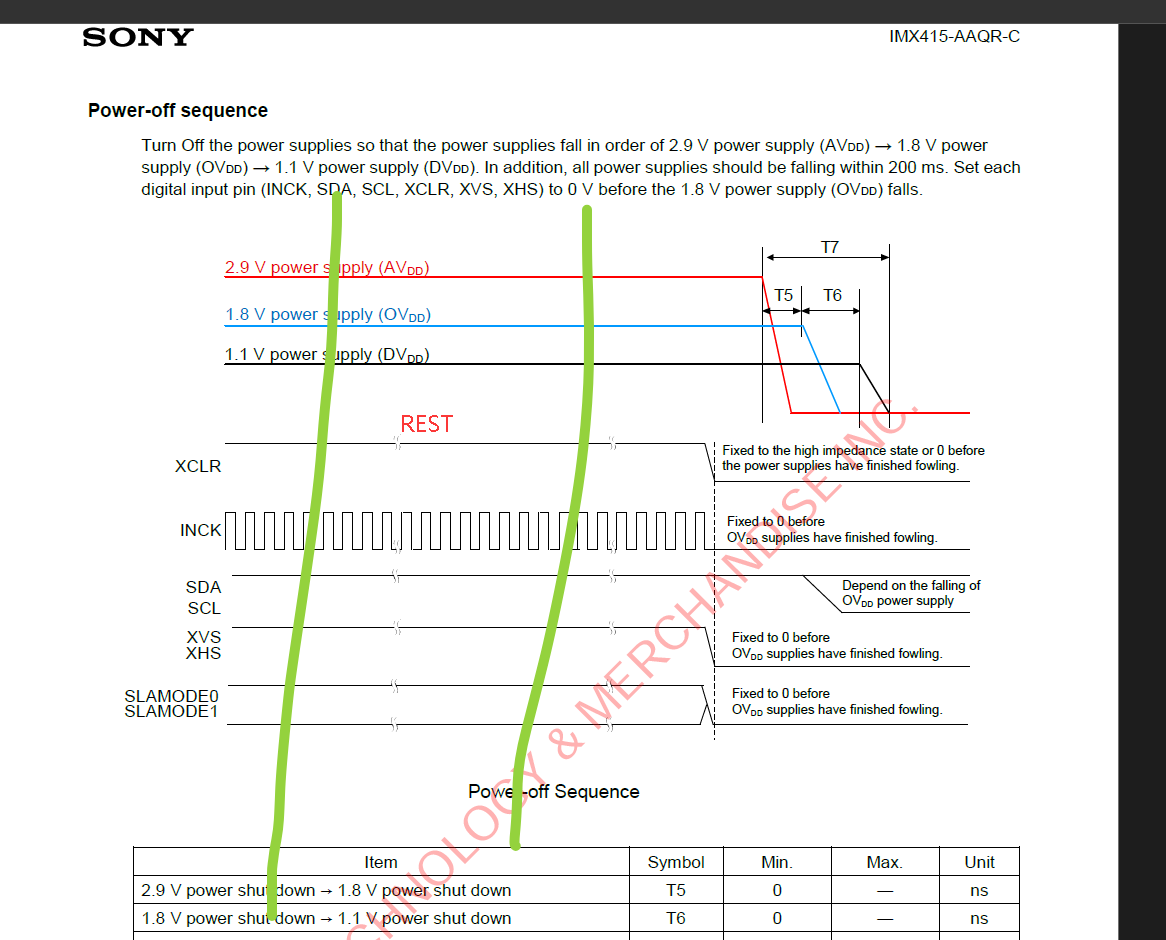
05_data/01_raw/04_hardware/20261103_camera_poweroff_sequence_01.png
