qyq11/opto-chess-robot-2027/05_data/03_results/04_mechanical/20261024_current_car_bottom.png

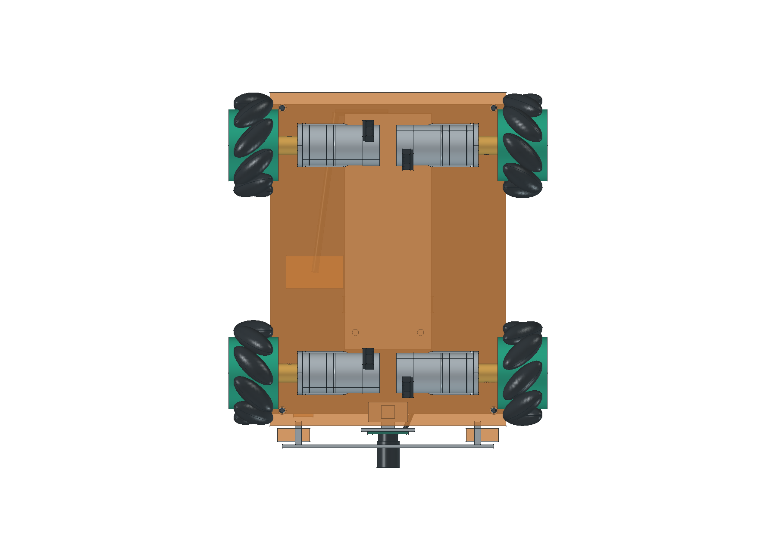
05_data/03_results/04_mechanical/20261024_current_car_bottom.png
