qyq11/opto-chess-robot-2027/05_data/03_results/04_mechanical/20261027_integrated_car_top.png

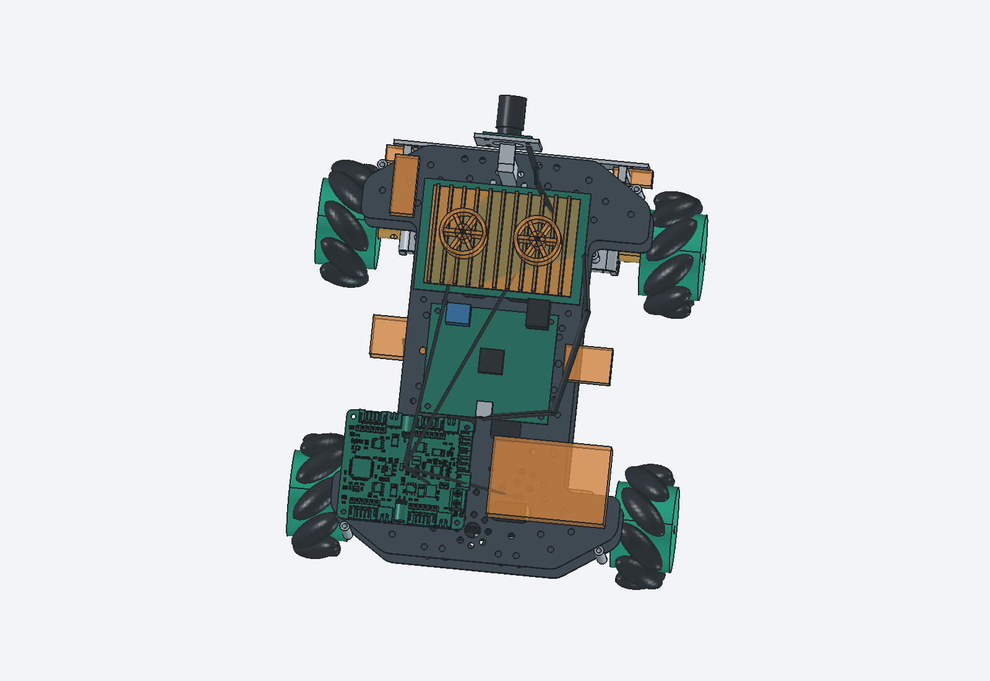
05_data/03_results/04_mechanical/20261027_integrated_car_top.png
