qyq11/opto-chess-robot-2027/05_data/03_results/04_mechanical/20261103_camera_mount_side.png

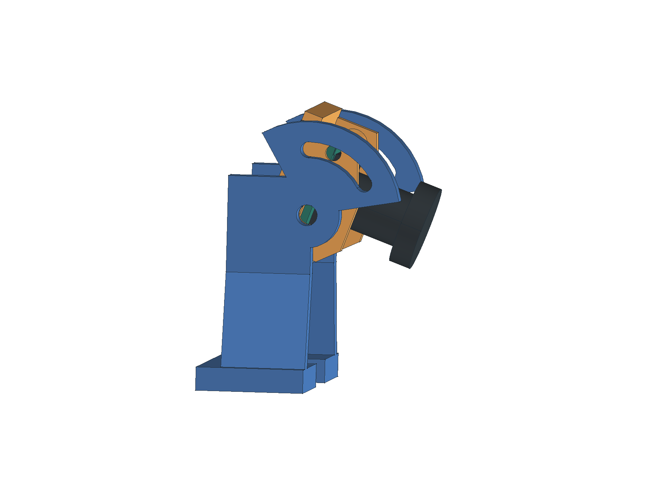
05_data/03_results/04_mechanical/20261103_camera_mount_side.png
