qyq11/opto-chess-robot-2027/05_data/01_raw/04_hardware/20261104_board_b_uart_inventory_01.txt

BOARD_SERIAL=8314b1e8ffd0321f
2026-11-04T12:08:07+08:00

[identity]
0eb94389-f120-42ad-9042-9c21d96a1481
LCKFB TaishanPi 3M RK3576 Board
Linux localhost 6.1.99-rt36-tspi #2 SMP PREEMPT_RT Fri Oct 30 21:07:55 CST 2026 aarch64 aarch64 aarch64 GNU/Linux
storagemedia=emmc androidboot.storagemedia=emmc androidboot.mode=normal  androidboot.verifiedbootstate=orange rw rootwait earlycon=uart8250,mmio32,0x2ad40000 console=ttyFIQ0 root=PARTUUID=614e0000-0000 rcupdate.rcu_expedited=1 rcu_nocbs=all #q-10/30/2026 androidboot.fwver=ddr-v1.09-2f85f4b2d4,bl31-v1.14,bl32-v1.05,uboot-3fcd713

[protected processes]
    PID                  STARTED STAT COMMAND
   5008 Tue Nov  3 16:47:35 2026 Sl   SN450_CPU3
5008 (SN450_CPU3) S 4342 4342 4342 0 -1 4194560 1508 186 5 0 252856 1283855 0 0 20 0 6 0 118180 486748160 2260 18446744073709551615 4194304 6982659 548824499168 0 0 0 0 4096 1056 0 0 0 17 3 0 0 0 0 0 7049216 7066080 853721088 548824501869 548824501892 548824501892 548824502241 0
/userdata/shared/ACA_V1.0OffLineD-500
ee8e1932f9a9f33d0bbffebfc9e161515dd79a53f50c78da274b04ef837d81ff  /proc/5008/exe
    PID                  STARTED STAT COMMAND
 669382 Tue Nov  3 22:18:20 2026 Sl+  sn100_shell
669382 (sn100_shell) S 669344 669336 669336 1031 669336 4194304 5753135 0 8 0 1020462 45473 0 0 20 0 19 0 2102645 2618159104 109506 18446744073709551615 367065235456 367075118416 548686207424 0 0 0 0 4100 671746 0 0 0 17 5 0 0 0 0 0 367075174608 367075268072 367147585536 548686210446 548686211077 548686211077 548686212991 0
/home/rkshare/programs/sn100_shell/releases/c7cbf438a3a034b25ae22accfaf48bacf0717174ce85bef2203ce8db143cb06e/sn100_shell
50d3f3b510772e717e456cc4e3e910060a82a6635b9d914f033e79f9ed6f0258  /proc/669382/exe
    PID                  STARTED STAT COMMAND
 139148 Tue Nov  3 18:49:06 2026 Sl   rkaiq_3A_server
139148 (rkaiq_3A_server) S 1 139143 139143 0 -1 4194304 13894 0 0 0 145169 172414 0 0 20 0 9 0 847289 445001728 13012 18446744073709551615 366807801856 366807821148 549205045296 0 0 0 0 4102 0 0 0 0 17 6 0 0 0 0 0 366807825288 366807826552 367502843904 549205049068 549205049093 549205049093 549205049311 0
/usr/bin/rkaiq_3A_server
bd7b443fd92bf853c71a1816f2ad8ea5ebeef88601b1fe1a8039f7ec321178c0  /proc/139148/exe
MainPID=0
ActiveState=inactive
SubState=dead

[UART nodes and device-tree mapping]
crw--w---- 1 root tty     253,  0 Nov  3 16:28 /dev/ttyFIQ0
crw-rw---- 1 root dialout   4, 67 Nov  3 16:27 /dev/ttyS3
crw-rw---- 1 root dialout   4, 68 Nov  3 16:27 /dev/ttyS4
crw-rw---- 1 root dialout   4, 70 Nov  3 16:28 /dev/ttyS6
crw-rw---- 1 root dialout   4, 71 Nov  3 16:27 /dev/ttyS7
crw-rw---- 1 root dialout   4, 72 Nov  3 16:27 /dev/ttyS8
crw-rw---- 1 root dialout   4, 73 Nov  3 16:27 /dev/ttyS9
ttyS3 => /sys/firmware/devicetree/base/serial@2ad60000
ttyS4 => /sys/firmware/devicetree/base/serial@2ad70000
ttyS6 => /sys/firmware/devicetree/base/serial@2ad90000
ttyS7 => /sys/firmware/devicetree/base/serial@2ada0000
ttyS8 => /sys/firmware/devicetree/base/serial@2adb0000
ttyS9 => /sys/firmware/devicetree/base/serial@2adc0000
serial0=/serial@2ad40000
serial1=/serial@27310000
serial10=/serial@2afc0000
serial11=/serial@2afd0000
serial2=/serial@2ad50000
serial3=/serial@2ad60000
serial4=/serial@2ad70000
serial5=/serial@2ad80000
serial6=/serial@2ad90000
serial7=/serial@2ada0000
serial8=/serial@2adb0000
serial9=/serial@2adc0000
serinfo:1.0 driver revision:
3: uart:16550A mmio:0x2AD60000 irq:46 tx:0 rx:0
4: uart:16550A mmio:0x2AD70000 irq:47 tx:0 rx:0
6: uart:16550A mmio:0x2AD90000 irq:48 tx:73888 rx:3263 RTS|CTS|DTR
7: uart:16550A mmio:0x2ADA0000 irq:49 tx:0 rx:0
8: uart:16550A mmio:0x2ADB0000 irq:50 tx:0 rx:0
9: uart:16550A mmio:0x2ADC0000 irq:51 tx:0 rx:0

[enabled overlays]
# auto-generated by ovtree — do not edit
overlays=tspi-3m-can0-m2.dtbo tspi-3m-uart-header-five.dtbo lckfb-imx415-i2c4-1a.dtbo
已启用的设备树插件：
  ● CAN0（40针7脚接收、11脚发送） (tspi-3m-can0-m2.dtbo)
  ● 40针排针五组串口 (tspi-3m-uart-header-five.dtbo)
  ● IMX415相机地址修正 (lckfb-imx415-i2c4-1a.dtbo)

配置文件: /boot/overlays/.ubootenv

[serial login services]
  UNIT                         LOAD   ACTIVE SUB     DESCRIPTION
  getty@tty1.service           loaded active running Getty on tty1
  serial-getty@ttyFIQ0.service loaded active running Serial Getty on ttyFIQ0

Legend: LOAD   → Reflects whether the unit definition was properly loaded.
        ACTIVE → The high-level unit activation state, i.e. generalization of SUB.
        SUB    → The low-level unit activation state, values depend on unit type.

2 loaded units listed.
To show all installed unit files use 'systemctl list-unit-files'.

[open serial file descriptors; no device opened by this probe]
pid=1780 fd=3 target=/dev/ttyS6 comm=brcm_patchram_p
pid=1909 fd=0 target=/dev/ttyFIQ0 comm=agetty
pid=1909 fd=1 target=/dev/ttyFIQ0 comm=agetty
pid=1909 fd=2 target=/dev/ttyFIQ0 comm=agetty

[pinctrl current UART owners]
FILE=/sys/kernel/debug/pinctrl/pinctrl-rockchip-pinctrl/pinmux-pins
pin 28 (gpio0-28): fiq-debugger (GPIO UNCLAIMED) function uart0 group uart0m0-xfer
pin 29 (gpio0-29): fiq-debugger (GPIO UNCLAIMED) function uart0 group uart0m0-xfer
pin 70 (gpio2-6): 2adb0000.serial (GPIO UNCLAIMED) function uart8 group uart8m1-xfer
pin 71 (gpio2-7): 2adb0000.serial (GPIO UNCLAIMED) function uart8 group uart8m1-xfer
pin 78 (gpio2-14): 2ada0000.serial (GPIO UNCLAIMED) function uart7 group uart7m0-xfer
pin 79 (gpio2-15): 2ada0000.serial (GPIO UNCLAIMED) function uart7 group uart7m0-xfer
pin 80 (gpio2-16): 2adc0000.serial (GPIO UNCLAIMED) function uart9 group uart9m0-xfer
pin 81 (gpio2-17): 2adc0000.serial (GPIO UNCLAIMED) function uart9 group uart9m0-xfer
pin 88 (gpio2-24): 2ad70000.serial (GPIO UNCLAIMED) function uart4 group uart4m0-xfer
pin 89 (gpio2-25): 2ad70000.serial (GPIO UNCLAIMED) function uart4 group uart4m0-xfer
pin 90 (gpio2-26): 2ad90000.serial (GPIO UNCLAIMED) function uart6 group uart6m1-xfer
pin 91 (gpio2-27): 2ad90000.serial (GPIO UNCLAIMED) function uart6 group uart6m1-xfer
pin 92 (gpio2-28): wireless-bluetooth gpio2:92 function uart6 group uart6m1-rtsn
pin 93 (gpio2-29): 2ad90000.serial (GPIO UNCLAIMED) function uart6 group uart6m1-ctsn
pin 96 (gpio3-0): 2ad60000.serial (GPIO UNCLAIMED) function uart3 group uart3m0-xfer
pin 97 (gpio3-1): 2ad60000.serial (GPIO UNCLAIMED) function uart3 group uart3m0-xfer
FILE=/sys/kernel/debug/pinctrl/rk806-pinctrl.1.auto-rk806-pinctrl/pinmux-pins

[read-only tools]
/usr/bin/gcc

[protected processes after probe]
    PID                  STARTED STAT COMMAND
   5008 Tue Nov  3 16:47:35 2026 Sl   SN450_CPU3
 139148 Tue Nov  3 18:49:06 2026 Sl   rkaiq_3A_server
 669382 Tue Nov  3 22:18:20 2026 Sl+  sn100_shell
MainPID=0
ActiveState=inactive
SubState=dead
