qyq11/opto-chess-robot-2027/03_hardware/02_采购/03_20261024_京东_订单导出_3661477012483787.xlsx

订单号 | 订单时间 | 订单状态 | 店铺名称 | 商品编号 | 商品名称 | 商品链接 | 数量 | 实付金额 | 支付方式 | 收货人姓名 | 收货人电话 | 收货地址 | 物流公司 | 物流单号
3661477012486530 | 2026-10-24 23:39:56 | 正在出库 | 格氏旗舰店 | 10051546999619 | 格氏（ACE）格式1800/2200/4300/5200/7200/7300mAh RC遥控车模2S3S锂电池50C 7200mAh-50C-7.4V-2S硬壳|满电8.4V 格氏耐用经典款-XT60插头 | //item.jd.com/10051546999619.html?pcdk=Ki-vfB9t1Nx5lEf6mieNJdWyyD4GmcHk78VoQ-AGSqU7i_Olv__D_tSXe1CqCpYR.qliT.8Idm | 1 | 162.00 | 在线支付 | 邱宇强 | 151****3257 | 上海松江区永丰街道国贸·凤凰原-3号
3661477000956457 | 2026-10-24 23:39:56 | 正在出库 | 亚博智能官方旗舰店 | 10098108278160 | 亚博智能 麦克纳姆轮 万全向轮无人小车DIY底盘520 TT电机80mm轮胎联轴器 65mm尼龙款麦轮*4+3mm六角联轴器 | //item.jd.com/10098108278160.html?pcdk=Ki-vfB9t1Nx5lEf6mieNJT_jU3wrh2tjaMVQc3nf8Gv9ivBGErwhLwjoQpWcww7O.qliT.8Idm | 1 | 363.80 | 在线支付 | 邱宇强 | 151****3257 | 上海松江区永丰街道国贸·凤凰原-3号
 |  |  |  | 10069318711256 | 亚博智能310编码器直流减速电机马达AB相 霍尔码盘智能车底盘电子设计竞赛 7.4V 编码器减速电机+支架 | //item.jd.com/10069318711256.html?pcdk=Ki-vfB9t1Nx5lEf6mieNJXkg2_avQWDvX_qqVr3ZuhlKNUHdEknfkKs5r4HwA4R9.qliT.8Idm | 4
 |  |  |  | 10140357947374 | 亚博智能四路编码器电机驱动板4路控制板模块机器人无人小车AT8236电子设计竞赛 四路编码器电机驱动模块+铜柱+数据线+电源线 | //item.jd.com/10140357947374.html?pcdk=Ki-vfB9t1Nx5lEf6mieNJcsLf6Q_plZff1TQ_Vt3KHfh-5wbmVIOEDbo3Q6ThmMP.qliT.8Idm | 1
