qyq11/opto-chess-robot-2027/01_docs/05_resources/01_资料清单.md

---
slug: /resources/catalog
sidebar_position: 1
---

# 关键资料清单

更新日期：2026-11-07。只保留当前比赛与开发任务需要的资料；来源入口见[资料来源](./02_官网下载链接.md)。

## 当前入口

- [项目使用说明](./03_项目使用说明.md)：获取项目、查找文件、打开模型、运行示例及启动文档网站。
- [整机方案](../02_design/01_整机方案.md)：唯一实施主线、系统连接、开放研究范围与变更方式。
- [采购清单](../../03_hardware/01_硬件清单.md)：单车完整部件、商品分类、数量、价格与配套条件；零部件淘宝/京东优先，主控为立创官方入口。
- [RK3576主控方案](../02_design/02_RK主控评估.md)：已确定泰山派3M RK3576完整板、4GB/64GB，区分官方资料核查和待完成的板端验收。
- [开发计划](../01_plans/01_开发计划.md)：全部任务状态与完成标准。
- [2026-10-23 会议纪要](../04_meetings/01_20261023_会议纪要.md)：保留历史决定，注明 2026-10-24 后续调整。

## 核心原始资料与已有成果

| 资料 | 入口 | 适用范围 |
| --- | --- | --- |
| 第十五届赛题要求 | [3 页 PDF 原件](../../04_references/01_official/01_第十五届赛题要求.pdf) | 官方规则依据，后续修订仍需核对 |
| 泰山派3M规格书 | [官方商城原件](../../04_references/04_datasheets/01_泰山派3M_RK3576_规格书.pdf) | 当前RK3576 4+64主板；85×57mm外形、5V/4A输入，孔位/厚度/净重仍待核；来源与SHA256见[登记](../../03_hardware/01_机械/01_厂家资料/sources.json)的S05 |
| IMX415商家模组图纸 | [1页PDF原件](../../04_references/04_datasheets/02_IMX415_120度模组图纸.pdf) | 尺寸与30针引脚参考，文件名标120度；本次实购100度M12版本，一致性待核。原名、来源与文件指纹见[采购来源](../../05_data/01_raw/03_procurement/sources.json)，差异与下一步见[已购相机](../../03_hardware/01_硬件清单.md#已购相机与商家图纸) |
| IMX415芯片数据手册 | [101页英文原件](../../04_references/04_datasheets/03_IMX415-AAQR-C_Datasheet.pdf) | IMX415-AAQR-C传感器芯片参数参考，不代替相机模组的外形和30针排线定义。用户提供，原名与文件指纹见[来源登记](../../03_hardware/01_机械/01_厂家资料/sources.json)的S13 |
| MobileNetV3 | [论文](../../04_references/02_papers/01_MobileNetV3_2019.pdf) | 轻量分类参考，不是本项目已训练模型 |
| 透视变换 | [研究记录](../03_records/01_20261023_透视变换.md) | 原图、源码、几何检查与局限 |
| 象棋识别 | [研究记录](../03_records/02_20261023_象棋识别.md) | 真实照片/生成输入、模型许可、人工真值及预测 |
| 推送几何 | [概念图](../../05_data/03_results/01_design/01_推送几何.png) | 推送与避障的通用解释，非实车验证 |

算法源码、原图、人工标注、生成来源、模型/许可和正式结果仍完整保留。切换 RK 架构不会让这些研究成果失效。

## T5X四驱底板资料

2026-10-27用户补充轮趣T5X资料包，并确认本车只使用其中的底板。已从厂家整车STEP中提取147×210×1.5mm板件，替换原有改装模型的上下两层板；原来的麦轮、310电机、电控与布局继续使用。

- [独立底板STEP](../../03_hardware/01_机械/01_厂家资料/01_T5X四驱/05_四驱底板.step)：可直接用于后续装配，保留原孔槽，未增删孔、未缩放。
- [厂家整车STEP原件](../../03_hardware/01_机械/01_厂家资料/01_T5X四驱/04_厂家整车原件.stp)：只作为板件提取来源，里面的其他部件未用于本车。
- [底板孔位说明](../../03_hardware/01_机械/01_厂家资料/01_T5X四驱/01_底板孔位说明.pdf)、[孔位图PDF](../../03_hardware/01_机械/01_厂家资料/01_T5X四驱/02_底板孔位图.pdf)、[孔位图DWG](../../03_hardware/01_机械/01_厂家资料/01_T5X四驱/03_底板孔位图.dwg)：便于识别原有孔槽用途；不代表310支架可以免转接安装。
- [厂家版权声明](../../03_hardware/01_机械/01_厂家资料/01_T5X四驱/06_版权声明.pdf)、[来源及文件指纹](../../03_hardware/01_机械/01_厂家资料/sources.json)：登记资料包原名、归档路径和SHA-256（用于比较文件内容是否一致）。本次未在线下载或核实版本。

12份两驱专属图纸、模型和视频已按用户要求删除；14份未采用的参考程序、厂家原配整车视频及附件资料仍在项目 `temp/t5x-intake/未采用原件/` 留存。保留的19份原件均与归档前文件指纹一致；不把厂家参考程序作为本车下位机工程。当前结果仅是CAD资料与电脑几何检查，实购板批次、安装和承力仍需到货核对；2026-10-28已在上层加工设计中增加杆通道，解除模型相交；孔位、刚度和实际安装仍待验收。

## 亚博310与新版四路驱动资料

2026-10-27用户补充资料包。与当前模型对应的10份完整核心原件放在 `03_hardware/01_机械/01_厂家资料/02_310电机/` 和 `03_hardware/01_机械/01_厂家资料/03_四路电机驱动/`，原始名称、归档路径及文件指纹见[来源S11](../../03_hardware/01_机械/01_厂家资料/sources.json)。

| 对应模型 | 正式资料与采用情况 |
| --- | --- |
| 3mm六角联轴器 | [厂家STEP](../../03_hardware/01_机械/01_厂家资料/02_310电机/03_3mm六角联轴器.STEP)：已替换零件库与整车中的简化联轴器，轴线和位置保留 |
| 310电机、四孔支架 | [电机STEP](../../03_hardware/01_机械/01_厂家资料/02_310电机/01_310电机.STEP)、[四孔支架STEP](../../03_hardware/01_机械/01_厂家资料/02_310电机/02_四孔支架.STEP)、[支架图纸](../../03_hardware/01_机械/01_厂家资料/02_310电机/06_四孔支架尺寸.pdf)、[电机参数DOCX](../../03_hardware/01_机械/01_厂家资料/02_310电机/04_电机参数.docx)：新增CAD与现有原件完全相同，沿用原件 |
| 四路电机驱动 | [V2厂家CAD](../../03_hardware/01_机械/01_厂家资料/03_四路电机驱动/01_四路驱动_V2.STEP)、[简介](../../03_hardware/01_机械/01_厂家资料/03_四路电机驱动/03_驱动简介.pdf)、[控制指令](../../03_hardware/01_机械/01_厂家资料/03_四路电机驱动/04_控制指令.pdf)：已作为曲面参考接入；原件不是封闭实体 |
| 驱动板通信资料 | [串口寄存器](../../03_hardware/01_机械/01_厂家资料/03_四路电机驱动/05_串口寄存器.xlsx)、[IIC寄存器](../../03_hardware/01_机械/01_厂家资料/03_四路电机驱动/06_IIC寄存器.xlsx)、[STM32串口示例](../../03_hardware/01_机械/01_厂家资料/03_四路电机驱动/07_STM32串口示例.pdf)、[STM32 IIC示例](../../03_hardware/01_机械/01_厂家资料/03_四路电机驱动/08_STM32_IIC示例.pdf)、[电机与驱动用法](../../03_hardware/01_机械/01_厂家资料/03_四路电机驱动/09_电机与驱动用法.pdf) |

2026-10-28正式资料已分入“02_310电机”和“03_四路电机驱动”。两个完整原包共22,115个文件移入temp/yahboom-intake下的“310电机完整原包”和“四路驱动完整原包”，前后指纹逐份一致，未删除原件。48mm普通轮、两孔支架、旧驱动和其他平台教程继续留在原包，不作为当前实购配置。

### 四路驱动补充原件

- [固件更新说明](../../03_hardware/01_机械/01_厂家资料/03_四路电机驱动/10_固件更新说明.pdf)：厂家操作依据，本车未更新固件。
- [厂家固件](../../03_hardware/01_机械/01_厂家资料/03_四路电机驱动/11_厂家固件.hex)：实物版本匹配后使用，本车未烧写。
- [STM32完整串口工程](../../03_hardware/01_机械/01_厂家资料/03_四路电机驱动/12_STM32串口工程.zip)：保留完整参考工程，不当作本车F407程序验收。
- [厂家串口助手UartAssist 5.0.3](../../03_hardware/01_机械/01_厂家资料/03_四路电机驱动/13_UartAssist_5.0.3.exe)、[电脑串口调试教程](../../03_hardware/01_机械/01_厂家资料/03_四路电机驱动/14_PC串口调试.pdf)：2026-10-30从用户原包提取，正式文件与原包内容一致；来源与文件指纹见同一份`sources.json`中的`pc_uart_debug_import`。本车使用65mm轮，不照抄厂家教程的48mm轮径。操作见[电脑先调试](../02_design/05_底盘串口接线与测试.md#电脑先调试)。

对应模型：电机P06、四孔支架P07、联轴器P05和驱动P08；模型对象的来源属性和生成程序均指向上述正式文件。[当前补孔与固定设计](../../03_hardware/01_机械/01_建模规格.md#补孔和固定方式)另行维护，厂家原件不改写。

## 外部培训参考

用户于 2026-10-24 说明下列材料由他人制作，有参考价值，但不要求照其思路执行。三份原件从临时目录归档至 `04_references/03_training/`，仅重命名，字节与 SHA-256 保持不变；作者、授权范围及原始外部来源未另行核实。

| 材料 | 原件 | 阅读定位 |
| --- | --- | --- |
| 90 分钟本科生入门培训 | [PPTX](../../04_references/03_training/01_本科生入门培训.pptx) | 学习任务、接口及系统链路参考 |
| 培训阶段性方案 | [PDF](../../04_references/03_training/02_阶段性方案.pdf) | 分阶段交付和验收方式参考 |
| 学生辅助讲义 | [PDF](../../04_references/03_training/03_学生辅助讲义.pdf) | 基础知识和实验思路参考 |

原文件名、归档路径、哈希与来源说明见[来源元数据](../../04_references/03_training/04_来源.json)。材料中的硬件候选、教学周期、程序语言和指标均不自动成为项目要求；规则以官方文件为准，项目决策以当前整机方案和用户后续要求为准。可在同一系统主线内提出更发散的算法、机构与策略想法，并通过实验筛选。

## 本次清理范围

2026-10-24 停止原并列整机候选，删除旧候选方案文档、树莓派/差速架构图，以及只服务于已停路线的树莓派手册、力反馈和 SLAM 论文/标定下载副本。保留通用推送几何、轻量分类论文与全部算法研究证据；不将原始培训材料作为过期方案删除。

历史整理脚本、重复原图、候选预览、下载缓存与旧复核输出从 `temp/` 清理；正在使用的算法依赖、网站运行目录与有价值的作图源脚本按需保留。正式资料不依赖临时副本才能打开。

2026-10-24主控最终统一泰山派3M RK3576 4+64；合并重复购买清单，删除已淘汰主控/电机的网页缓存、旧覆盖脚本、可重建预览、旧自动备份和ROCK4D尺寸参考。用户STEP原件、有效FreeCAD工程、正式成果、算法与网站运行环境继续保留。

2026-10-25提交前再次核对正式资料和来源哈希，清理旧生成模型与一次性中间文件；7份旧候选唯一用户CAD原件保留供用户自行处理。当前[推送几何绘图源](../../05_data/03_results/01_design/draw_pushing.py)、系统图draw.io及模型源码均在正式目录，详见[整理记录](../03_records/03_20261024_机械装配验证.md#旧成果清理)。
