qyq11/opto-chess-robot-2027/03_hardware/02_采购/01_采购台账.xlsx

Sheet: 订单汇总
采购台账 · 订单汇总
更新日期：2026-10-30。5笔订单、8项商品。
已付总额（元） | ¥1660.68 |  | 订单数 | 5
已收发票4张，合计1443.50元。
订单号 | 下单日期 | 供应商 | 商品合计 （元，含税） | 运费 （元） | 优惠 （元） | 其他费用 （元） | 应付合计 （元） | 已付金额 （元） | 付款状态 | 到货状态 | 验收状态 | 发票状态 | 原始凭证 | 付款凭证 | 发票链接 | 商品未税金额 （元） | 商品税额 （元） | 应付减已付 （元） | 备注
SO26102424311 | 2026-10-24T00:00:00.000Z | 深圳市立创电子商务有限公司 （立创商城） | ¥928.00 | ¥8.00 | ¥0.00 | ¥0.00 | ¥936.00 | ¥936.00 | 已付款 | 待确认 | 待验收 | 已取得 | 打开合同 | 打开订单截图 | 打开发票 | ¥821.24 | ¥106.76 | ¥0.00 | 支付宝支付；下单时间22:59:40。 截图发货时间、快递单号为空。
3661477000956457 | 2026-10-24T00:00:00.000Z | 亚博智能官方旗舰店 麦轮1套×109.00元 电机4套×49.90元 驱动1套×55.20元 | ¥363.80 | 未单列 | 未单列 | 未单列 | 未单列 | ¥363.80 | 已付款 | 正在出库 | 待验收 | 已取得 | 打开订单截图 | 打开订单截图 | 打开发票 | ¥321.95 | ¥41.85 | 未单列 | 发票未税单价： 麦轮＋联轴器96.46元／套 310电机＋支架44.16元／套 四路驱动48.85元／套 含税成交单价见商家栏与商品明细。
5127831576100359305 | 2026-10-24T00:00:00.000Z | wheeltec旗舰店（轮趣） | ¥80.00 | ¥0.00 | 未单列 | 未单列 | 未单列 | ¥80.00 | 已付款 | 待发货 | 待验收 | 已取得 | 打开订单详情 | 打开订单详情 | 打开发票 | ¥70.80 | ¥9.20 | 未单列 | 支付宝支付，23:57:10。四驱加高板2套×40元，实付80元。 2026-10-30发票26442000012481893826已归档；未税70.80元、税9.20元。
5127385935119112530 | 2026-10-25T00:00:00.000Z | 亚博智能科技 | ¥75.00 | ¥0.00 | ¥11.30 | 未单列 | ¥63.70 | ¥63.70 | 已付款 | 待发货 | 待验收 | 已取得 | 打开订单详情 | 打开订单详情 | 打开发票 | ¥56.37 | ¥7.33 | ¥0.00 | 支付宝支付00:21:47；下单00:21:45。 折前75.00；优惠11.30；实付63.70元。 2026-10-30发票已归档；未税56.37元、税7.33元。
5127836868022085702 | 2026-10-30T00:00:00.000Z | 摄像头生产厂家 | ¥208.18 | ¥9.00 | 未单列 | 未单列 | ¥217.18 | ¥217.18 | 已付款 | 待发货 | 待验收 | 待取得 | 打开订单截图 | 打开订单截图 | 待补 | 待核 | 待核 | ¥0.00 | 支付宝支付21:30:23；下单21:28:56。 100° M12、30针MIPI，1个208.18元＋运费9元。 商品金额为页面成交金额，税率未单列。 100°方向、排线、支架与RK适配待核；未到货、未采集。

Sheet: 采购明细
采购台账 · 采购明细
采购商品、数量及成交单价。
金额来源：合同第1页 | 打开合同 |  | 付款来源：用户提供的订单截图 | 打开订单截图
单价与商品小计为含税成交金额。
订单号 | 凭证序号 | 商品名称 | 型号／规格 | 商品编号 | 数量 | 单位 | 成交单价 （元，含税） | 商品小计 （元，含税） | 商品链接 | 类别 | 采购日期
SO26102424311 | 1 | 立创·泰山派3M-RK3576开发板 散热风扇套件（盒装） | LCKFB-TSPI3M-COOLING-FAN-KIT | C55160086 | 1 | 套 | ¥29.00 | ¥29.00 | 打开商品 (https://item.szlcsc.com/58921706.html) | 主控散热 | 2026-10-24T00:00:00.000Z
SO26102424311 | 2 | 立创·泰山派开发板3M 4G+64G版本（袋装） | LCKFB-TSPI3M-RK3576-4G-64G | C54110287 | 1 | 块 | ¥899.00 | ¥899.00 | 打开商品 (https://item.szlcsc.com/57330947.html) | 主控 | 2026-10-24T00:00:00.000Z
3661477000956457 | 1 | 亚博65mm尼龙麦轮＋联轴器 | 65mm尼龙款麦轮*4+3mm六角联轴器 | 10098108278160 | 1 | 套 | ¥109.00 | ¥109.00 | 打开商品 (https://item.jd.com/10098108278160.html) | 轮系 | 2026-10-24T00:00:00.000Z
3661477000956457 | 2 | 亚博310编码器减速电机＋支架 | 7.4V 编码器减速电机+支架 MD310Z20_7.4V，3mm D轴 | 10069318711256 | 4 | 套 | ¥49.90 | ¥199.60 | 打开商品 (https://item.jd.com/10069318711256.html) | 电机 | 2026-10-24T00:00:00.000Z
3661477000956457 | 3 | 亚博四路编码器电机驱动模块 | 四路编码器电机驱动模块+铜柱+数据线+电源线 | 10140357947374 | 1 | 套 | ¥55.20 | ¥55.20 | 打开商品 (https://item.jd.com/10140357947374.html) | 驱动 | 2026-10-24T00:00:00.000Z
5127831576100359305 | 1 | T5X四驱碳纤维加高板 | T5X碳纤维高性能四驱小车底盘加高板 【多仓发货 大部分区域次日达】 | 671414115083 | 2 | 套 | ¥40.00 | ¥80.00 | 打开商品 (https://detail.tmall.com/item.htm?id=671414115083) | 底板结构 | 2026-10-24T00:00:00.000Z
5127385935119112530 | 1 | 亚博机器人稳压电源扩展板 | 机器人稳压电源扩展板 YB-MPP01-V1.0（既有选型，实物版本待核） | 789594995509 | 1 | 块 | ¥63.70 | ¥63.70 | 打开商品 (https://item.taobao.com/item.htm?id=789594995509&skuId=5559923531866) | 计算供电 | 2026-10-25T00:00:00.000Z
5127836868022085702 | 1 | IMX415 800万像素MIPI相机模组 | 30P-IMX415配无畸变100度镜头M12 | 待补 | 1 | 个 | ¥208.18 | ¥208.18 | 待补商品链接 | 车载视觉 | 2026-10-30T00:00:00.000Z
