qyq11/opto-chess-robot-2027/03_hardware/01_机械/01_厂家资料/03_四路电机驱动/05_串口寄存器.xlsx

指令 | 说明 | 例子 | 备注
$mtype:x# | 配置电机的型号 | $mtype:1# | x:是电机的类型 数值代表的电机类型 1: 520电机 2：310电机 3: TT电机(带有编码器的) 4: TT电机(不带编码器)
$deadzone:xxxx# | 配置电机的pwm脉冲死区 | $deadzone:1650# | xxxx:是死区的值，这个需要测量得出,可通过改变此值，消除电机最小震荡。死区值的范围(0-3600)
$mline:xx# | 配置电机的相位线 | $mline:13# | xx:这个是电机的减速比参数，此值需要查商家电机的参数表可得
$wdiameter:xx# | 配置轮子的直径 | $wdiameter:50# | xx:这个是轮子的直径，此值可以测量或者用商家的信息得出
$MPID:x.xx,x.xx,x.xx# | 配置pid参数 | $MPID:1.5,0.03,0.1# | x.xx,x.xx,x.xx:这个分别是控制 电机p ,i ,d 的参数 每对数值进行一次变更，芯片会重启，会把正在运动的电机停止。属于正常情况
$flash_reset# | 恢复出厂
$spd:0,0,0,0# | 控制4个电机的速度 | $spd:100,-100,0,50# | 0,0,0,0 :代表板子丝印上的 M1,M2,M3,M4。速度的范围为(-1000~1000) 超出范围无效
$pwm:0,0,0,0# | 控制4个电机的pwm输出 | $spd:0,520,300,800# | 0,0,0,0 :代表板子丝印上的 M1,M2,M3,M4。速度的范围为(-3600~3600) 超出范围无效
$upload:0,0,0# | 接收编码器数据 | $upload:1,0,0# | $upload:0,0,0#:第一个0代表的是:轮子转动的总编码器数据 第二个0代表的是:轮子转动实时转动编码器数据(10ms) 第三个0代表的是:轮子的速度
$read_flash# | 查询flash变量
$read_vol# | 查询电池电量
