qyq11/opto-chess-robot-2027/05_data/01_raw/03_procurement/20261024_lcsc_order_01.png

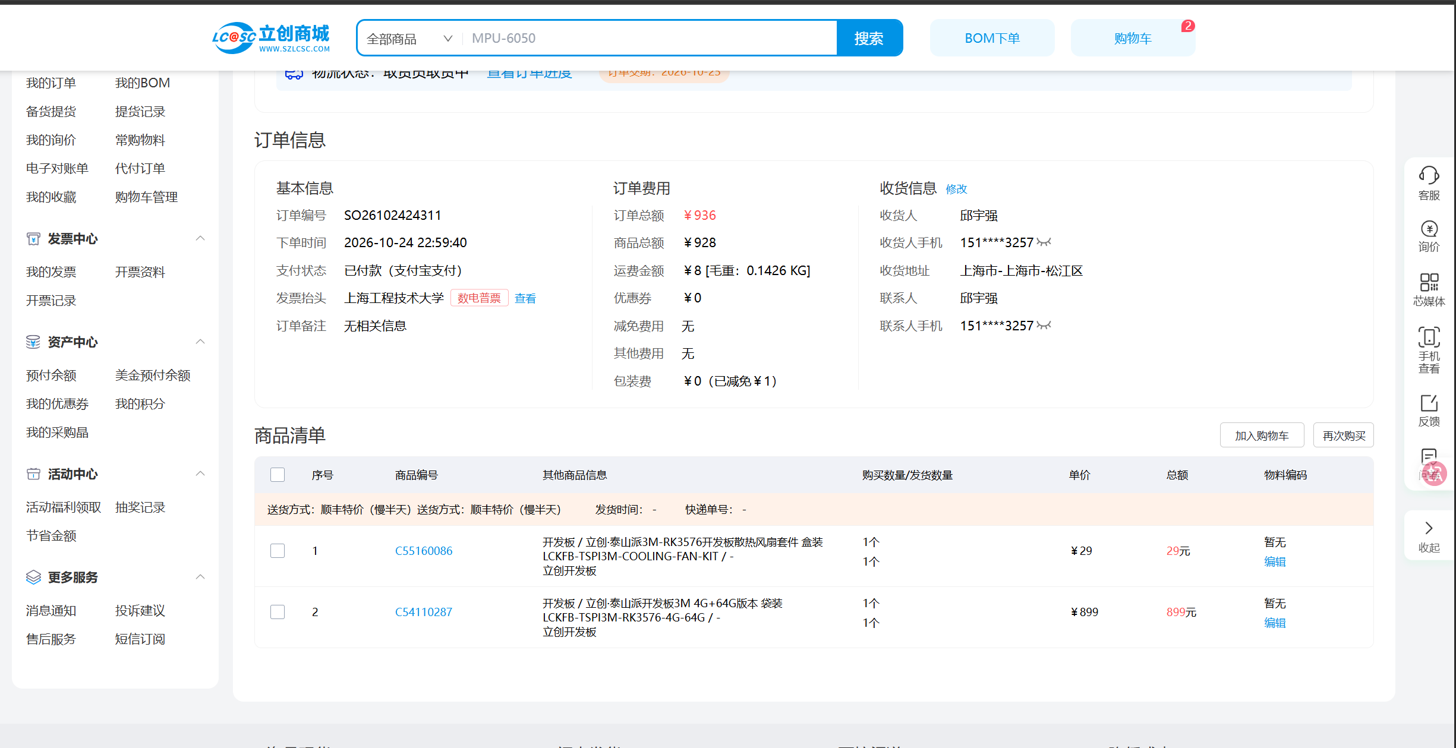
05_data/01_raw/03_procurement/20261024_lcsc_order_01.png
