qyq11/opto-chess-robot-2027/03_hardware/01_机械/01_厂家资料/01_T5X四驱/05_四驱底板.step

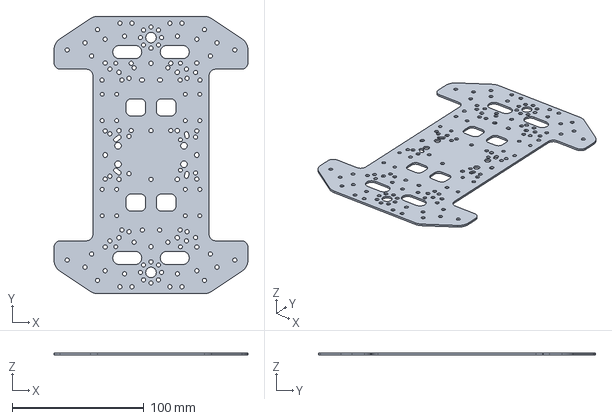
[picture p82: CAD file, 2026-10-30]
03_hardware/01_机械/01_厂家资料/01_T5X四驱/05_四驱底板.step
147.0 x 210.0 x 1.50 mm
