qyq11/opto-chess-robot-2027/03_hardware/01_机械/01_厂家资料/02_310电机/03_3mm六角联轴器.STEP

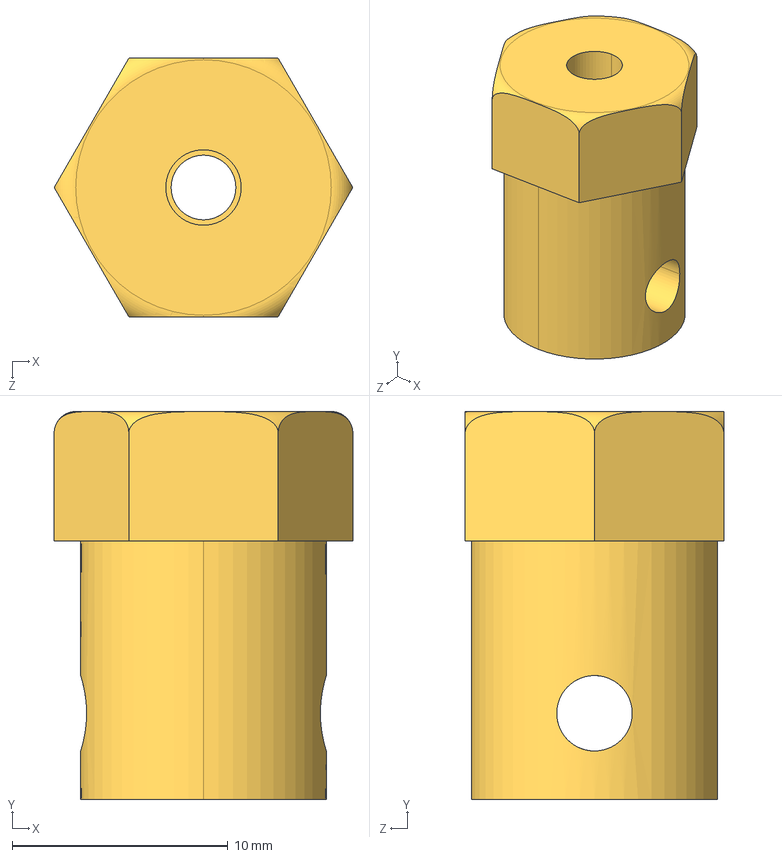
[picture p83: CAD file, 2026-10-30]
03_hardware/01_机械/01_厂家资料/02_310电机/03_3mm六角联轴器.STEP
13.9 x 18.0 x 12.0 mm
