qyq11/opto-chess-robot-2027/03_hardware/01_机械/01_厂家资料/03_四路电机驱动/01_四路驱动_V2.STEP

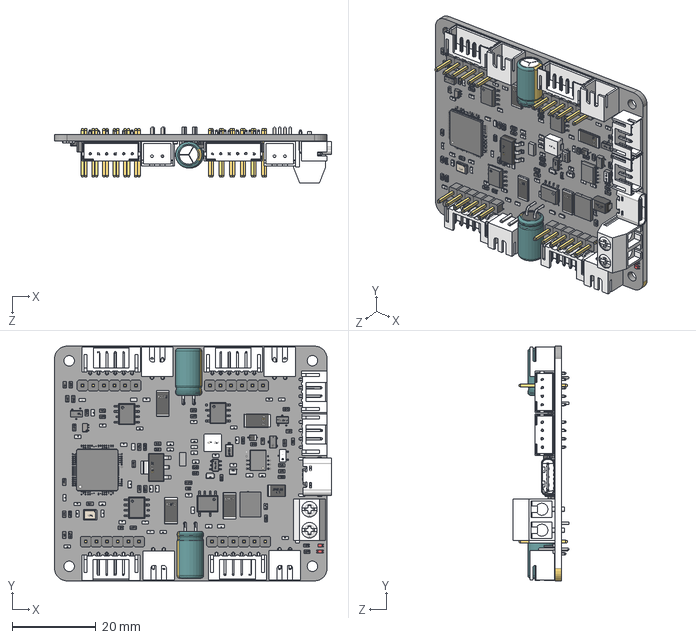
[picture p84: CAD file, 2026-10-30]
03_hardware/01_机械/01_厂家资料/03_四路电机驱动/01_四路驱动_V2.STEP
66.1 x 56.0 x 13.4 mm
