qyq11/opto-chess-robot-2027/03_hardware/01_机械/02_零件STEP/D05_相机杆与相机安装板.step

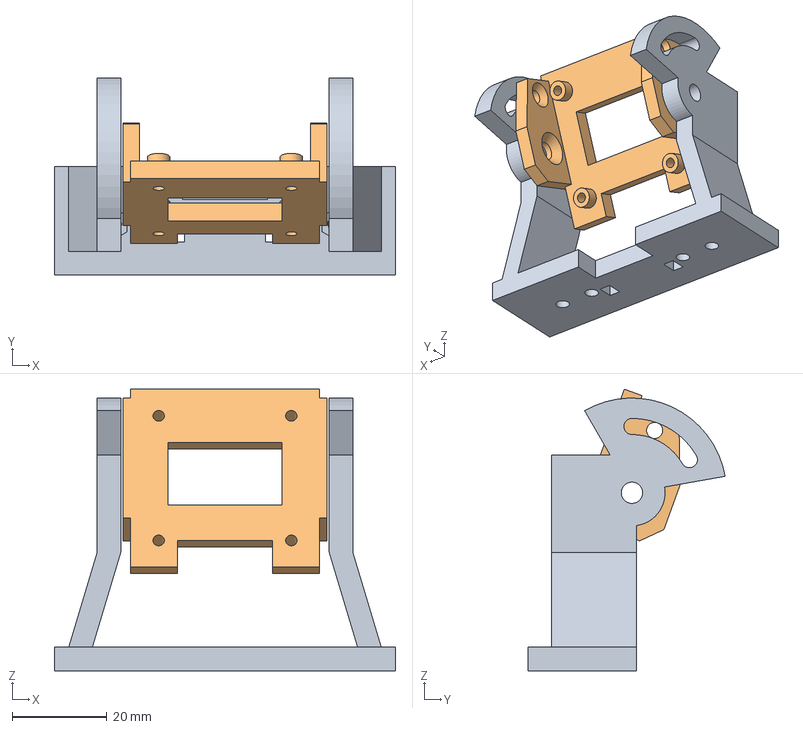
[picture p85: CAD file, 2026-11-03]
03_hardware/01_机械/02_零件STEP/D05_相机杆与相机安装板.step
72.0 x 41.7 x 59.5 mm
