qyq11/opto-chess-robot-2027/03_hardware/01_机械/03_打印件/04_推铲打印工程.FCStd

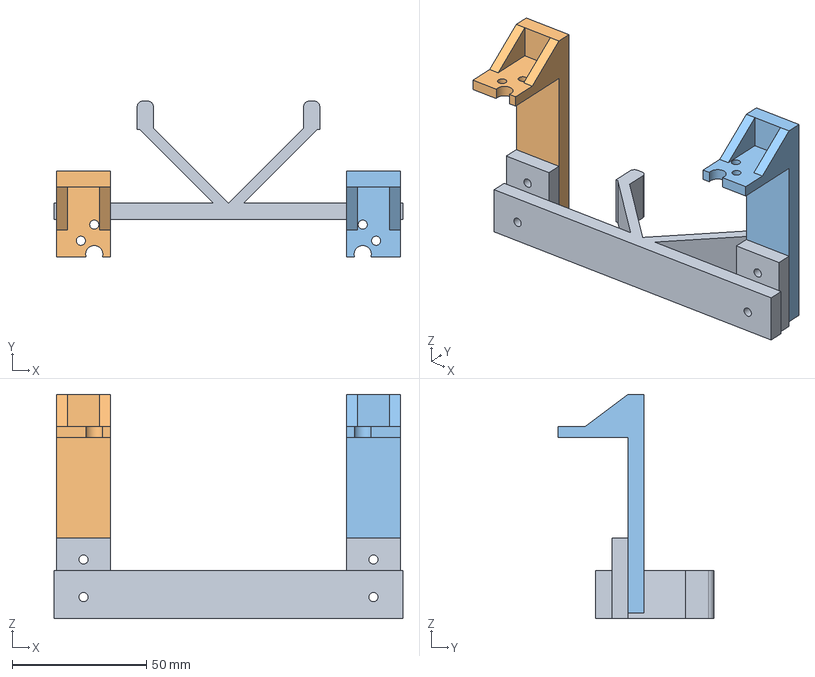
[picture p86: CAD file, 2026-11-06]
03_hardware/01_机械/03_打印件/04_推铲打印工程.FCStd
130.0 x 58.0 x 83.5 mm
V形导向推铲_90度_试制
左承力支架_双长孔调高
右承力支架_双长孔调高
