qyq11/opto-chess-robot-2027/03_hardware/01_机械/01_厂家资料/01_T5X四驱/04_厂家整车原件.stp

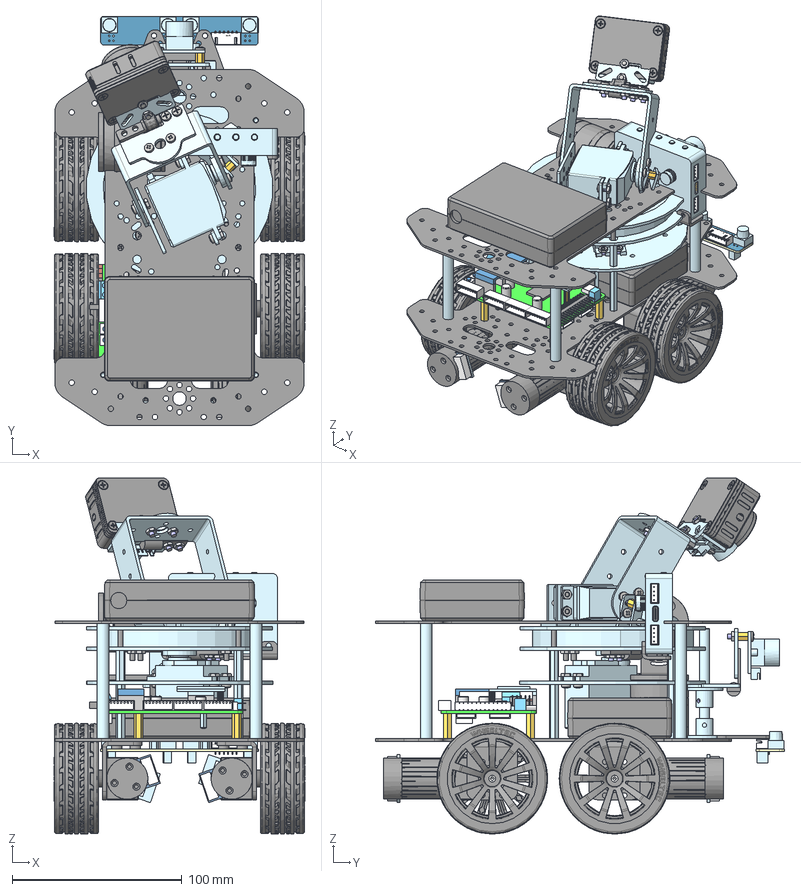
[picture p88: CAD file, 2026-10-30]
03_hardware/01_机械/01_厂家资料/01_T5X四驱/04_厂家整车原件.stp
147.7 x 241.3 x 209.8 mm
联轴器（TT马达专用）(1)_2 x 4
310﹜370Pro萇儂(GMR)_11_1_1 x 4
310、370Pro电机(霍尔)_1_1_1 x 4
R2X四驱底盘板件_1 x 2
E326S三元锂电池（新版20240515）2_1 x 2
6mm不锈钢法兰联轴器1_1_1_1_2 x 2
ｹ篋ﾋﾖ畧1_1_1_2
ﾄ｣ｿ饑CCDﾉ耘ｷ_1_1_1_2_1_1_1_2
CCDﾉﾏｰ蘋2_1_1_2_1_1_1_2
蹟譫 GB_T 6172.1-M3_4_1_1_1_1_2 x 2
ｽﾂﾁｴ2_4_3_1_1_2
蹟隊 GB_T 945-M3x6_2_1_1_1_2 x 2
CCDｵﾗｰ蘋2_2_1_1_2
3D_PCB_四路红外巡线模块_2025-04-24_1_1_1_1_2
M3-6 六角铜柱_1_1_1_1_2 x 2
ﾁｬｽﾓﾖｧｼﾜ1_1_1_1_1_2
ZHOUCHENG_1_2_2
上层板 - 副本_2_2
DUOPAN_1_2_2 x 2
ZHOUCHENGWAIBAN_1_2_2 x 2
ﾏﾂｲ羃蠑_1_3_3
DUOJI_1_3_3
靃ｽ_1_4_3
ｶ貊銈S20C_1_2_2
UZHIJIA_1_2_2
TONGZHU32_1_2_2 x 4
TONGZHU18_1_2_2
TONGZHU_1_2_2 x 3
ｵ貳ｬ_1_2_2
ﾉﾏｲ羃蘋2_4_2
蹟譫 GB_T 6172.1-M3_2_4_2 x 15
M3X20ｺﾚﾉｫｳﾁﾍｷﾂﾝﾋｿ_1_2_2 x 8
蹟隊 GB_T 823-M3x6_1_3_3 x 8
蹟隊 GB_T 823-M3x8_1_2_3 x 3
蹟隊 GB_T 823-M3x4_2_2_3 x 5
耀輸_CCD菁啣_1_2_2 x 3
ﾄ｣ｿ饑CCDﾉ耘ｷ_1_1_1_1_2_2 x 2
CCDﾉﾏｰ蘋2_1_1_1_2_2 x 2
蹟隊 GB_T 945-M3x8_1_2_2 x 4
蹟隊 GB_T 945-M3x6_1_2_4 x 8
蹟譫 GB_T 6172.1-M3_3_2_3 x 12
ｽﾂﾁｴ2_1_2_2 x 2
蝓蟈ㄗ酘衵ㄘ_3_1_1_3
C70安装底板_2_2
组装_刻度铰链2_2_2
相机_C70_铰链带刻度_1
相机-C100相机（新版）_2_3
C30D1_4_2
F32C无刷电机（客户图）_1_1 x 2
云台连接件L型（K230）（3mm）_1_1_1
(盓殤2ㄘ3D_1
蹟隊 GB_T 819.1-H_M2.5x5-4.8_1 x 8
蹟隊 GB_T 819.1-H_M3x5-4.8_5 x 3
正点原子K230
通用底座3D2_1
加高金属柱_2 x 4
GT50电机支架2_1 x 4
ﾖﾇﾄﾜｳｵﾂﾖ_ﾖｱｾｶ65mmﾆｯﾒﾆﾂﾖ｣ｨﾐﾂｰ譽ｩ_1_1_1_1_1 x 4
M3-15 六角铜柱_3 x 4
