qyq11/opto-chess-robot-2027/03_hardware/01_机械/01_厂家资料/02_310电机/01_310电机.STEP

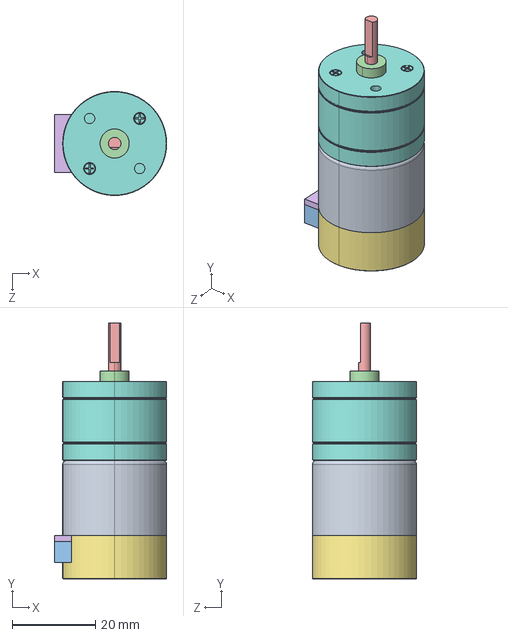
[picture p89: CAD file, 2026-10-24]
03_hardware/01_机械/01_厂家资料/02_310电机/01_310电机.STEP
27.0 x 61.5 x 25.0 mm
