qyq11/opto-chess-robot-2027/03_hardware/01_机械/03_打印件/02_左支架.stl

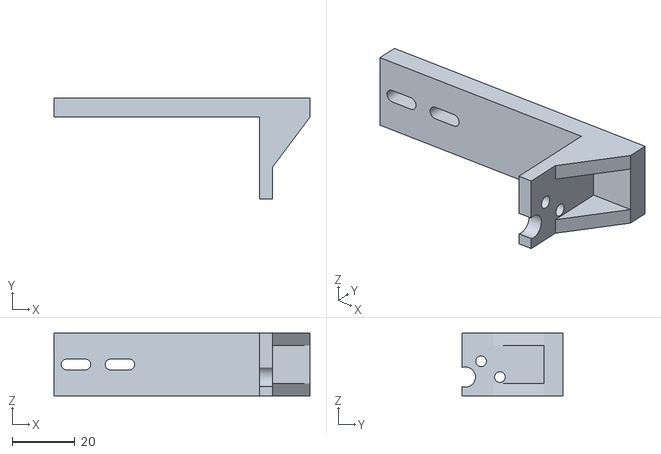
[picture p90: CAD file, 2026-11-03]
03_hardware/01_机械/03_打印件/02_左支架.stl
81.5 x 32.0 x 20.0
