qyq11/opto-chess-robot-2027/03_hardware/01_机械/03_整车布局.FCStd

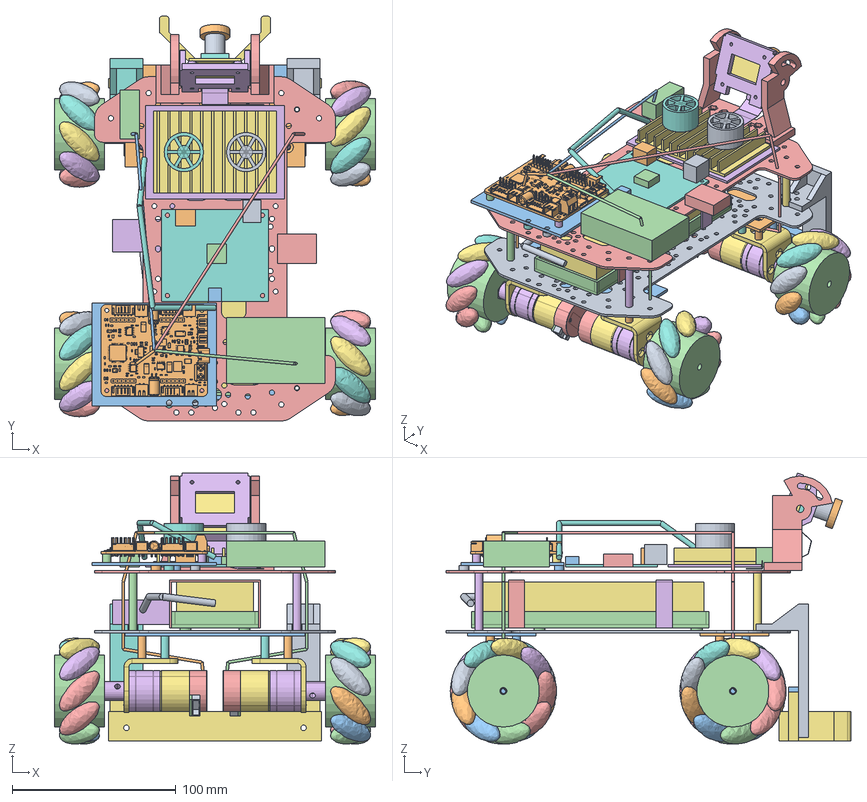
[picture p91: CAD file, 2026-11-06]
03_hardware/01_机械/03_整车布局.FCStd
195.8 x 247.0 x 165.3 mm
D01_T5X底板_保留原槽并补固定孔
D07_电机桥板_8沉头孔加4固定孔
D07_电机桥板_8沉头孔加4固定孔001
P03_尼龙轮毂_六角孔深待测
P03_滚子01_曲面近似_方向示意
P03_滚子02_曲面近似_方向示意
P03_滚子03_曲面近似_方向示意
P03_滚子04_曲面近似_方向示意
P03_滚子05_曲面近似_方向示意
P03_滚子06_曲面近似_方向示意
P03_滚子07_曲面近似_方向示意
P03_滚子08_曲面近似_方向示意
P03_滚子09_曲面近似_方向示意
P05_厂家3mm六角联轴器_原孔保留
P06_厂家电机实体01
P06_厂家电机实体02
P06_厂家电机实体03
P06_厂家电机实体04
P06_厂家电机实体05
P06_厂家电机实体06
P06_厂家电机实体07
P06_厂家电机实体08
P07_厂家新版支架_倒挂姿态
D06_M3绝缘柱_螺纹简化
D06_M3绝缘柱_螺纹简化001
D06_M3绝缘柱_螺纹简化002
D06_M3绝缘柱_螺纹简化003
P04_尼龙轮毂_六角孔深待测
P04_滚子01_曲面近似_方向示意
P04_滚子02_曲面近似_方向示意
P04_滚子03_曲面近似_方向示意
P04_滚子04_曲面近似_方向示意
P04_滚子05_曲面近似_方向示意
P04_滚子06_曲面近似_方向示意
P04_滚子07_曲面近似_方向示意
P04_滚子08_曲面近似_方向示意
P04_滚子09_曲面近似_方向示意
P05_厂家3mm六角联轴器_原孔保留001
P06_厂家电机实体001
P06_厂家电机实体002
P06_厂家电机实体003
P06_厂家电机实体004
P06_厂家电机实体005
P06_厂家电机实体006
P06_厂家电机实体007
P06_厂家电机实体008
P07_厂家新版支架_倒挂姿态001
D06_M3绝缘柱_螺纹简化004
D06_M3绝缘柱_螺纹简化005
D06_M3绝缘柱_螺纹简化006
D06_M3绝缘柱_螺纹简化007
P04_尼龙轮毂_六角孔深待测001
P04_滚子01_曲面近似_方向示意001
P04_滚子02_曲面近似_方向示意001
P04_滚子03_曲面近似_方向示意001
P04_滚子04_曲面近似_方向示意001
P04_滚子05_曲面近似_方向示意001
P04_滚子06_曲面近似_方向示意001
P04_滚子07_曲面近似_方向示意001
P04_滚子08_曲面近似_方向示意001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
