qyq11/opto-chess-robot-2027/03_hardware/01_机械/01_厂家资料/02_310电机/02_四孔支架.STEP

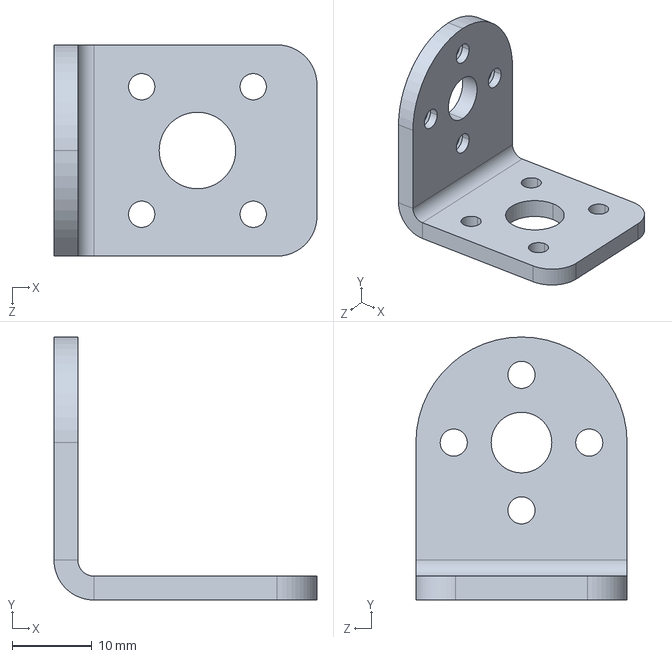
[picture p92: CAD file, 2026-10-24]
03_hardware/01_机械/01_厂家资料/02_310电机/02_四孔支架.STEP
33.0 x 33.0 x 26.5 mm
