qyq11/opto-chess-robot-2027/03_hardware/01_机械/02_零件库.FCStd

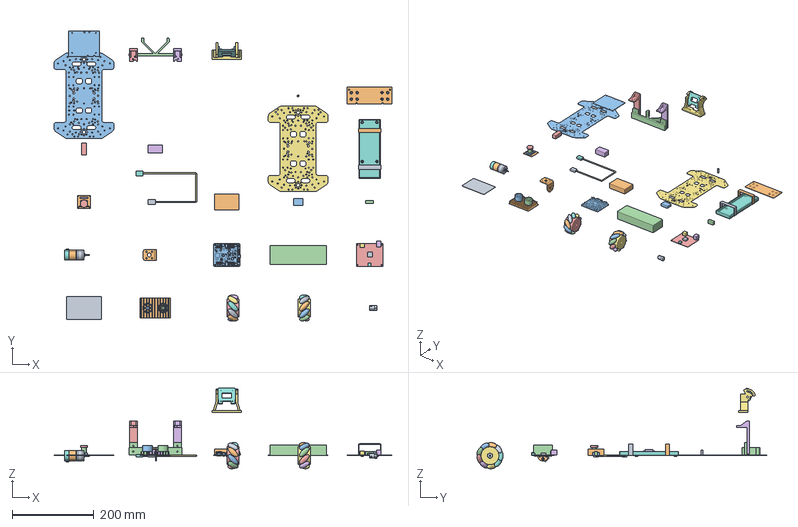
[picture p93: CAD file, 2026-11-06]
03_hardware/01_机械/02_零件库.FCStd
828.5 x 710.8 x 197.8 mm
P01_PCB_外形已核_厚度假设
P02_散热片_尺寸预留
P02_双风扇_仅示意
P02_双风扇_仅示意001
P03_尼龙轮毂_六角孔深待测
P03_滚子01_曲面近似_方向示意
P03_滚子02_曲面近似_方向示意
P03_滚子03_曲面近似_方向示意
P03_滚子04_曲面近似_方向示意
P03_滚子05_曲面近似_方向示意
P03_滚子06_曲面近似_方向示意
P03_滚子07_曲面近似_方向示意
P03_滚子08_曲面近似_方向示意
P03_滚子09_曲面近似_方向示意
P04_尼龙轮毂_六角孔深待测
P04_滚子01_曲面近似_方向示意
P04_滚子02_曲面近似_方向示意
P04_滚子03_曲面近似_方向示意
P04_滚子04_曲面近似_方向示意
P04_滚子05_曲面近似_方向示意
P04_滚子06_曲面近似_方向示意
P04_滚子07_曲面近似_方向示意
P04_滚子08_曲面近似_方向示意
P04_滚子09_曲面近似_方向示意
P05_厂家3mm六角联轴器_原孔保留
P06_厂家电机实体01
P06_厂家电机实体02
P06_厂家电机实体03
P06_厂家电机实体04
P06_厂家电机实体05
P06_厂家电机实体06
P06_厂家电机实体07
P06_厂家电机实体08
P07_厂家新版支架_倒挂姿态
P08_厂家V2驱动板_曲面参考非封闭实体
P09_硬壳电池_选型记录尺寸待复测
P10_亚博电源PCB_Ø2.7四孔
P10_DC接口突出_总Y61.72
P10_输入螺丝端子_轮廓示意
P10_TypeC输出_位置示意
P10_电感及主芯片_示意
P11_IMX415板32x32_四角孔28x28_按参考图_分板槽省略
P11_M12镜座17x17_按参考图
P11_100度镜筒_仅参考包络
P11_镜头前段_参考总深24.6含板厚
P11_30针0.5间距插座_外形及位置示意
P12_300mm成品C-C线_折线等长示意
P12_TypeC插头_假设包络
P12_第二端TypeC插头_假设包络
P13_待定SKU_包络不是实物尺寸
P14_待定SKU_包络不是实物尺寸
P15_待定SKU_包络不是实物尺寸
P16_待定SKU_包络不是实物尺寸
P17_待定SKU_包络不是实物尺寸
D01_T5X底板_保留原槽并补固定孔
D02_电池托盘_内宽49内长141
D02_电池绑带_假设宽10厚1.2
D02_电池绑带_假设宽10厚1.001
D03_T5X上层板_驱动补孔_相机复用前缘原孔
D04_V形导向推铲_90度_试制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
