qyq11/opto-chess-robot-2027/03_hardware/01_机械/02_零件STEP/P11_IMX415 100度M12 30针MIPI相机.step

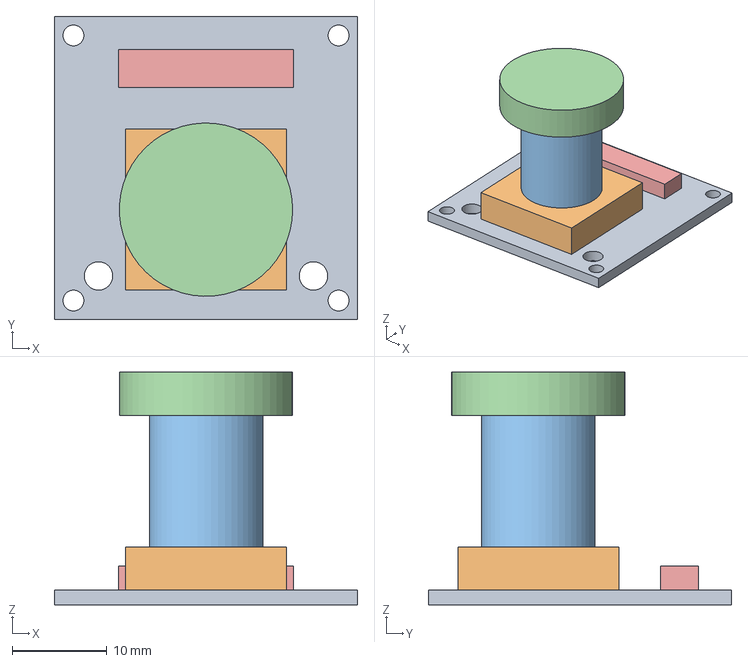
[picture p94: CAD file, 2026-11-02]
03_hardware/01_机械/02_零件STEP/P11_IMX415 100度M12 30针MIPI相机.step
32.0 x 32.0 x 24.6 mm
