qyq11/opto-chess-robot-2027/03_hardware/01_机械/03_打印件/01_导向推铲.stl

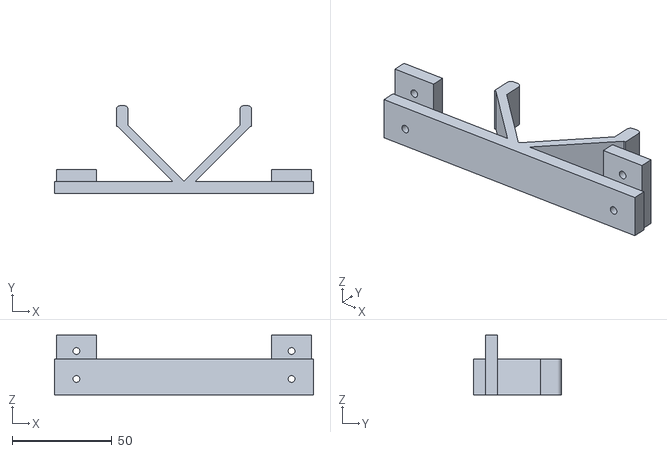
[picture p95: CAD file, 2026-11-03]
03_hardware/01_机械/03_打印件/01_导向推铲.stl
130.0 x 44.0 x 30.0
