qyq11/opto-chess-robot-2027/03_hardware/01_机械/04_整车布局.step

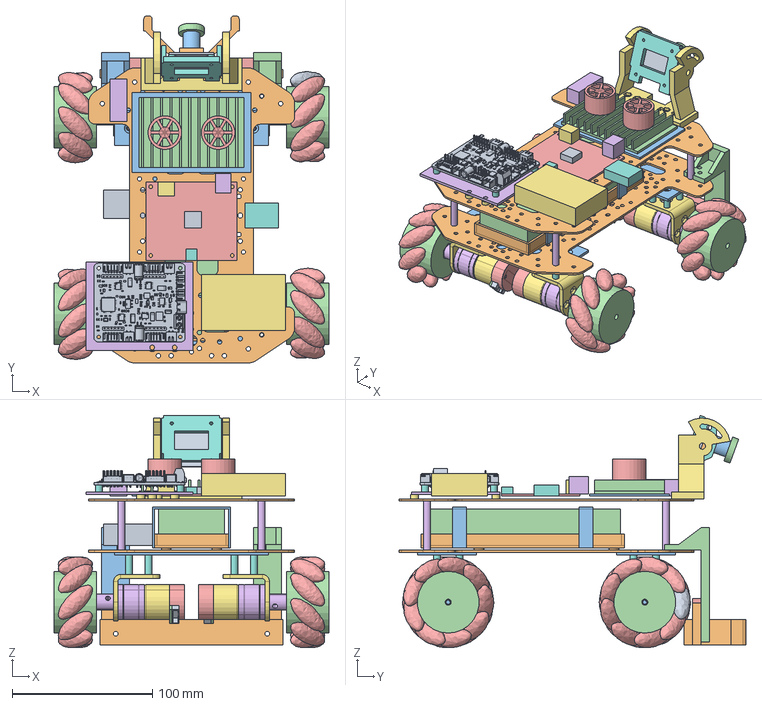
[picture p96: CAD file, 2026-11-03]
03_hardware/01_机械/04_整车布局.step
195.8 x 247.0 x 165.3 mm
