qyq11/opto-chess-robot-2027/03_hardware/01_机械/03_打印件/07_相机俯仰托架.stl

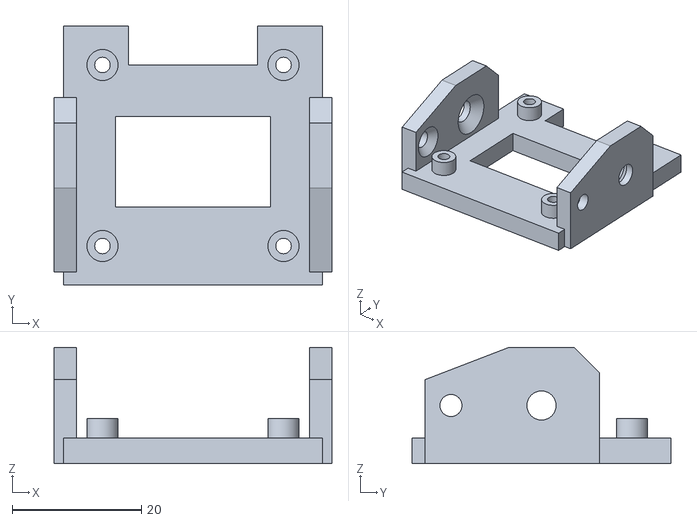
[picture p97: CAD file, 2026-11-03]
03_hardware/01_机械/03_打印件/07_相机俯仰托架.stl
43.0 x 40.0 x 18.0
