qyq11/opto-chess-robot-2027/03_hardware/01_机械/02_零件STEP/P10.step

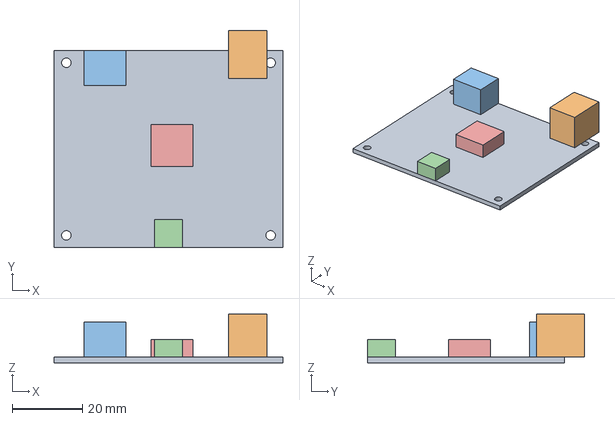
[picture p98: CAD file, 2026-10-30]
03_hardware/01_机械/02_零件STEP/P10.step
65.0 x 61.7 x 13.8 mm
