qyq11/opto-chess-robot-2027/03_hardware/01_机械/02_零件STEP/P14_SPI IMU完整模块.step

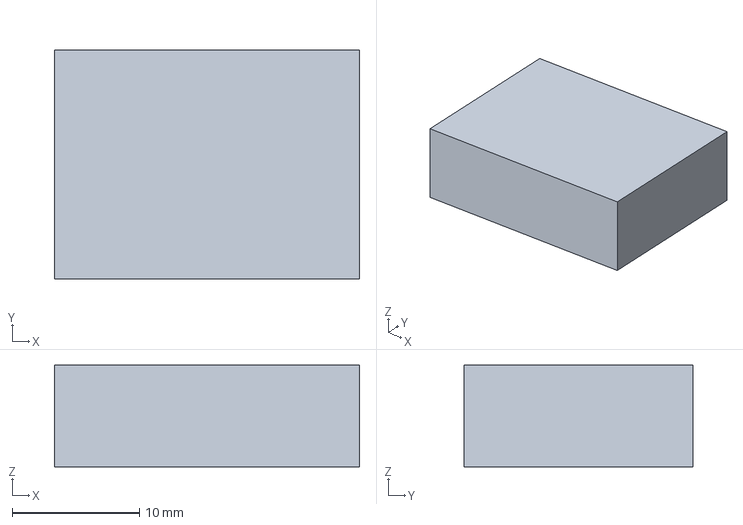
[picture p99: CAD file, 2026-10-30]
03_hardware/01_机械/02_零件STEP/P14_SPI IMU完整模块.step
24.0 x 18.0 x 8.00 mm
