qyq11/opto-chess-robot-2027/03_hardware/01_机械/03_打印件/08_相机支架工程.FCStd

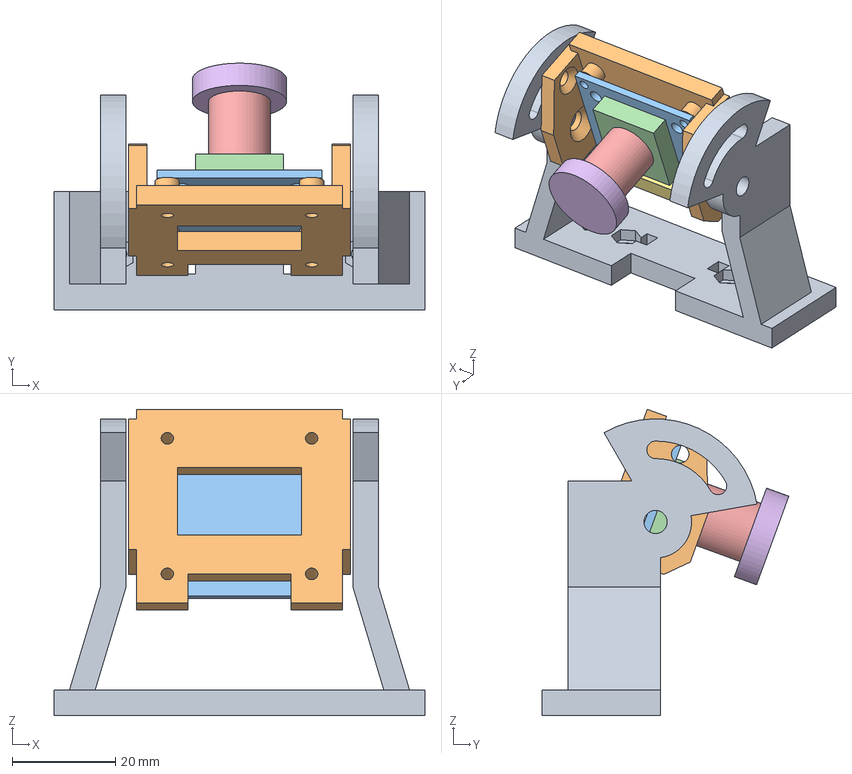
[picture p100: CAD file, 2026-11-03]
03_hardware/01_机械/03_打印件/08_相机支架工程.FCStd
72.0 x 47.9 x 59.5 mm
相机上层固定座_四孔_双侧弧槽
相机俯仰托架_28x28孔距_背面留空
相机参考_P11_IMX415板32x32_四角孔28x28_按参考图_分板槽省略
相机参考_P11_M12镜座17x17_按参考图
相机参考_P11_100度镜筒_仅参考包络
相机参考_P11_镜头前段_参考总深24.6含板厚
相机参考_P11_30针0.5间距插座_外形及位置示意
