qyq11/opto-chess-robot-2027/03_hardware/01_机械/02_零件STEP/D08_四路驱动安装板.step

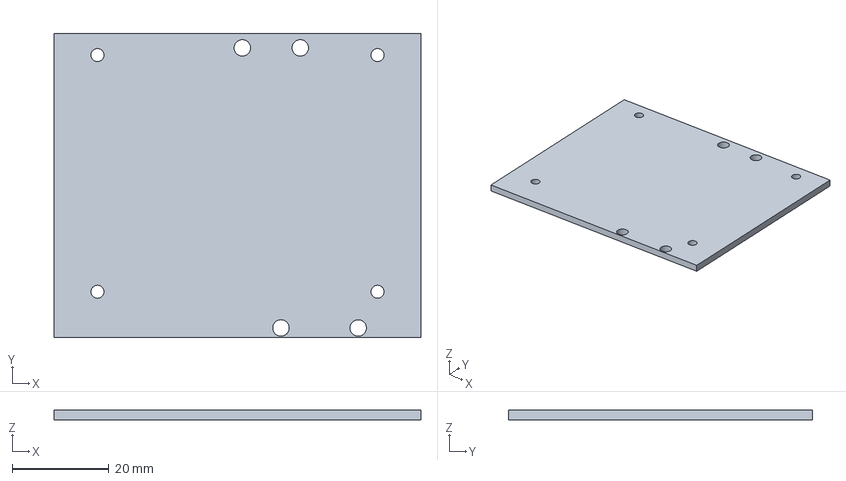
[picture p101: CAD file, 2026-10-30]
03_hardware/01_机械/02_零件STEP/D08_四路驱动安装板.step
76.0 x 63.0 x 2.00 mm
