qyq11/opto-chess-robot-2027/03_hardware/01_机械/03_打印件/06_相机固定座.stl

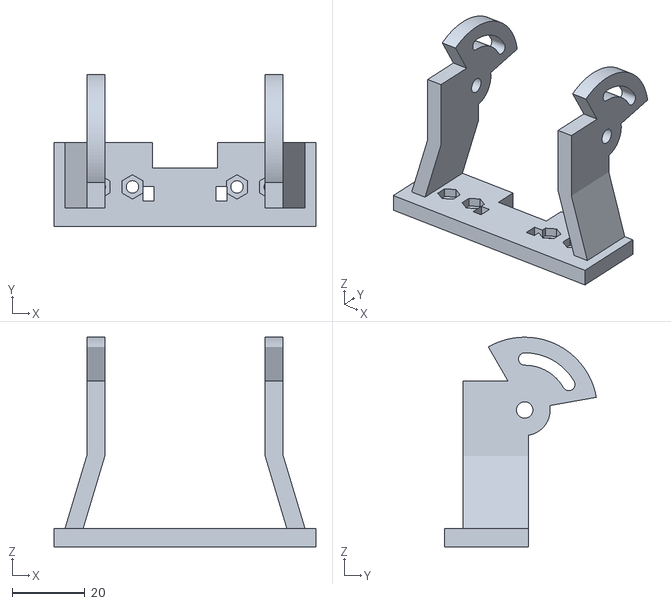
[picture p102: CAD file, 2026-11-03]
03_hardware/01_机械/03_打印件/06_相机固定座.stl
72.0 x 41.7 x 57.6
