qyq11/opto-chess-robot-2027/03_hardware/01_机械/02_零件STEP/P02_泰山派原配双风扇套件 C55160086.step

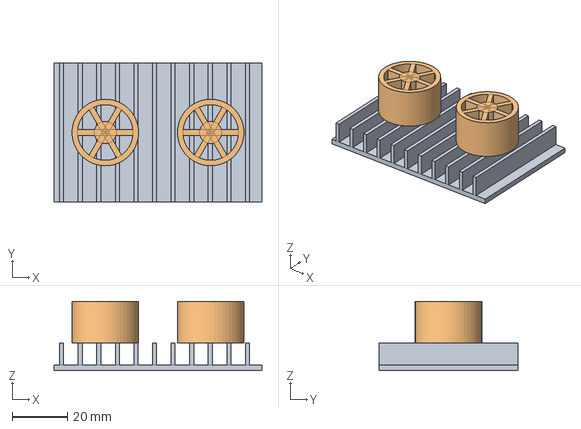
[picture p103: CAD file, 2026-10-30]
03_hardware/01_机械/02_零件STEP/P02_泰山派原配双风扇套件 C55160086.step
75.0 x 50.0 x 25.0 mm
