qyq11/opto-chess-robot-2027/03_hardware/01_机械/02_零件STEP/P03_65mm尼龙麦轮_左.step

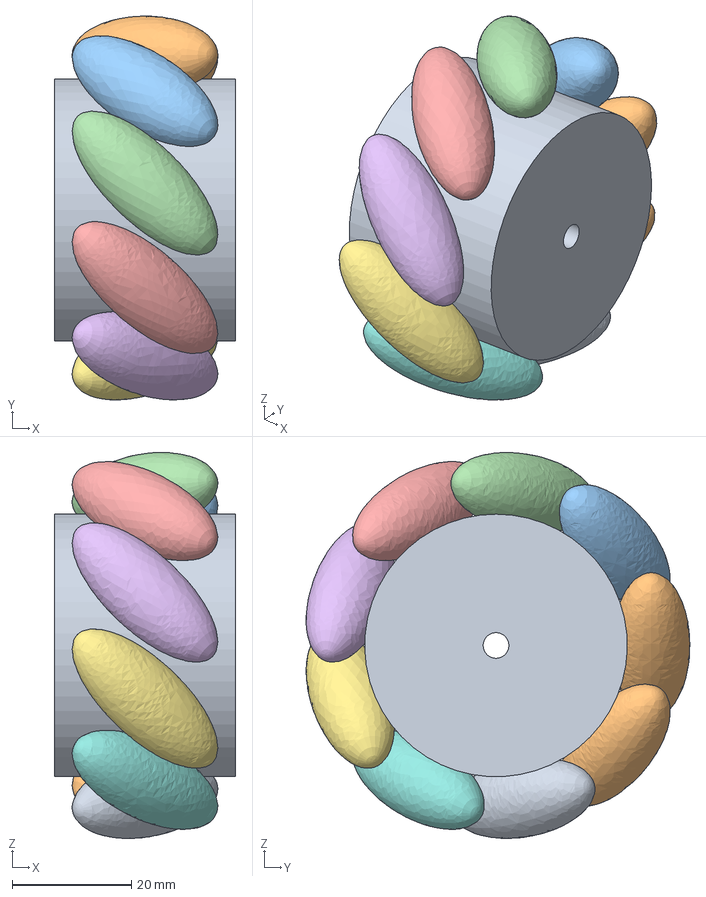
[picture p104: CAD file, 2026-10-30]
03_hardware/01_机械/02_零件STEP/P03_65mm尼龙麦轮_左.step
30.4 x 64.3 x 64.7 mm
