qyq11/opto-chess-robot-2027/03_hardware/01_机械/02_零件STEP/P09_格氏2S 7200mAh 50C硬壳 XT60.step

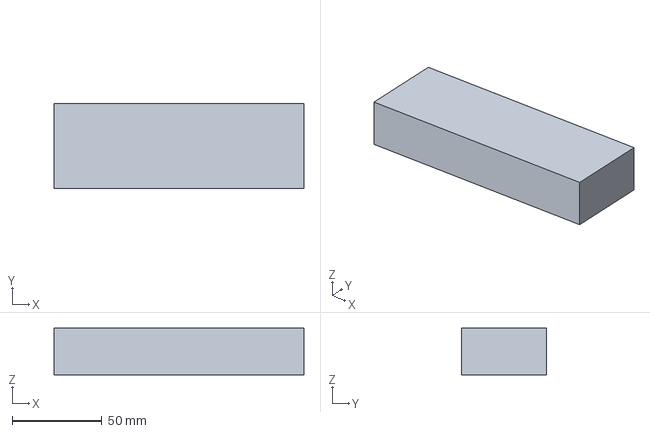
[picture p105: CAD file, 2026-10-30]
03_hardware/01_机械/02_零件STEP/P09_格氏2S 7200mAh 50C硬壳 XT60.step
139.0 x 47.0 x 26.0 mm
