qyq11/opto-chess-robot-2027/03_hardware/01_机械/02_零件STEP/D06_绝缘柱与紧固件.step

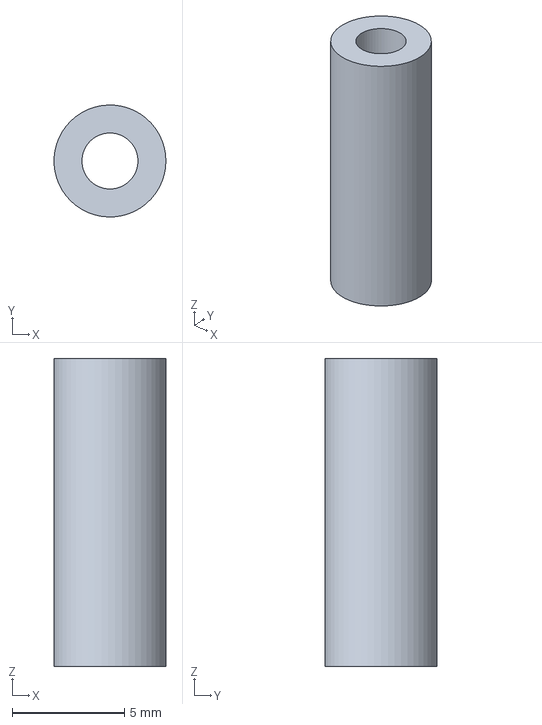
[picture p106: CAD file, 2026-10-30]
03_hardware/01_机械/02_零件STEP/D06_绝缘柱与紧固件.step
5.00 x 5.00 x 13.8 mm
