qyq11/opto-chess-robot-2027/03_hardware/01_机械/02_零件STEP/D07_前后电机固定桥板.step

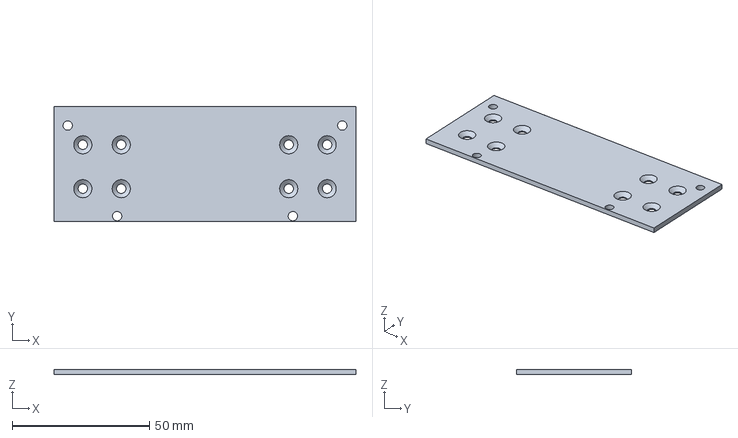
[picture p107: CAD file, 2026-10-30]
03_hardware/01_机械/02_零件STEP/D07_前后电机固定桥板.step
110.0 x 42.0 x 2.00 mm
