qyq11/opto-chess-robot-2027/03_hardware/01_机械/02_零件STEP/P17_保险、开关与XT60_T插分电.step

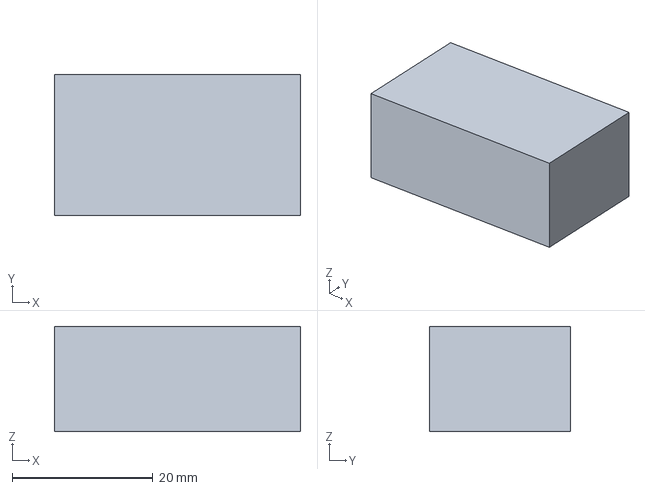
[picture p108: CAD file, 2026-10-30]
03_hardware/01_机械/02_零件STEP/P17_保险、开关与XT60_T插分电.step
35.0 x 20.0 x 15.0 mm
