qyq11/opto-chess-robot-2027/03_hardware/01_机械/02_零件STEP/P07_亚博310新版原配L支架.step

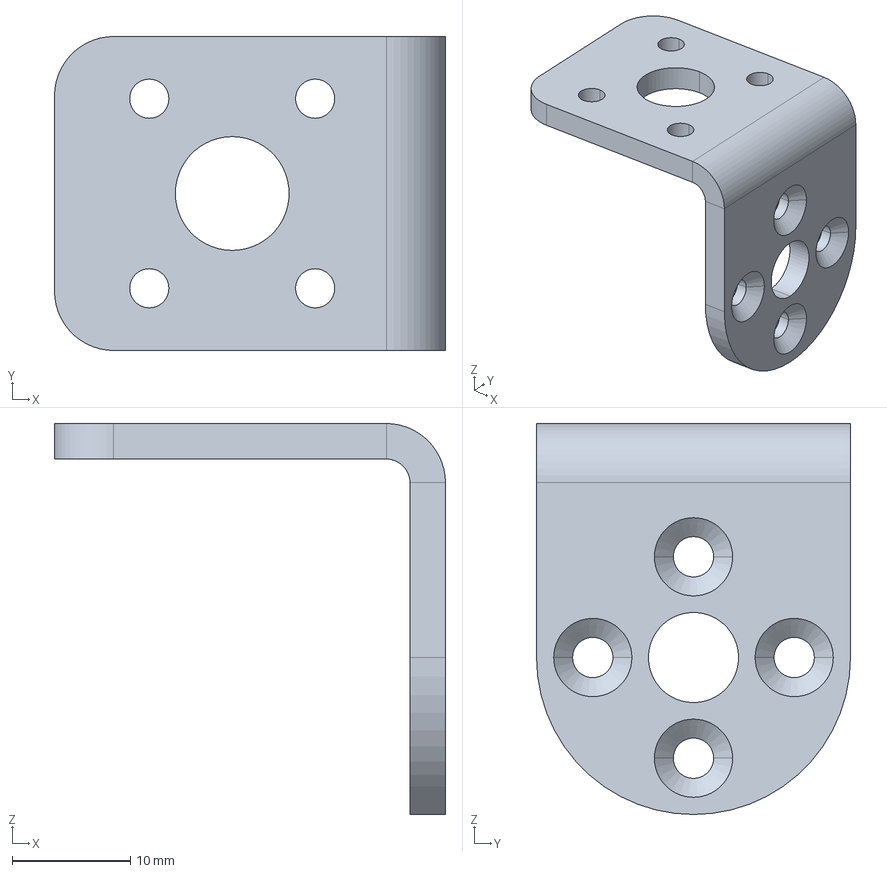
[picture p109: CAD file, 2026-10-30]
03_hardware/01_机械/02_零件STEP/P07_亚博310新版原配L支架.step
33.0 x 26.5 x 33.0 mm
