qyq11/opto-chess-robot-2027/03_hardware/01_机械/02_零件STEP/P15_前碰撞触点.step

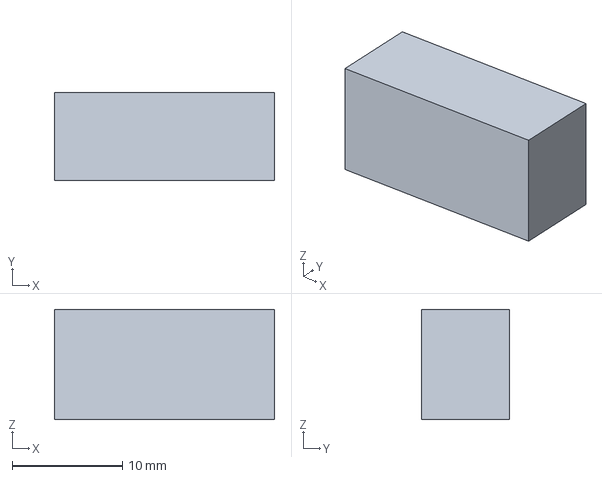
[picture p110: CAD file, 2026-10-30]
03_hardware/01_机械/02_零件STEP/P15_前碰撞触点.step
20.0 x 8.00 x 10.0 mm
