qyq11/opto-chess-robot-2027/03_hardware/01_机械/02_零件STEP/P16_le1mW II类激光及受控固定件.step

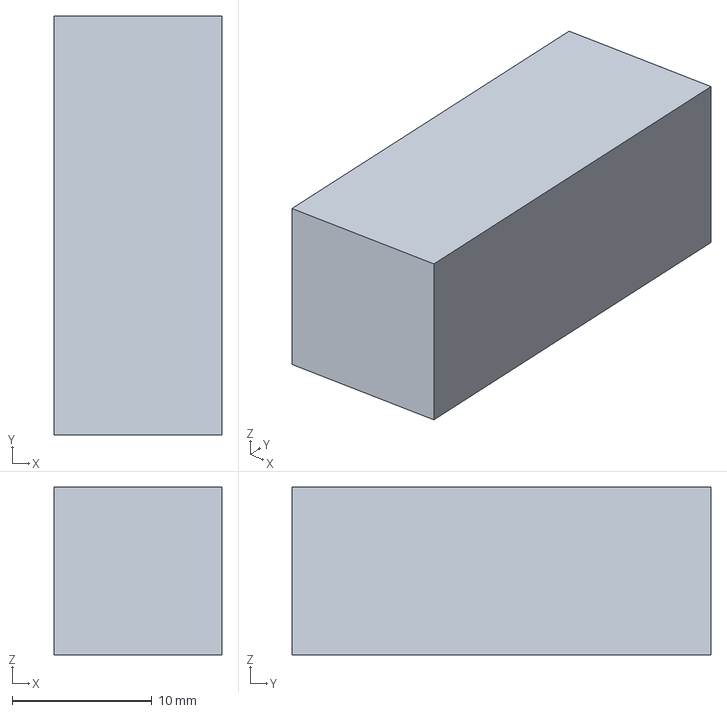
[picture p111: CAD file, 2026-10-30]
03_hardware/01_机械/02_零件STEP/P16_le1mW II类激光及受控固定件.step
12.0 x 30.0 x 12.0 mm
