qyq11/opto-chess-robot-2027/03_hardware/01_机械/02_零件STEP/P13_STM32F407VET6完整开发板.step

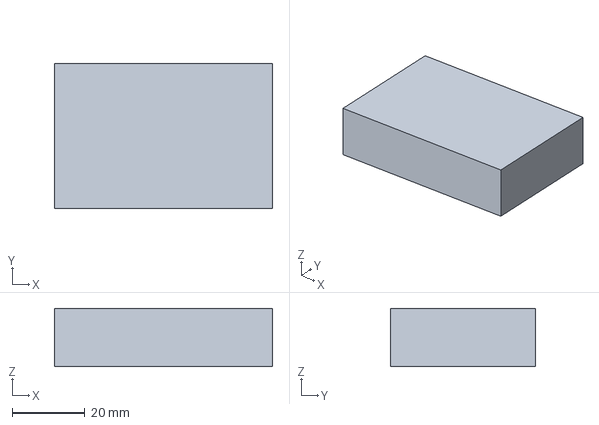
[picture p112: CAD file, 2026-10-30]
03_hardware/01_机械/02_零件STEP/P13_STM32F407VET6完整开发板.step
60.0 x 40.0 x 16.0 mm
