qyq11/opto-chess-robot-2027/03_hardware/01_机械/02_零件STEP/D02_电池托盘与绑带.step

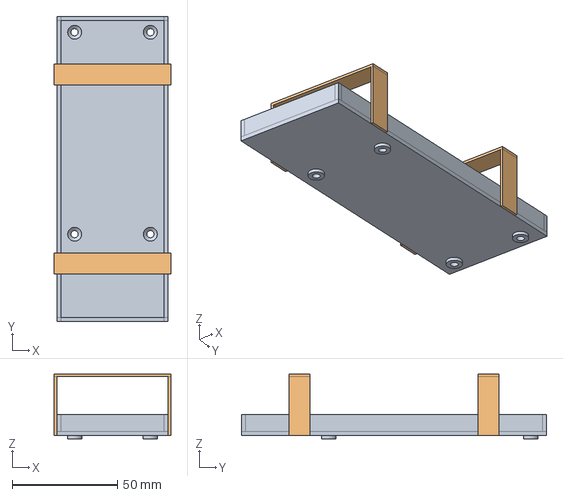
[picture p113: CAD file, 2026-10-30]
03_hardware/01_机械/02_零件STEP/D02_电池托盘与绑带.step
55.4 x 145.0 x 30.7 mm
