qyq11/opto-chess-robot-2027/03_hardware/01_机械/02_零件STEP/P06_亚博MD310Z20_7.4V电机.step

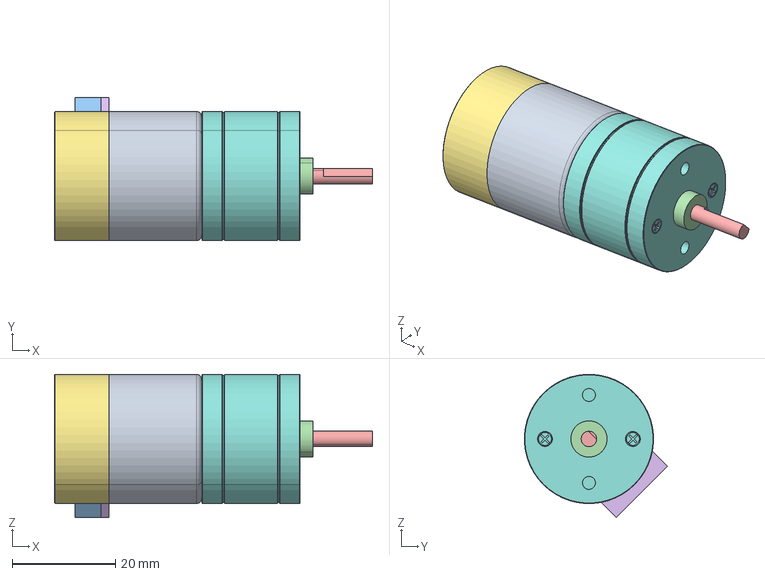
[picture p114: CAD file, 2026-10-30]
03_hardware/01_机械/02_零件STEP/P06_亚博MD310Z20_7.4V电机.step
61.5 x 27.7 x 27.7 mm
