qyq11/opto-chess-robot-2027/03_hardware/01_机械/02_零件STEP/P12.step

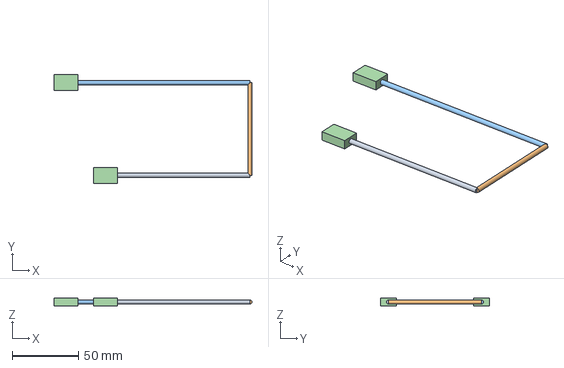
[picture p115: CAD file, 2026-10-30]
03_hardware/01_机械/02_零件STEP/P12.step
149.6 x 82.0 x 6.00 mm
