qyq11/opto-chess-robot-2027/03_hardware/01_机械/02_零件STEP/P01_泰山派3M RK3576 4G+64G C54110287.step

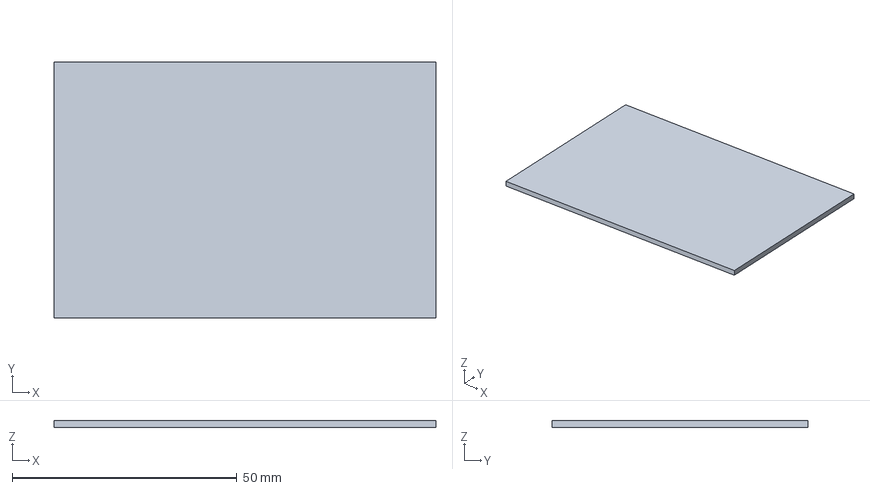
[picture p116: CAD file, 2026-10-30]
03_hardware/01_机械/02_零件STEP/P01_泰山派3M RK3576 4G+64G C54110287.step
85.0 x 57.0 x 1.60 mm
