qyq11/opto-chess-robot-2027/(list of files, cad)

Other CAD files:
03_hardware/01_机械/02_零件STEP/D03_电控安装层.step
03_hardware/01_机械/01_厂家资料/01_T5X四驱/03_底板孔位图.dwg
03_hardware/01_机械/02_零件STEP/D04_前推板及支架.step
03_hardware/01_机械/03_打印件/05_推铲打印工程.step
03_hardware/01_机械/02_零件STEP/P05_3mm六角联轴器.step
03_hardware/01_机械/03_打印件/09_相机支架工程.step
03_hardware/01_机械/03_打印件/03_右支架.stl
03_hardware/01_机械/02_零件STEP/P04_65mm尼龙麦轮_右.step
03_hardware/01_机械/02_零件STEP/D01.step
03_hardware/01_机械/02_零件STEP/P08_亚博四路编码器电机驱动.step
