qyq11/opto-chess-robot-2027/05_data/01_raw/03_procurement/20261024_yahboom_wheel_assembly_01.jpg

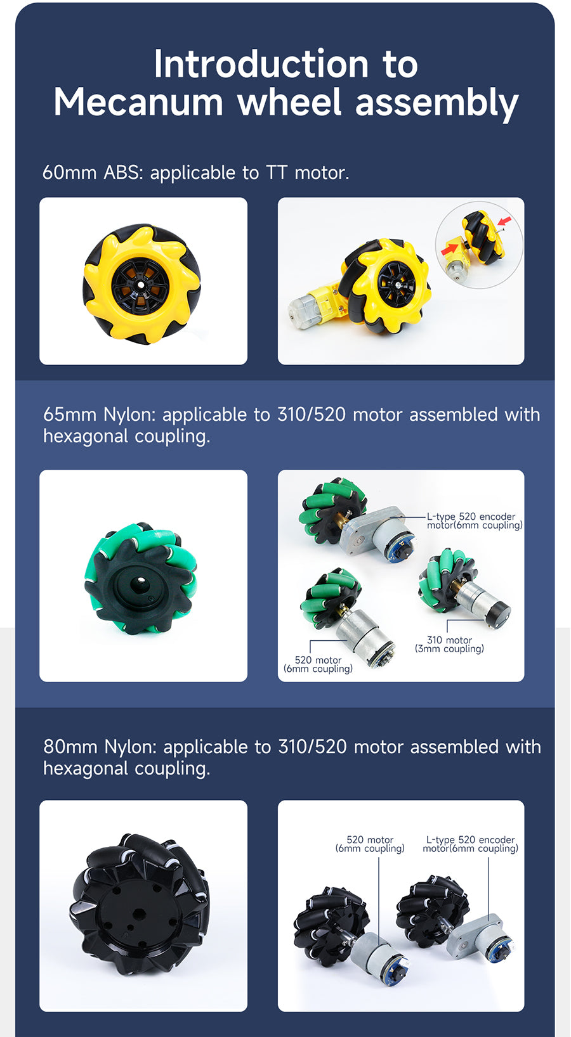
05_data/01_raw/03_procurement/20261024_yahboom_wheel_assembly_01.jpg
