qyq11/opto-chess-robot-2027/05_data/03_results/02_perspective/20261023_perspective_birdview_01.png

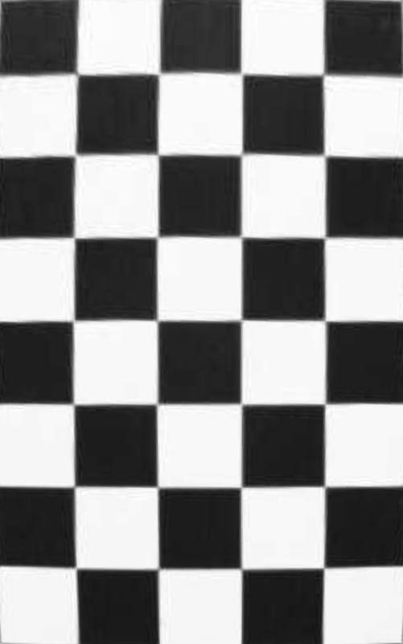
05_data/03_results/02_perspective/20261023_perspective_birdview_01.png
