qyq11/opto-chess-robot-2027/05_data/03_results/03_xiangqi/20261023_xiangqi_oblique_points_01.png

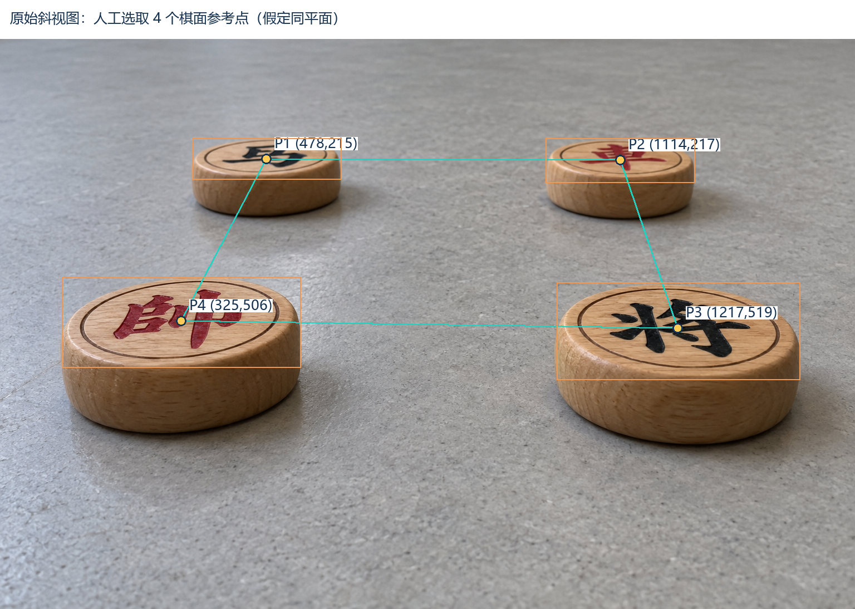
05_data/03_results/03_xiangqi/20261023_xiangqi_oblique_points_01.png
