qyq11/opto-chess-robot-2027/05_data/03_results/05_procurement/20261030_jd_yahboom_claim_01.png

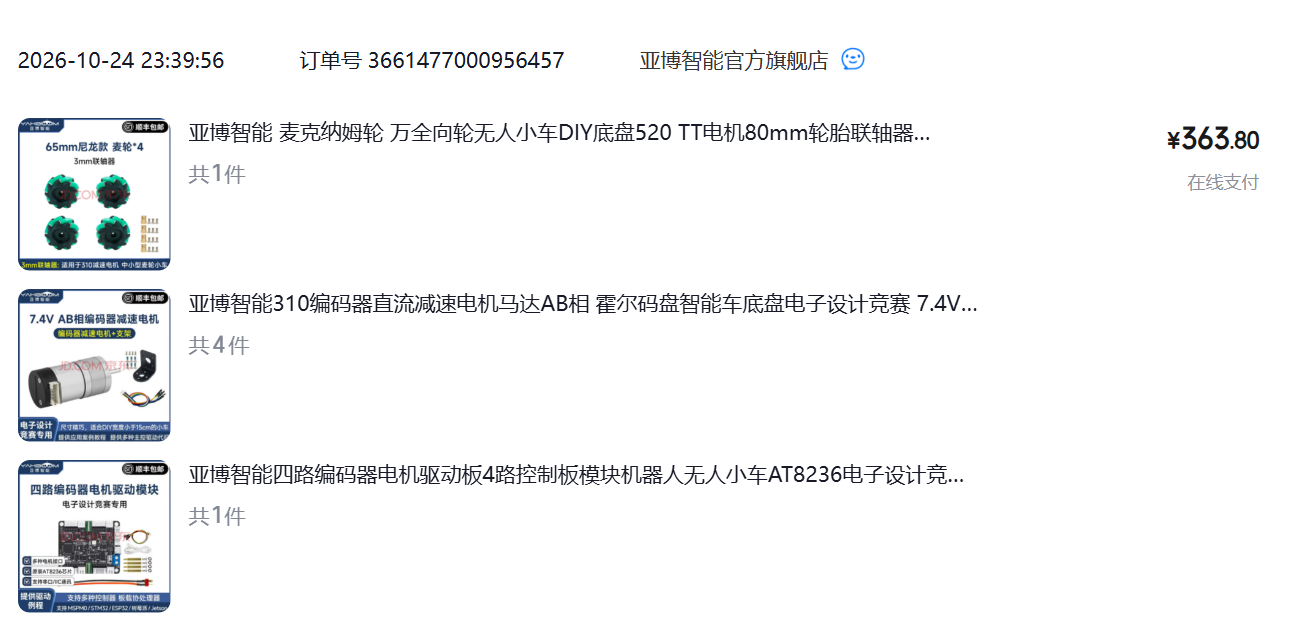
05_data/03_results/05_procurement/20261030_jd_yahboom_claim_01.png
