qyq11/opto-chess-robot-2027/03_hardware/02_采购/06_20261027_立创_发票_SO26102424311.pdf

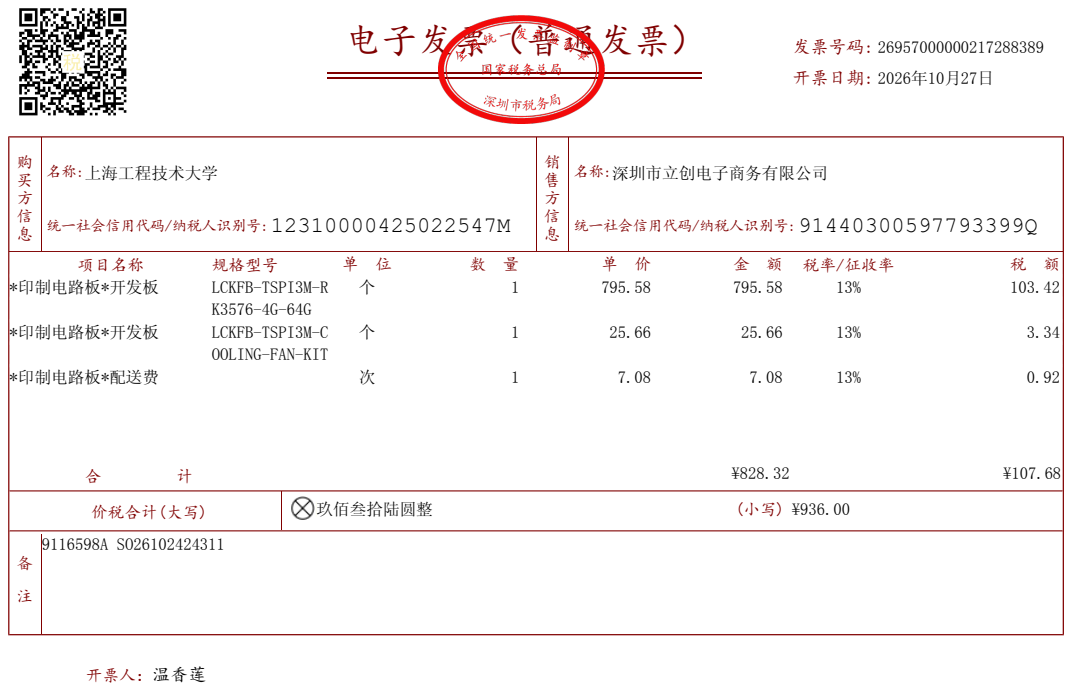
[picture p138: page 1]
电子发票（普通发票）; 发票号码: 26957000000217288389; 开票日期: 2026年10月27日; 开票人：温香莲; 项目名称; 规格型号; 税率/征收率; *印制电路板*开发板; LCKFB-TSPI3M-R; LCKFB-TSPI3M-C; *印制电路板*配送费; 价税合计(大写); 玖佰叁拾陆圆整; 名称:深圳市立创电子商务有限公司; 统一社会信用代码/纳税人识别号:; 名称:上海工程技术大学

OOLING-FAN-KIT
