qyq11/opto-chess-robot-2027/03_hardware/02_采购/04_20261024_轮趣_订单详情_5127831576100359305.pdf

## 买家已付款

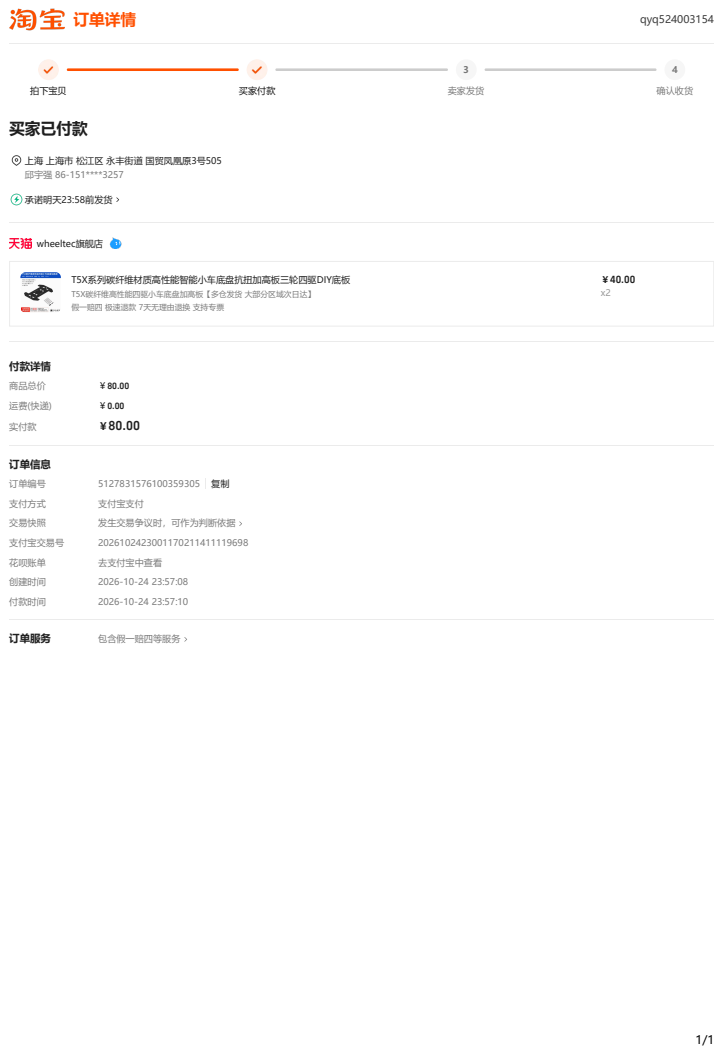
[picture p139: page 1]
订单详情; qyq524003154; 拍下宝贝; 买家付款; 卖家发货; 确认收货; 承诺明天23:58前发货; wheeltec旗舰店; 付款详情; 商品总价; 实付款; 订单信息; 订单编号; 支付方式; 支付宝支付; 交易快照; 发生交易争议时，可作为判断依据; 支付宝交易号; 花呗账单; 去支付宝中查看; 创建时间; 付款时间; 订单服务; 包含假一赔四等服务

上海 上海市 松江区 永丰街道 国贸凤凰原3号505
邱宇强 86-151****3257

T5X系列碳纤维材质高性能智能小车底盘抗扭加高板三轮四驱DIY底板 (https://a.m.taobao.com/i671414115083.htm?from=detail)
T5X碳纤维高性能四驱小车底盘加高板【多仓发货 大部分区域次日达】
假一赔四 极速退款 7天无理由退换 支持专票
