qyq11/opto-chess-robot-2027/03_hardware/02_采购/05_20261025_亚博_订单详情_5127385935119112530.pdf

## 买家已付款

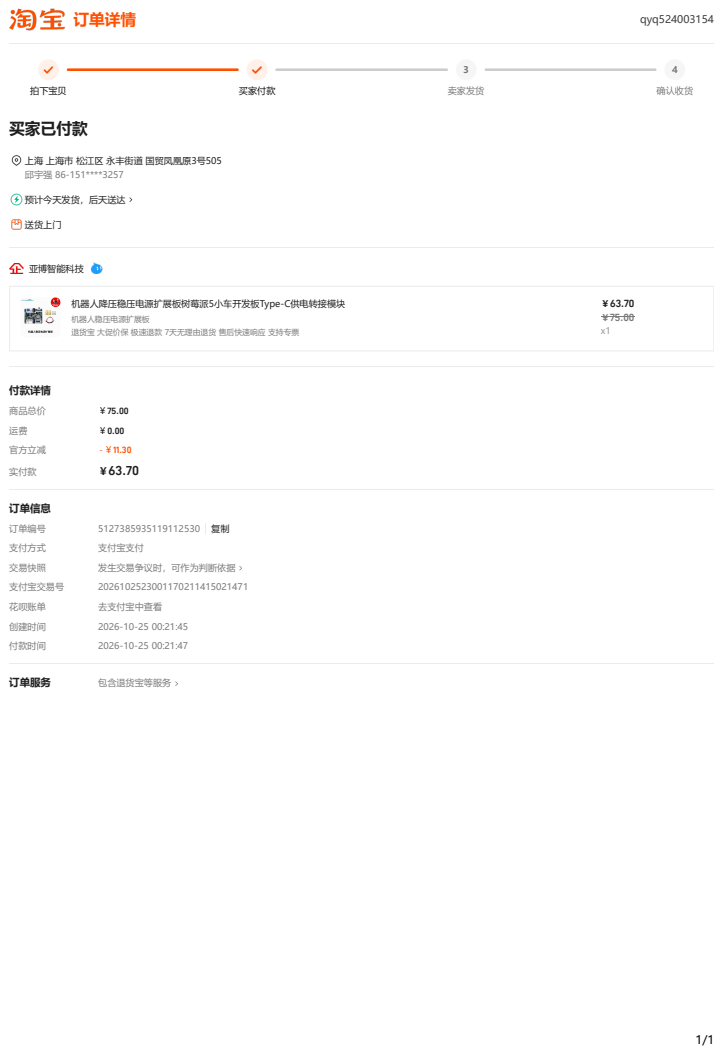
[picture p140: page 1]
订单详情; qyq524003154; 拍下宝贝; 买家付款; 卖家发货; 确认收货; 预计今天发货，后天送达; 送货上门; 亚博智能科技; 付款详情; 商品总价; 官方立减; 实付款; 订单信息; 订单编号; 支付方式; 支付宝支付; 交易快照; 发生交易争议时，可作为判断依据; 支付宝交易号; 花呗账单; 去支付宝中查看; 创建时间; 付款时间; 订单服务; 包含退货宝等服务

上海 上海市 松江区 永丰街道 国贸凤凰原3号505
邱宇强 86-151****3257

机器人降压稳压电源扩展板树莓派5小车开发板Type-C供电转接模块 (https://a.m.taobao.com/i789594995509.htm?from=detail)
机器人稳压电源扩展板
退货宝 大促价保 极速退款 7天无理由退货 售后快速响应 支持专票
