qyq11/opto-chess-robot-2027/03_hardware/01_机械/01_厂家资料/01_T5X四驱/02_底板孔位图.pdf

# 四驱底盘安装孔位

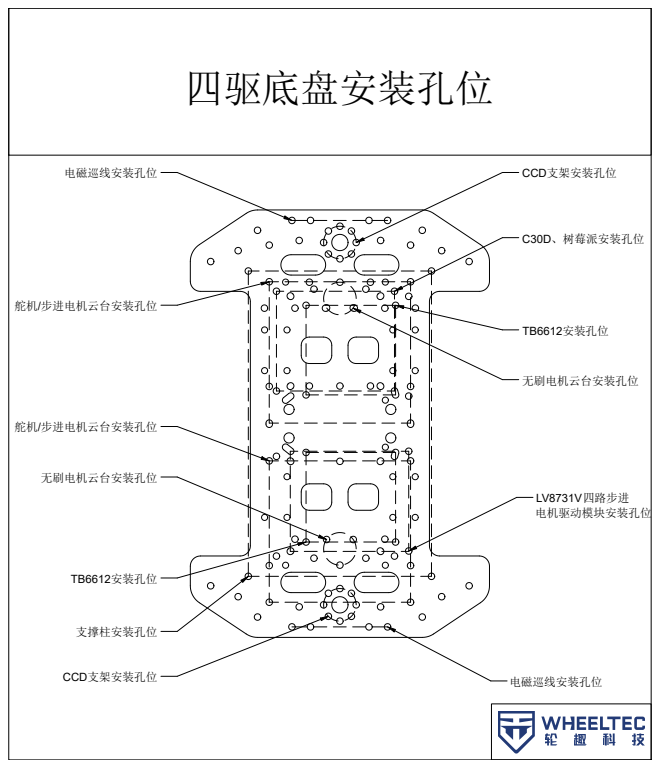
[picture p141: page 1]
电磁巡线安装孔位; CCD支架安装孔位; 舵机/步进电机云台安装孔位; 支撑柱安装孔位; TB6612安装孔位; C30D、树莓派安装孔位; LV8731V四路步进 电机驱动模块安装孔位; 无刷电机云台安装孔位
