qyq11/opto-chess-robot-2027/03_hardware/01_机械/01_厂家资料/02_310电机/06_四孔支架尺寸.pdf

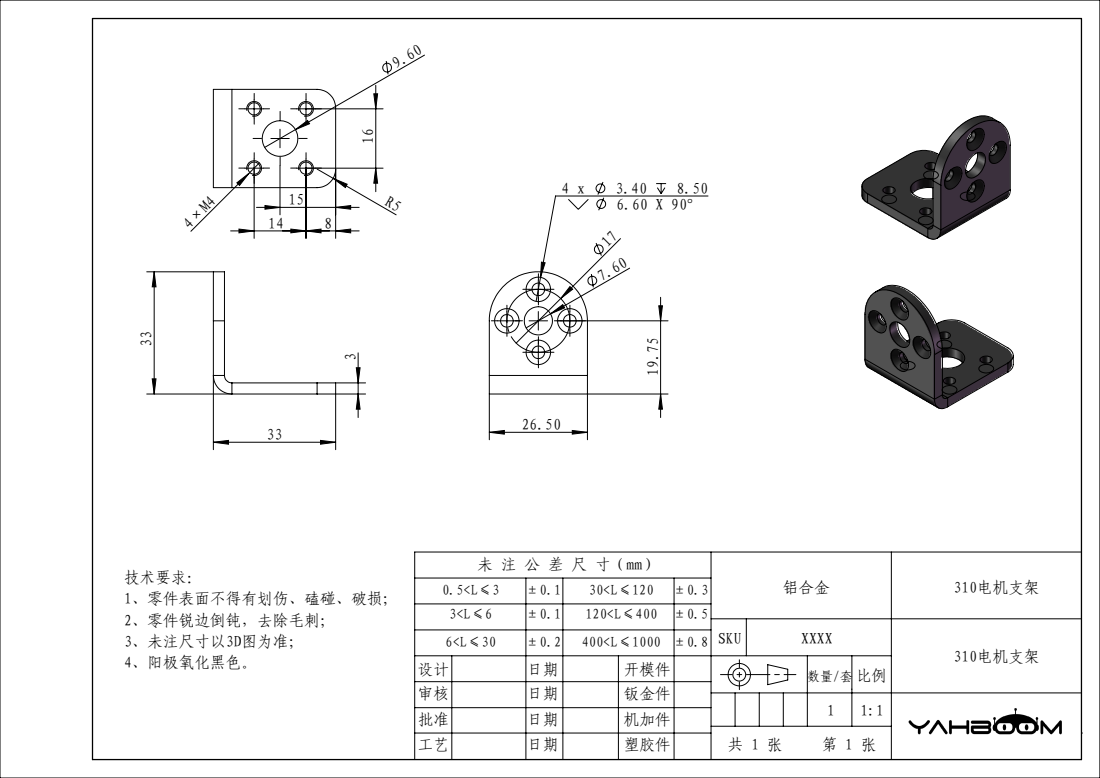
[picture p142: page 1]
