qyq11/opto-chess-robot-2027/03_hardware/01_机械/01_厂家资料/03_四路电机驱动/12_STM32串口工程/USER/AllHeader.h

#ifndef __ALLHEADER_H
#define __ALLHEADER_H


//ͷ�ļ�	Header Files
#include <stdio.h>
#include <string.h>
#include <stdlib.h>
#include <math.h>
#include <stdbool.h>
#include <stdint.h>
extern uint8_t times;

#include "stm32f10x.h"
#include "stm32f10x_gpio.h"

#include "myenum.h"

#include "delay.h"
#include "bsp.h"
#include "usart.h"

#include "bsp_motor_usart.h"
#include "app_motor_usart.h"

#include "bsp_timer.h"



#endif
