qyq11/opto-chess-robot-2027/(commit log)

2026-10-13 chore: initialize opto-chess-robot-2027 project
    [研究下载清单.csv]
2026-10-13 清理无效资料并规范临时文件管理
    [研究下载清单.csv]
2026-10-19 修改官方资料
2026-10-23 按编号重组项目并搭建 Docusaurus 文档站
2026-10-24 同步整机采购、模型与进度记录并清理旧资料
    [01_采购台账.xlsx, 02_零件库.FCStd, 03_20261024_京东_订单导出_3661477012483787.xlsx, 03_整车布局.FCStd, 04_整车布局.step, 310Motor.STEP, 310Motor_Bracket-NEW.STEP, D01.step]
2026-10-24 修改会议报告相关MD文件和PDF
2026-10-30 整理机械与采购更新并清理缓存和中间文件
    [01_310电机.STEP, 01_四路驱动_V2.STEP, 01_采购台账.xlsx, 02_四孔支架.STEP, 02_零件库.FCStd, 03_3mm六角联轴器.STEP, 03_底板孔位图.dwg, 03_整车布局.FCStd]
2026-11-02 同步相机建模、底盘调试与采购资料并清理缓存
    [01_采购台账.xlsx, 02_零件库.FCStd, 03_整车布局.FCStd, 04_整车布局.step, D05_相机杆与相机安装板.step, P11_IMX415 100度M12 30针MIPI相机.step, P11_微雪OV4689 4MP USB Camera A SKU34767.step]
2026-11-03 保存推铲与相机支架、相机采集记录并清理缓存
    [01_导向推铲.stl, 02_左支架.stl, 02_零件库.FCStd, 03_右支架.stl, 03_整车布局.FCStd, 04_推铲打印工程.FCStd, 04_整车布局.step, 05_推棋装配预览.FCStd]
2026-11-06 保存相机网页与底盘控制进展并清理中间文件
    [02_零件库.FCStd, 03_整车布局.FCStd, 04_推铲打印工程.FCStd, 05_推棋装配预览.FCStd, 20261104_motor_uart_network_01.json]
2026-11-07 精简项目首页并迁移使用说明
2026-11-12 归档碳纤维板导出包并清理中间文件
